mattjoyce/xyz-arm/cad/README.md

XYZ Arm Mk1 low-poly concept
==========================

Files: `xyz-arm.scad` is the assembly; `parts/` holds reusable models; `studies/` holds reference viewers; `previews/` holds rendered images and the section SVG. Original datasheets and third-party references remain in the project root's `datasheets/` and `references/` folders.

Open [xyz-arm.scad](xyz-arm.scad) in OpenSCAD and press F5. Use the Customizer to adjust gantry height, whole-gantry extension, and phone dimensions. All dimensions are millimetres.

The assembly follows `../design.html`: 500 mm vertical and horizontal 2020 rails, four wheels with 150 mm vertical spacing, manual lock, top line guides and counterweight, flat screen-up phone, a second four-wheel plate supporting the sliding horizontal rail, and a tip-mounted light. Orange identifies concept brackets and the balance line. The A4 mat can be hidden.

This is a spatial blockout, not a printable or mechanically validated assembly. The rails now use the dimensioned OpenBuilds profile; hardware remains simplified. The 160 × 76 × 9 mm phone, base, rear counterweight shoe, guide bracket and cradle are provisional. The balance line is exaggerated to 1.1 mm diameter for visibility. Motor provisions and detailed fastener clearances are not modelled yet.

The source's side sketch puts the phone under the rail, while its thermal-pad requirement suggests contact above it. This model uses the latter: phone back on a pad above the rail, with the entire corner camera cluster projecting beyond the rail tip. Actual phone camera position and cradle clearances need measurement. The counterweight follows the carriage in the opposite direction; its guide and travel still need detailed design.

Iteration 2: the phone and light are fixed at the end of the horizontal rail. `gantry_extension` moves the whole 500 mm rail through an independent X wheel plate on the Z carriage. The rail is offset in front of the spine to allow its rear end to pass freely. X wheel stations are provisionally 96 mm apart. The camera cluster clears the tip by 8 mm; phone size and actual camera offsets still need measurement. This supersedes the independently sliding phone carriage in the original design note.

Iteration 3: the balance line now rises inside the front Z slot (negative Y), crosses the top over two provisional 4 mm smooth transverse rods, and descends in the rear slot to a counterweight lug. Two quarter turns keep the top low: the default line centre rises only 5 mm above the extrusion end. Side cheeks leave the slot exits open. `guide_diameter` adjusts the concept rods; no minimum suitable diameter or hardware has been selected. Friction, braid wear, rod finish and retention need evaluation before deciding between smooth rods and miniature pulleys.

Iteration 4: `parts/vslot-2020.scad` defines the shared rail profile from page 1 of `../datasheets/openbuilds-vslot-20x20.pdf`. Open it directly for a 60 mm sample, or enable `section_only` for its cross-section. `previews/vslot-2020-section.svg` is an exported section at nominal millimetre scale.

The profile uses the drawing's 20 mm envelope, 9.16 mm V mouth, 6.25 mm throat, 11 mm internal channel, 1.80 mm shoulder depth, 4.30 mm shoulder-to-floor depth, 90° V, 1.50 mm diagonal webs and Ø4.20 mm bore. The diagonal channel coordinates are derived from the normal web thickness, not traced by eye. Only the undimensioned outer corner radius (0.5 mm) and small central floor notches (0.2 mm) are estimated. The bore uses 64 facets independently of the assembly's low-poly setting. These are nominal dimensions, without manufacturing tolerances.

Validation: the sample exports as a closed mesh (every edge has two incident triangles), with a 20 × 20 × 60 mm bounding box. The complete assembly compiles and renders with the new shared profile.

Iteration 5: `parts/vslot-wheel.scad` replaces all eight cylindrical wheel placeholders with Solid V wheels and nominal 625 bearing pairs. Supplier reference: https://www.makerstore.com.au/product/wheel-solidv-kit/ ; drawing archived as `../datasheets/solid-v-wheel-drawing.jpg`. Uses 23.90 mm OD, 5.90 mm central tread land, 16 mm bearing seats, 14 mm central shoulder opening, and 5 mm axle bores. The kit lists 10.23 mm width whereas the drawing says 10.20 mm; the model uses the kit width. Chamfers are modelled at 45 degrees to mate with the rail faces. Bearing internals, seals, 0.23 mm central shoulder/shim and spacer shapes are simplified nominal representations.

Wheel axes now align with the rail slot centre plane. Tangency of the model's chamfers gives a wheel-axis offset of 20.32 mm from the rail centre (40.64 mm between opposing axles), with no preload. Both plates use nominal 6 mm spacers plus 1 mm external shims. Hex spacers identify the intended eccentric pair on one side of each rail; actual eccentric offsets, plate holes and hardware tolerances still need detailing. These are Solid V wheels, not grooved Dual V or Mini V wheels; confirm the purchased variant before making plates.

Iteration 6: compact carriage replaces the tall Z plate, wide X plate and connecting block. `parts/compact-carriage.scad` is a new 84 × 84 × 8 mm parametric plate, inspired by the Open Task Light body's envelope. It does not reuse that STL's hole pattern. Four wheels on each face preserve the two sliding axes. Both longitudinal wheel spacings are now 60 mm; across-rail spacing remains 40.64 mm. The 8 mm plate and nominal spacer stacks set rail centre separation to 32.23 mm. Mounting holes and two access windows are modelled; eccentric seats and lock hardware remain provisional.

At the original design note's illustrative 2.1 N·m moment, reducing Z spacing from 150 to 60 mm raises the force couple from about 14 to 35 N. This compact layout therefore needs a fresh load and settling check before fabrication. The original Open Task Light mesh remains separately available in `studies/carriage-study.scad`.

Iteration 7: three wheels per rail, six total. Each axis has two fixed wheels 60 mm apart and one central opposing wheel marked for eccentric adjustment. The shared `carriage_z_holes()` and `carriage_x_holes()` functions drive both the plate holes and assembly positions. The outline now follows the six mounting bosses and line/lock supports instead of a full square; a central access hole removes more material. The X lock placeholder is offset to clear its new central wheel. This removes two complete wheel assemblies; actual mass saving depends on purchased hardware and print settings. Eccentric seats, preload, stiffness and lock details remain unvalidated.

Iteration 8: `parts/wheel-spacer.scad` adds four concentric spacers and two eccentric spacers (gold in assembly), one per axis. The eccentric pilot axis is offset 0.395 mm from the axle, interpreting the supplier's approximate 0.79 mm adjustment range as total travel. Each adjustable plate hole follows the pilot centre, while the wheel stays at nominal tangency in the shown position. Supplier: https://www.makerstore.com.au/product/shim-eccentric-8-6/ — 6 mm standoff, 8 mm hex across flats, 10 mm flange, 5 mm bore and 7.11 mm plate hole. Collar length (1.5 mm), flange thickness (1 mm) and pilot diameter (7.08 mm) are provisional; verify against purchased parts. The flange is included within the 6 mm standoff. Hex rotation in the standalone model is an orientation parameter, not an assembled preload simulation. Nominal holes require a fit coupon before printing the final plate.

Iteration 9: removed both placeholder carriage locks, their brackets/pads and extra plate support lobes. The Olight is now fixed beneath the phone on a small magnetic disc connected to the cradle edge, with its lens pointing down. The previous outboard arm is removed. With the nominal 76 mm phone width, the 24 mm torch body sits beside the rail with 2 mm lateral clearance and stays within the phone footprint; the 28 mm disc reaches its edge. Position is toward the phone's non-camera end. Torch and mount remain approximate pending actual Olight dimensions.

Iteration 10: counterweight container is fixed at 20 mm external width across the spine. Depth extends rearward from a fixed front face at Y=14 mm, so increasing capacity does not move it toward the rail. Defaults: 60 mm depth, 90 mm height, 2 mm walls and floor; open top. `counterweight_depth` and `counterweight_height` are adjustable in the Customizer. This gives 78.85 cm³ nominal internal volume at default dimensions. Fill mass depends on material and packing; balance has not been sized from this volume. Rear shoe and line lug remain provisional and fit within the 20 mm width.

Iteration 11: `parts/z-base.scad` is the rotating base — a 140 mm plate that bolts to the turntable bearing and carries the vertical 2020. Ø140 × 51 mm, manifold, prints flat with the socket upward and needs no supports. Eight ribs at 22.5° offsets carry the plate out to the bolt circle, clearing the four mounting holes (128 mm PCD, at 0/90/180/270) and four screwdriver access holes (102 mm PCD, at 45° offsets) used to reach the other race's fixings through the plate.

Which race this bolts to is now settled: the **inner** one. A 2026-09-13 zoom on the race boundary shows countersinks on the outer ring and plain holes on the inner. A countersink seen from above takes a flat head driven downward into whatever sits below, so the outer ring is what screws to the desk and the inner ring rotates and carries this part — standard lazy-susan practice, and consistent with the brief's own fallback.

An earlier note here claimed swapping `mount_pcd` and `access_pcd` was the whole change. **That was wrong.** The underside relief has to move with the bolt circle: the plate bears on its mounting race and must clear the other, so mounting inboard means relieving *outboard*. Relieving the wrong annulus would have left the plate resting on the fixed outer ring and rubbing as it turned. `mount_race` now drives the bolt circle, the access circle and the relief annulus together, and both settings build.

A further trap caught while making that change: the derived values sat above `plate_d` in the file, and OpenSCAD resolved the forward reference to `undef`, so the relief silently evaluated inside-out. The assert caught it; the relief now keys off `bearing_od`, which is declared above and is the more meaningful bound anyway.

No central screw into the rail's tapped Ø4.2 end bore. Its head counterbore (Ø9.5, reaching y = −4.75) collides with the rear slot channel the balance line runs down (y = −3.90 to −8.20 from the profile drawing); the two cannot share the socket floor. The rail is instead held by four M5 bolts into drop-in tee nuts in both side slots at two heights (14 and 34 mm above the plate), which resists the tipping moment as a force couple rather than as clamp friction on a plastic floor. **Slide the tee nuts in before seating the rail** — its lower end is captive in the socket.

The balance line runs straight down inside the rail's rear slot and through a Ø4 hole at y = −6.05, asserted to stay clear of both the slot floor and the shoulder. Keeping it in the slot rather than outside the rail also keeps it near the rotation axis, so a ±45° sweep moves it about 4.6 mm rather than 13.8 mm — which sets how big the hole through the desk needs to be.

Load check: at 2.18 N·m the socket's square section (32.4 mm outside, 20.8 inside, S = 4929 mm³) sees **0.44 MPa**, roughly a hundredth of PETG's yield. Strength is not the question here; stiffness and long-term creep are, which is what the ribs are for. Print with generous wall count rather than relying on infill. Tee bolts see about 109 N each, trivial for M5.

Not yet resolved: the bearing's bore, race boundary and hole pitch circles remain photo estimates from `studies/turntable-bearing.md`, and every one of them feeds this part's geometry. Measure them before printing a final part. The asserts will catch a combination that cannot be built, but they cannot catch numbers that are merely wrong.

Wheel spacing stays compact at 60 mm by explicit decision, accepting about 40 N per wheel pair at the corrected 2.4 N·m rather than 16 N at 150 mm. To be revisited only if it proves to settle too slowly in use.

Iteration 12: the assembly adopts the real base. `frame()` drops the 180 × 160 blockout slab and its accent cone for `turntable_bearing()` on the desk, `z_base()` bolted to it, and the rail seated in the socket floor. The Z datum is now explicitly the **desk surface**: bearing 0–8.5, plate 8.5–14.5, rail seated at 16.5. `base_h` is computed from `turntable_thickness()` and `zbase_rail_seat()` rather than the old hardcoded 12, so changing either part moves the assembly with it. Both parts gained accessor functions for this; `use` imports modules and functions but not top-level variables, so the assembly could not otherwise see their internals.

The counterweight leaves the spine. It was a 20 mm slab riding alongside in the rear slot; it is now a plain pot hanging below the desk on the line, because the desk-mounted build removes the envelope that forced the slab shape. Defaults are Ø60 × 80 mm — about 222 cm³, which is 1.02 kg of steel shot at bulk 4.6 g/cm³, or the same mass in lead at Ø60 × 53. `counterweight_diameter` and `counterweight_height` replace the old depth/height pair. Travel mirrors the carriage: the pot starts 20 mm below the desk and descends as the gantry rises.

The balance line's rear run now goes straight down the rear slot, through the base's Ø4 hole at y = +6.05, and through the desk. `z-base.scad`'s `line_y` moved from the front slot to the rear to match — the sign only selects which slot, and the assert on the channel bounds holds either way. A new `show_desk` draws an 18 mm slab with the 25 mm pass-through, sized for the line's ±45° arc.

The mat also moved. It was drawn at z = −3.5 to −0.5, i.e. floating below the desk surface it is meant to sit on; it now occupies 0–3 with its grid on top.

Clearance check at the bottom of travel: the socket's top lands at z = 59.5 and the carriage's lower edge at `gantry_height` 110 reaches z = 68, leaving **8.5 mm**. The camera then sits about 117 mm above the desk, so roughly 114 mm above the mat's top face — inside the 98 mm close-focus limit with margin, and at the bottom of the 100–300 mm useful band. The socket depth therefore sets the bottom of the working range, and shortening it would buy back travel that the optics cannot use anyway.

Iteration 13: bought and context geometry now carries the `%` background modifier — rails, wheels, spacers, axles, guide rods, the bearing, the balance line, phone, Olight body, mat and desk. They still draw for reference but are excluded from render and export, so what survives an F6 is exactly the set of printed parts: 7050 facets, with the desk and mat gone from the bounding box. This replaced an earlier attempt to back the wheels off the rail by 0.02 mm, which was hacking around a display artefact rather than stating the intent.

`rod()` gained an epsilon extension at both ends. The balance line is drawn as a chain of segments that previously butted end-to-end, sharing an exact coplanar face — the classic way to make a union non-manifold. The counterweight lug and the mat grid lines had the same problem against the surfaces they sat on, and were sunk slightly into them.

On the 2-manifold warning, what was actually established rather than assumed: `frame()` and `moving_arm()` each render clean **alone**, and so does every part in `parts/`. The assembly does not. Toggling the mat, desk and phone off changes nothing, so the cause is not the context geometry. The wheels are placed at nominal tangency to the rail — Iteration 5's note says so explicitly — and two solids touching along a line are neither disjoint nor overlapping, which is exactly the degenerate case. `%` disposes of that for the export.

A warning still remains among the printed placeholder brackets (cradle, lugs, light mount), and is **not** resolved. It is not worth more CGAL renders: parts are printed individually, each one is clean on its own, and the assembly exists to check spatial fit rather than to be exported as a body. Worth revisiting only if those brackets stop being placeholders.

Individual parts are checked separately — `z-base.scad` renders `Simple: yes` with 1248 facets, and all four tee-bolt holes were verified present in its mesh rather than by eye, since the render angle hides the upper pair.

Iteration 14: `parts/base-fit-test.scad` is a Ø145 × 2 mm gauge that answers both open base questions in one short print, rather than committing to the Ø140 × 51 mm part.

Three 2020 apertures at 0.15 / 0.30 / 0.45 mm per side span wide on purpose; narrow the bracket on the next print once this says which end is right. Corner reliefs are included because FDM cannot cut a sharp internal corner — without them the nozzle's corner bulge carries the fit and the flats never seat, so the reading would be corner interference rather than clearance. Both candidate bolt circles are on the rim, so the 102 PCD can be confirmed while 128 stays available as a cross-check on the photo estimate.

Marking is tally holes, not text: round holes print at travel speed where small glyph perimeters do not. They sit below their aperture, which keys the orientation — read them above and the plate is flipped, and the clearance order would otherwise reverse.

Four hull cutouts remove 36 % of the disc, against 12 % for an earlier field of twenty small perforations. Each is verified by `studies/check-cutouts.py`, which measures point-to-segment distance from every cutout to the aperture zone, all eight bolt holes and the rim. Two of the four failed first time. The instructive one was the top cutout: its vertices cleared the diagonal bolt at 12.7 mm while the **edge between two vertices** passed within 5.32 mm — invisible in plan view, and the reason this is checked numerically. Worst case as built is zone 4.50, bolt 7.00, rim 7.55 against needs of 4.0 / 6.6 / 3.5, with left and right deliberately backed 0.5 mm off their exact limits so polygon tessellation cannot eat the margin. Re-run the script after changing any cutout number.

Lightening stops there on purpose. A gauge earns its keep by being a rigid reference; perforate 2 mm further and it flexes, and a flexing plate can be forced onto a bolt pattern that does not line up or deformed around a rail that is really too tight — a false pass on both tests at once.

What the print cannot settle: a 2 mm aperture reads XY clearance almost purely, whereas the real socket is 45 mm deep where wall lean and friction both bite, so the winning clearance will feel tighter at full depth. And the number belongs to the printer, nozzle, material, layer height and XY compensation, not to the geometry.

Iteration 15: the base's eight ribs are gone. A truncated cone now runs from the plate top to the socket mouth: Ø88 at the foot, flat top flush with the top of the socket at 45 mm, Ø49.1 there (the boss's 44.1 mm corner diagonal + 5), so the flank rises at about 67°. The square boss is swallowed whole and the rail rises out of a plain round face. It narrows upward, so it still prints without supports. Asserts keep the foot 2 mm inside the mount screw pilots (whose tips come up through the plate) and the screwdriver access holes. Both tee bolt pairs, at 14 and 34 mm, now sit inside the cone, so their Ø9.5 head bores run straight out through it (about 13 mm deep), and a hex key reaches them from outside. The cone's derived sizes are declared after `boss`, because of the forward-reference trap from Iteration 11.

Socket clearance is 0.375 mm per side, halfway between the gauge's two workable apertures: 0.45 slid on easily, 0.30 went on hard at only 2 mm deep. Mount holes are Ø3.5 pilots for M4 self-tapping screws driven up through the bearing's inner ring. The float lives in the bearing's own loose holes. The rail hold-down is M5 × 8 socket heads into drop-in tee nuts; 10 mm would bottom out in the slot channel. Previews: `previews/z-base.png`, `z-base-section.png`, `z-base-context.png`.

The plate no longer covers the outer race. Mounted on the inner race, it is Ø112: the race boundary estimate (114) less 1 mm radial gap. The access holes and underside relief are gone, and the outer race's countersunk desk screws are simply in the open. That leaves 3.25 mm of plastic outboard of each Ø3.5 pilot on the 102 circle, asserted ≥ 3. The boundary is still a photo estimate, and if the real one is smaller the rim will rub as it turns. `mount_race = "outer"` still builds the full Ø140 plate with access holes and relief.

Edges: the plate and cone are now one revolved profile (the square boss was wholly inside the cone, so it is no longer modelled). Rim chamfers are 1.0 mm top and 0.5 mm bottom; the bottom one also clears elephant's foot. The cone foot has a 4 mm fillet, where the tipping moment concentrates, and its top edge a 2 mm round. The socket mouth has a 1 mm lead-in chamfer and each M4 pilot a 0.5 mm one on the underside. `fillet_pts()` builds both the fillet and the round from the corner and its two edge directions. The four tee bolt bores are left sharp, since they meet the curved flank.

Race boundary taken as 113 (1 mm under the 114 photo estimate), so the plate is Ø111. That cuts the plastic outboard of each pilot to 2.75 mm, and `mount_edge_min` is relaxed to 2.5 to allow it. With four perimeters that is nearly solid wall.

Iteration 16: `z-base.scad` gains `variant = "full" | "fast"`. Full is unchanged: its re-exported STL has the identical vertex set, and it is still `parts/z-base.stl`. Fast is `parts/z-base-fast.stl`, exported with `-D 'variant="fast"'`. It has the same bearing pilots, socket, fit, line hole and tee bolts, at about a third of the volume (70 cm³ against 204).

- **Plate:** a Ø70 hub with four 12 mm arms out to round screw lugs, replacing the Ø111 disc. The lugs reach the same Ø111 rim, so the pilot edge is still 2.75 mm. The arm roots are filleted.
- **Socket:** stands as an open square boss on a 12 mm flared, filleted foot instead of being buried in the cone. The tee bolts rise to 20 and 38 mm, so their counterbores sit on the open boss face above the foot. M5 × 8 still applies, and there are no bores through a flank.
- **Check:** arm bending at the hub is about 6 MPa at 21 N per screw. That is fine for strength, but it is the softest part of this variant.

Context previews now turn the bearing's free inner ring so its holes sit under the pilots.

Tee screw length, corrected. The earlier "M5 × 8, 2.8 mm under the head" was wrong for the model as built. The counterbore starts 1 mm proud of the boss face, so a 3 mm sink left 3.8 mm of wall, and an M5 × 8 would reach only 2.0 mm past the slot lip. The sink is now 4 mm (2.8 mm of wall), which gives 3.0 mm into the tee nut. Asserts now check the stack: M5 × 6 fails as too short, and M5 × 10 fails because it bottoms in the 4.3 mm channel. Both STLs are re-exported.

Iteration 17: the tee bolt holes become nut windows. The rail is held by drop-in tee nuts in its side slots, and once it is seated in the socket the only way into a slot is through the socket wall, so a Ø5.5 bolt bore is no use: the nut has to pass through the wall first. Each station is now a rectangular window, `tee_nut_w + 2·clr` across the slot by `tee_nut_l + 2·clr` along it — 6.8 × 10.8 for the standard 20-series M5 nut (10 × 6 × 4) at 0.4 mm clearance — with 0.5 mm corner radii. The nut goes in long side up the slot, drops through the 6.25 mm throat, and the screw turns it home in the channel, as for any blind drop-in. Both variants share `tee_windows()`.

The head no longer has a full seat: the M5 socket head is Ø8.5 and the window 6.8 wide, so it bears on two 0.85 mm strips beside the window (asserted ≥ 0.75). Screw stack at that point: 3 mm counterbore into the wall, M5 × 8, 3.0 mm into the nut (changed in iteration 19). If the seat crushes, a button-head or flanged M5 spreads it. In the full variant the flank bore grows from Ø9.5 to Ø12 (`tee_access`, asserted ≥ window height + 1) so the nut can pass it on the way to the window; the fast variant keeps the Ø9.5 counterbore, which the window's ends run 0.65 mm past on the open boss face. Top-of-socket and foot clearances now use the larger of head and window. Volumes: full 200 cm³, fast 69. Preview: `previews/z-base-fast-window.png`.

Note for headless work: the revolved body of the full variant does not draw in OpenCSG `--preview` from the command line, only its cutters do. `--render` is fine and all previews are made that way.

Iteration 18: `variant = "fins"`, exported to `parts/z-base-fins.stl`. It keeps the fast variant's hub-and-arms plate and its bare square boss, and takes three things out. The flared foot is replaced by four gusset fins, 2.4 mm thick and 30 mm up the boss, each running from a boss corner out along an arm to 44 mm, short of the lug (asserted). The socket floor is cut out, so the pocket runs through the plate and the rail is located by its tee bolts alone; it can drop on through the bearing bore to whatever is under it, and `zbase_rail_seat()` now returns 0 for this variant so the assembly places it at the plate underside. The boss is turned 45° about Z (`boss_turn`), which is what lets the fins root at the corners and leave the nut windows on the faces alone; the rail's slots, and with them the tee windows and the balance line's rear slot, therefore point at 45°, 135°, 225° and 315° on this base, not down the arms. The lower tee pair goes back to 14 mm, since nothing is in the way. No line hole is cut: the rear slot is open to the underside through the pocket. Fast and fins share `boss_body()`, `tee_counterbores()` and `rail_pocket(through=)`. Volume 53 cm³ against 69 for fast. Previews: `previews/z-base-fins.png`, `z-base-fins-under.png`.

Iteration 19: tee screws are M5 × 10, the length on hand, instead of × 8. The head counterbore now stops 1 mm into the wall rather than 3 (`tee_head_sink` 2, from 1 mm proud of the boss face), so 4.8 mm of wall sits under the head and a 10 reaches 3.0 mm into the nut, the same engagement the 8 had with the deeper sink. The asserts still bracket it: 2.5 mm minimum in the nut, 3.5 maximum before the screw bottoms in the 4.3 mm slot channel. The head stands about 4 mm proud of the boss face in fast and fins, which nothing obstructs; in full it is reached through the same Ø12 flank bore. All three STLs re-exported.

Head diameter measured at 9.26 mm, which is an M5 button head, not the 8.5 mm cap head assumed so far. `tee_head_d` is now that measurement and the counterbore `tee_head` is derived from it, 0.6 mm a side, so Ø10.46. The wider head helps the nut window: the seat strips either side of it grow from 0.85 to 1.23 mm. In full the Ø12 flank bore already clears it. All three STLs re-exported.

Tee nut measured at 9.85 × 5.9 mm, replacing the nominal 10 × 6. The windows follow: 6.7 across the slot by 10.65 along it at the same 0.4 mm clearance, and the head seat strips are 1.28 mm. All three STLs re-exported.

Iteration 20: the tee bolt entry is a switch, `tee_entry = auto | window | round`. A drop-in nut sits wholly inside the slot, so nuts can be loaded before the rail goes in and found blind through a plain Ø5.5 hole; the window only adds fitting a nut with the rail clamped. Auto gives windows where the rail is captive (full, fast) and round holes where it slides through (fins), so on fins the 9.26 mm head gets a full ring seat again and the boss face keeps more of its wall. `tee_holes()` cuts either. Nut loading on fins: bolt heights are 14 and 34 mm above the plate top, so with the rail standing on the desk through the bearing bore the nuts sit about 28.5 and 48.5 mm up from its bottom end. `z-base-fins.stl` re-exported; preview `previews/z-base-fins-holes.png`.

`parts/socket-test.scad` is the top 20 mm of the fins variant's boss on its own (`test_h`), keeping the mouth lead-in: 32.35 mm square, through pocket at the 0.375 mm/side fit, one bolt station, the base's upper one, 9 mm up the piece, with the round Ø5.5 holes and Ø10.46 counterbores, and nothing else. One station tests everything the holes need testing; `tee_holes()` and `tee_counterbores()` take a heights list for it. It is built from `z-base.scad`'s own `boss_body()`, `rail_pocket()`, `tee_holes()` and `tee_counterbores()` under `use`, so it is the same geometry as the base and a pass on it is a pass on the base. 12 cm³. Exported to `parts/socket-test.stl`, preview `previews/socket-test.png`.

Iteration 21: keyhole entry for the tee nuts, after the socket test. Round holes printed and screwed up fine, but loading nuts blind into a 500 mm rail is a fight, and a plain window costs the head its seat. `tee_entry = "keyhole"` puts the nut window above the hole and joins the two with a slot the width of the screw shank: start the screw two turns into the nut, feed the nut through the window into the rail slot, slide the screw down until the head drops into its counterbore, tighten. The nut rides captive on the screw and the head seats on a ring open only on the slot side. The window sits just clear of the counterbore (`keyhole_rise` = 10.56), so it needs 15.9 mm of wall above each hole and two stations do not fit a 45 mm socket: fins goes to a single pair at 27 mm, its window topping out 2.1 mm under the mouth. If one pair lets the rail rock, `socket_h = 55` makes room for two again. Auto now gives keyhole on fins, windows on full and fast; the asserts catch a keyhole into the mouth or into the next station's counterbore, and one into a buried boss. `z-base-fins.stl` re-exported (53 cm³). `socket-test.scad` follows: top 25 mm of the socket, the keyholed station 7 mm up, 14 cm³.

Iteration 22: the two fins stations share one keyhole window. The socket stays 45 mm. The window sits midway between the stations, at 23 mm, and a shank-wide slot runs from it down to the lower hole and up to the upper one: each screw goes in with its nut at the window and slides to its own counterbore, one down, one up. Stations are 10 and 36 mm, a 26 mm couple, with 4.8 mm of wall under the lower counterbore and 2.8 above the upper. `keyhole_dir = drop | lift | shared` picks the layout; auto is shared on fins. `keyhole_mid` is declared after `tee_heights` on purpose, because the first cut of this had it before and the forward reference came back undef: every assert passed, both meshes rendered `Simple: yes`, and neither had a keyhole in it. Check the previews, not just the asserts. `z-base-fins.stl` re-exported, 52 cm³. `socket-test.scad` is now the whole 45 mm socket with both stations, since the shared window spans them, 25 cm³.

Iteration 23: three changes to the fins socket. A flat ledge at the underside of the through pocket, 2 mm in from the pocket wall and 2 mm thick (`ledge_w`, `ledge_t`), so the rail's end sits on it at 2 mm above the plate underside instead of dropping through; the opening below is 16.75 square, and an assert keeps the balance line's rear slot inside it. The boss's top outer edge gets a 1.5 mm chamfer (`boss_chamfer`), leaving a 3.3 mm flat rim between it and the mouth's lead-in. And the tee bolts are on one face only (`tee_sides`, the boss's local +X face, which the 45° turn puts at 45° to the arms): the two screws pull the rail onto the opposite wall, so the ledge and that wall are the datum, rather than two sides fighting over the clearance. `zbase_rail_seat()` returns the ledge thickness for fins. `z-base-fins.stl` re-exported, 54 cm³. `socket-test.scad` follows, with the ledge at its bottom and the chamfer at its top, 27 cm³; previews `socket-test.png` and `socket-test-under.png`.

Iteration 24: `parts/belt-collar-test.scad`, the two collars that anchor a GT2 belt to the spine for the Z brake, on their own. The belt was going to be the brake's rack (kanban `ukrp`); a gravity tilt lock on a smooth rod was considered and parked. The belt lies on the floor of one slot channel, 3.9 mm from the rail centre, its top at 5.28, wholly under the rail's surface, and each end is held by the tip of the base's own tee bolt, an M5 × 10 button head, driven straight into the collar wall and in through the slot throat onto the belt. Not into a tee nut: the channel is 4.3 mm deep under the lips, a drop-in nut about 4 mm tall and the belt 1.38, so the two cannot stack in one channel. The screw forms its thread in the wall, a Ø4.3 hole for M5 in PETG, with the head sunk 2 mm so the 10 mm screw reaches: tip at 4.18 from the rail centre, 1.1 mm into the belt, 3.8 mm of wall under the head, and it cannot bottom on the aluminium floor at 3.9. Two pieces: `ring`, an open 20 mm sleeve standing for the base socket's wall, and either a second ring (`with_cap = false`, the default, 24 cm³ the pair, printed first) or `cap`, the same sleeve with a 3 mm closed top, so that belt tension pulls it down onto the rail's end face and it needs no other fixing. Both use `boss_2d()` and `pocket_2d()` from `z-base.scad`, so the fit is the settled 0.375 mm a side. Asserts check the bite, the floor and the thread depth. Previews `previews/belt-collar-test.png`, `belt-collar-test-context.png`. Test: ring and cap on the two ends of a rail offcut, belt down the +Y channel between them, screws driven until they stop on the belt, and pull. The question is whether a screw tip on rubber holds 10 N without creeping, or the belt end wants a pin through it. Not settled: which slot the belt takes on the spine, since the wheels have both sides and the line has the front slot above the carriage and the rear slot down to the counterweight.

Iteration 25: the Z brake is set aside for balance (see `notes/2026-09-19-balance-and-friction.md`) and two parts follow from that. `parts/spine-cap.scad` caps the spine's top and carries the balance line over it, front to back. It went through three cuts in one sitting: a 32 mm collar on the socket fit with a rear ear placing the line 25 mm behind the rail centre; a 20 × 20 rounded crown pressed into the rail; and, as it stands, a square 20 × 20 × 5 block with a 45° V groove, 3 mm wide and 1.5 deep, so it prints upside down with the groove as a 45° cavity and nothing to support. The top's front edge is chamfered 2 mm at 45° and the V follows the chamfer down to the face (hulled V sections, each turned to stay square to the surface), so the line bends twice by 45° on its way down to the carriage. The rear is flat (`rear_chamfer = false`): the top runs level between the ear blocks to the rail's face and the line drops over that edge into the rear slot, at x = 0. Press fit from the rail's own geometry, and the rail is plain T-slot 2020, which is what Matt has, not the V-slot the rest of the model assumes: a tee tab into each side slot, 5 mm long, stem at the 6.0 opening exactly (0.1 a side over it sheared material going in on the first print), and a head that is a diamond, 45° out from under the lip to the 11 mm channel wall (10.6 wide, 4.2 below the face, a 2.2 mm lip a side) then 45° back in to 8 wide at 5.5 deep, with 0.2 clearance everywhere but the opening. `slot_w`, `lip_t`, `chan_w` and `chan_d` are guesses at generic extrusion and want measuring; the opening is what the fit rides on. No centre peg. Every tab face is vertical or 45°, so the tabs stand up cleanly in the flipped print. The front and rear slots are left open for the line. Nothing else fixes it; both runs of the line pull it down onto the rail's end. `print_flip = true` is the exported orientation. A groove is a capstan and the wrap is 180°, so at 10 N and μ about 0.15 the arm costs about 3.8 N to raise and 6 N to lower; a pulley is the fallback. `parts/load-stack.scad` is the counterweight, from two plan sketches of Matt's (Downloads, 2026-09-19): the stack hangs directly behind the spine, riding two guide threads that hang from the cap's rear corners just outside the rail, with the load line dropping from the cap's rear groove into the rear slot. It went through four cuts in the sitting; what stands is a master load, add-on cells and a keeper, and the file's default view is the pieces in a column with gaps, bottom to top, so they can be pointed at without names. The load line hangs inside the rail's slot, so it never passes through a cell, and the guide threads pass in front of the cells, so only the master and the keeper touch a thread. Each has a 5.5 mm lip that enters the rear slot 4 mm, with the load line's Ø2.5 hole in it 1.5 mm inside the rail's face, Ø2.2 holes for the guide threads 6.5 off centre and 14 behind the rail centre matching the cap, and one split: from the lip's tip through the line hole and back along the centre, then a T out to both guide holes, so the guide threads are pinched together and all three threads go in with one forward push; a thread at its hole would have to be walked 6.5 mm sideways to leave. Every piece is an open box, after Matt found the closed master unprintable: the piece above is its lid. Each cell and the keeper has a foot underneath, the cavity's size less 0.15 a side, 2 mm deep, flaring at 45° out to the box, that drops into the open cavity of the piece below, which registers the stack and closes the shot in; no cones, no bridges, no lids. Matt then asked for maximum cavity and a quick print, the master being a static box: walls, floor and foot went from 2 mm to 1.2 (three perimeters) and the solid front to the least that walls the guide holes and the T. Then the master became a sleeve: Matt has two lead-in-resin blocks, 25 × 60 × 85, from another project, so `use_insert` sizes the master round one (`insert_n = 1`, 27.7 × 70 × 87.7 outside, 37 cm³ of plastic) or two side by side (`insert_n = 2`, 52.7 wide), with 0.3 mm of clearance and the rim standing a foot's height above the block so the cell above still registers; `use_insert = false` gives back the 40 × 60 × 80 shot box. Which it is depends on what a block weighs, since the counterweight must match the arm's 1.05 kg, not exceed it. The block fills the cavity, so the M2 for the line's loop moved into the solid front, 12.5 mm behind the rail centre and 3 off centre to keep it clear of the split, head proud under the master, and the T split and guide holes moved back 1 mm to 15 to make room; the cap's ear grew to 9 mm to suit, and the cap printed that afternoon has its holes at 14, which over 400 mm of thread is nothing. The line's path is out of the lip's hole through an eased exit, along a 1.5 × 0.8 mm channel to the screw, loop under the head; loosen, pull the line through, tighten, and that is the length adjuster. While that printed, Matt asked whether the lip and captures were needed over the full height at all; they are not, so `traps = true` keeps them only at the top and bottom, 3 mm each, the lip becoming two short bearings in the slot and the threads running in air between, each trap wedged at 45° back to the box's face, the top one underneath so it prints and the bottom one on top to match and to carry the M2's thread; 24 cm³ of plastic against 37. The first print of that showed a flaw in the wedge, not the print: a wedge was one hull of the trap's body and its lip, and the hull of a wide body plus a narrow lip is not a T in plan, it fills the corners, so just past each trap the flanks ran diagonally from the lip's tip to the body's corners, inside the rail's face and far wider than the slot. The wedges are now two hulls each, the body's back to the box and the lip's own 45° ramp within its 5.5 mm, so the tongue stays a tongue. Matt spotted it on the printed part. A cell matches the master's section, 18 mm tall, 24 cm³ round one block or 47 round two, about 110 or 220 g of steel shot. The keeper is a 4 mm plate with the same lip and split and the foot, and adding a cell is lifting it up the threads. The height budget is the constraint: the stack mirrors the carriage's 310 mm of travel between the cap and the base, so master, cells and keeper must fit in about 130 mm, and the file echoes what its parameters add up to (122 with two cells). For a kilogram in that height the master wants lead shot or a piece of steel bar; steel shot in this section would need 108 mm on its own. `part = column | master | cell | keeper | print | stack | test`. The test is the master's front only, 20 × 12 × 5, with the lip, the holes, the split and the M2 clamp, 1.1 cm³, exported to `parts/load-stack-test.stl`, for setting the fits: the lip in the slot (5.5 in a 6.0 opening), the line through its Ø2.5 hole and 1 mm split, the guide threads through the T to their Ø2.2 holes, the M2 in its Ø1.7 hole clamping the loop. It echoes those numbers when it opens. Previews `previews/spine-cap.png`, `spine-cap-under.png`, `load-stack.png`, `load-stack-under.png`, `load-stack-plan-front.png`.

Iteration 26: the load stack's two guide lines become one loop, and the base turns it round. Matt's call: down from one of the spine cap's rear anchors, round the base, back up to the other, so there is one thing to tension, at the cap's two M2 clamps. The lines hang 6.5 mm either side of the rail centre and 15 behind it, which is inside the boss's 5.8 mm wall, so `guide_groove()` cuts into the boss's rear (+Y) face. First cut was a long U with a half-ring bottom near the plate; Matt's feedback made it what stands: the tee bolts move onto the same rear face (`tee_on_rear`), so the base has one utility face; the U is square and short, two legs down from the boss top and a bar across, just clear of the upper station's counterbore; the socket first rose to 55 mm to make room, then Matt pointed out that the socket's height is also how far the stack can travel down, so instead the stations came down and together, to 8 and 30 with the shared keyhole at 19, which is as close as the window and the counterbores allow, the legs shortened to 6 mm, and the socket settled at 44; then Matt asked why the U could not come down between the bolts, and it can, because the nuts are always in before the guide line is threaded: the bar sits at the nut window's height, 19, so the line spans the open window in air between two stubs, the legs run down past the upper bolt head at 7.5 mm off centre to clear its counterbore by 1.4, and the socket is only as tall as the upper bolt needs, 38, with 2.8 mm of wall over its head and 2.8 under the lower one. `guide_x` went from 6.5 to 7.5 in `spine-cap.scad` and `load-stack.scad` to match; the cap and master already printed at 6.5 are a millimetre off over 450 mm of line, inside the trap holes' play, so they stand; and it is cut for a thin line rather than a cord, as a T in section, a 1.2 mm mouth 1 deep over a 1.8 mm channel 1.2 deep, so the line presses in and the lip holds it against coming back out. Tension pulls it against the bar's upper wall and the legs' inner corners, in the plane of the face. `guide_x` and `guide_y` match `spine-cap.scad` and `load-stack.scad`. The boss top is at 44 mm, so master plus two cells (128) clears it by 13 mm at the carriage's highest. `z-base-fins.stl` re-exported, 49 cm³. Preview `previews/z-base-fins-groove.png`.

Iteration 27: the guide lines are given up. Matt wired the rig and the master's top pulled away from the channel; the line was clamped under the master, so it hung from its bottom, an inverted pendulum, and no line tension competes with the mass. The rail's own rear T-slot guides it instead. `parts/load-stack.scad` v7: each trap carries a T slider, a 5.5 mm stem through the 6.0 opening and a 10.4 mm head in the 11 mm channel, both sliders entering from the rail's top end before the cap goes on. The head follows the channel's real shape, which Matt pointed out is not a rectangle: full width only for the 1.6 mm below the lips (`chan_str`), then 45° in to 6.2 wide at 5.5 deep, with 0.2 off the lips and the floor. The cap's tabs were reshaped the same way; their first cut was a diamond widest 4 mm down, where the channel has already narrowed, which is what sheared going in. Each slider is slit 1 mm down its middle, Matt's call once the profile proved good, so the load line runs down inside the channel straight through both sliders and out under the master, where a channel on the underside takes it to the M2 and its loop is clamped under the head, as in the earlier cuts; with heads hooked in the channel at both ends the master cannot tilt out whichever end the line pulls from, so the anchor can be underneath and out of the way, and the top trap carries nothing but its slider: it leans in at the top, where the trap's face bears on the rail, and the bottom head hooks under the lips. Matt then held it to the goals, easy to print and no wasted space, and the traps went altogether: the body stands 1 mm off the rail's rear face with no solid front and no wedges, the sliders attach straight to the front wall, 20 mm tall at the top and 10 at the bottom, the top one a plain 5.3 mm overhang printed with support (two added wedges and a 45° subtraction were tried and rejected; the head still needs support under a cut, so it was not worth the shape), and the M2 goes up into the master's floor, thickened to 6 mm to hold it, which is the only height the clamp costs (a bead on the line sitting on the top slider would cost none). The line's channel runs from the slit along the floor's underside to the screw. The T split, the guide holes and the keeper's lip are gone; the lid is a plain plate with a foot. The test piece is one slider on a 20 × 12 × 5 slab with the line hole and the M2, `parts/load-stack-test.stl`; `part = "slide"` is a second, a bare slider 20 mm tall on a handle, printed standing so its section is true, for the sliding fit up and down the channel, `parts/load-stack-slide.stl`. `parts/spine-cap.scad` v3 loses the guide ear: the V groove runs level at the rear to 8 mm from the centre, where a 1.2 mm slit, its front end eased, drops the line through the cap into the channel and runs out through the rear face, so the line is laid in with the cap on; all four top edges get 1.5 mm chamfers, the groove following the front one; the front cannot be shallower than the groove. `z-base.scad`'s U groove is now unused and can go when the base is next touched. All STLs re-exported. Previews `previews/spine-cap.png`, `load-stack-test.png`, `load-stack-master.png`.

Iteration 28: both sliders on the master cut to 5 mm (`slider_h`, `slider_h_bot`). Matt's call: they only capture the master to the slot, they do not guide it, so the 20 and 10 mm of bearing length were doing nothing. Then the top one's support went, on Matt's suggestion: taper the head's edges in to the centre first, then taper back to the wall. Iteration 27's 45° subtraction had sloped in one direction only, from the wall out, and a T's wings start in mid-air beside the stem, which is why the head still needed support. The underside is now z = (wall - y) + max(0, |x| - stem/2), the two slopes added: a wing is held by the stem beside it and the stem by the wall behind it, and every point of the underside has material within 45° below. Three sheared half-spaces intersected with the extruded section (`slider(h, taper)`, `halfspace()`), highest at the head's outer knees and its floor corners, both 6.65 mm, so the top slider is 5 mm of capture over a 6.65 mm taper that bears nothing and comes to a 5.5 mm line on the wall. `top_taper = false` puts the flat underside back. The bottom slider prints from the bed. `load-stack-master.stl`, `load-stack.stl` and `load-stack-test.stl` re-exported; previews `previews/load-stack-master.png`, `load-stack-slider-taper.png` (the top slider from below).

Iteration 29: the gantry plate, `parts/compact-carriage.scad` v2, brought to a print now the wheels and the V-slot are in hand (2026-09-20). What was bought: two sets of four clear V wheels, each with a low-profile M5 × 25, a 6 mm spacer, a thin washer and a nyloc; no eccentric spacers. Matt's call: one printed plate, three wheels a rail, as iteration 7 drew it. Two things fell out of the hardware. The 25 mm screw is sized for a 3 mm plate (plate, spacer, washer and wheel come to 20, leaving 5 for the nut), so every station is counterbored Ø10.5 × 5 from the far face and the head sits on 3 mm of plate, the same stack as a Mini V plate, with 4.8 mm of thread for the nyloc. That counterbore also settles the clash the handoff carried: the two centre stations lie on the other rail's centreline with that rail's face 2.1 mm off the plate, and a 3 mm head sunk 5 deep is 2 mm below the face. Without eccentrics the centre station is drawn `preload` (0.1) inside tangency and the plate's give does the rest; change it and reprint if the wheels are loose or bind. The `eccentric` flag keeps the stepped pilot hole for the day eccentrics are bought.

The balance line ties to the plate's top lobe (r 5) through a 2 mm hole, front to back, at the lobe's centre: thread it through and knot it, Matt's ask. The line hangs 6 mm in front of the rail's face, nothing over 400 mm. Two earlier cuts in the sitting were more than was wanted: a lug reaching into the slot's throat with a slit and a stopper knot, and then a slit in the lobe with an M2 across it. The assembly's placeholder lug box still stands.

Lightened, on Matt's ask: what stays is a 6 mm rim round the outline, a Ø20 boss round every station, a hub round the centre hole and 5 mm spokes from the hub to the three spine stations and the centre gantry station; the two outer gantry stations sit on the rim beside the spine's fixed pair. The windows are whatever is left, opened by a 3 mm offset so nothing narrower than 6 survives, which is also what killed the windows when every station had a spoke. 33.1 cm³ solid to 22.2 with the windows. `lighten = false` puts the solid plate back. `part = "context"` shows both rails and six wheels. Exported `compact-carriage.stl`, 8 mm, prints flat; previews `previews/compact-carriage.png` (gantry face), `compact-carriage-spine.png`, `compact-carriage-tie.png`, `compact-carriage-context.png`.

Also today: the master's sliders proved on the V-slot as printed (a little white grease), so the slot numbers in `load-stack.scad` are frozen at what printed and the datasheet's 6.25 throat and 6.1 floor noted as not material; `spine-cap.scad` untouched, Matt says the cap is fine on the V-slot.

Iteration 30: the gantry plate takes eccentrics after all (2026-09-20). With the first plate printed, Matt found that some of the sets' spacers are eccentrics with a 7 mm collar, so `eccentric = true` is now the default. The flag's old geometry would not have worked: a 2.5 mm collar seat stepping down to a Ø5.3 bolt hole on the same centre, under a 5 mm counterbore, left 0.5 mm of plate under the head and a screw that binds after 0.15 mm of its 0.395 mm orbit. The two centre stations now carry the collar hole (7.11 + 0.1 a side, `ecc_fit`) straight through the 3 mm under the head, as a bought 3 mm plate does, the head bears on its rim, and the counterbore there is Ø11.29 for the head's orbit. The collar's centre sits so the wheel swings from 0.2 clear of the rail (`ecc_slack`) to 0.59 inside tangency, not from tangency inward, so a plate that prints a little tight can still be got onto the rail. `ecc_depth` is gone. The eccentrics measure 8.54 overall, 6 above the shoulder and a 2.5 collar, so the collar stops 0.5 short of the head's seat in the 3 mm under it. Matt has four eccentrics and four plain spacers; the plate uses two and four. `compact-carriage.stl` and `previews/compact-carriage.png` re-exported; `eccentric = false` gives the first plate back.

Iteration 31: `parts/spine-cap-pulley.scad`, the cap with a pulley in it (2026-09-20). Matt rigged the arm and the V groove's capstan friction was too much, as iteration 25 warned it might be; he found a pulley in his parts, 12 OD, 10.3 at the line, 4 wide, ball bearing on a 3 mm bore, and asked for it somewhat hidden. One pulley does it because of where the slots are: with the braid on, the runs leave it 10.67 apart, so centred on the rail's axis with the axle across X it drops both runs into the front and rear slot channels, 4.67 under each face. The cap becomes a closed hood, 20 × 20 × 15.15, with a tombstone pocket 4.6 × 13.5 open to the rail's end; the pulley sits 0.8 above the end because the rail's core is solid under it. 0.3 a side beside the pulley, less than the braid, with 0.15 bosses onto the bearing's inner race. M3 × 16 cap head across, sunk 3.2 in one side, self-tapping 6.9 into a Ø2.7 pilot in the other. The rear run goes straight down the channel; the load stack's slider slits run their full depth, so `load-stack.scad` is untouched. The front run angles out through the slot opening to the gantry plate's tie hole, 6 mm in front of the face, touching nothing, and a 2 mm slit up the hood's front wall to the axle's height lets it through as the angle opens near the top of travel. That angle is the cost: the counterbalance is the line's vertical component, so the last 15 to 20 mm of travel under the hood goes light. Tabs are `spine-cap.scad`'s by `use`. Prints upside down, no support; exported flipped to `parts/spine-cap-pulley.stl`. Previews `previews/spine-cap-pulley.png`, `spine-cap-pulley-under.png`. Same sitting: the master's drag is put down to elephant's foot on its bottom slider, the one piece of it printed off the bed; the lean's couple works out at about 2 N a slider, 1.2 N of drag, not binding. File and grease first; a chamfer in `load-stack.scad` if it needs a reprint; a spare V wheel in the rear slot clears the line (1.8 in against 4.67) and stays the fallback.

Iteration 32: the pulley cap opened up, Matt's ask (2026-09-20): no roof for now, the pulley raised onto a flat floor, and slits at both ends. `open_top = true` is the default in `parts/spine-cap-pulley.scad`: a 2 mm floor across the rail's end (`floor_t`), the pocket a trough open upward, the axle 8.8 above the rail's end, the cheeks 0.5 over the pulley's rim, 15.3 high. The 2 mm slit is cut at the front and the rear, full height and through the floor in to the runs at 5.3 from centre, so the line is laid in from above with the cap already on the rail. `open_top = false` gives iteration 31's closed hood back, which has no floor because the pulley goes in from underneath. Prints upside down, cheeks on the bed, the floor bridging the 4.6 pocket. STL and both previews re-exported.

Iteration 33: the pulley cap in two parts, Matt's idea after the one piece proved tricky to print (2026-09-20): it has tabs on one end and a trough on the other, so neither end is a good bed face. `parts/spine-cap-pulley.scad` gains `part = pair | plate | block | cap`. The plate is the rail interface, 3 mm (`split_t`) with `spine-cap.scad`'s tee tabs under it, printed upside down on its flat top. The block is the trough and cheeks on a flat base, 16.5 high, printed as it stands, with no bridge or overhang but the axle hole. One M2 × 8 cap head down the middle joins them: Ø4.2 × 2.2 counterbore in the trough's floor (3.2 thick, 1.0 left under the head; the head passes down the 4.6 pocket), Ø1.6 pilot through the plate, 4 mm of tip free in the rail's Ø4.2 bore. The line's load clamps the joint, so the screw only locates; one screw leaves yaw to friction, and both faces are bed faces, so each also has two blind Ø2 × 2.5 holes at x = ±6.5 for stubs of 1.75 filament as dowels. Both parts carry the front and rear slits. 19.5 above the rail's end in all, against 15.3 for the one piece; axle at 13. Exported `parts/spine-cap-plate.stl` (flipped) and `parts/spine-cap-block.stl`; The one-piece open cap's STL is renamed `parts/spine-cap-onepiece.stl`, so it is not mistaken for the pair. Previews show the pair apart.

Iteration 34: `parts/weight-base.scad`, a weighted foot (2026-09-20). Matt has a 1.25 kg dumbbell plate, about 150 OD, 28 bore, 15 thick at a 10 mm rim and a 60 mm hub, the web between recessed 4.5 on both faces. His design: a Ø200 × 2 under disc on the desk with a Ø28 hub the iron drops over, a 2 mm over disc on top, one M4 down the centre clamping the three, and the bearing's outer race M4'd to the over disc. It replaces desk screws and the clamped board. Resisting moment is weight × footprint radius against about 2.1 N·m at full reach: the bearing loose on the mat gives 1.8 and tips; 3.9 kg on a true 100 mm footprint gives 3.8. A rear weight on the gantry rail was considered and dropped: at full extension the rail's rear end is about 50 mm behind the spine, so 300 g there takes off 0.15 N·m, and has to be matched on the master. Lightening the front is the better lever, 0.39 N·m per 100 g at 400 mm: a printed cradle for the bare phone in place of the Manfrotto clamp is next. Two departures from the flat discs asked for, each switchable. `ribs` (12): a low wall round the iron and gussets out to the edge, because a flat 2 mm overhang bends at about 27 N/mm and the pivot stays at the iron's edge, 75 mm. `seat_h` (4): a raised ring under the outer race only, since the race's holes at r 64 (photo estimate) sit over the iron's rim from r 65 and a screw through a flat 2 mm disc lands on iron; the M4s self-tap 6 mm of plastic and nothing comes out below, the ring stiffens the disc against the rear screws' lift, and it stops short of the race boundary so the turning inner race hangs over air. `seat_h = 0` asserts unless a nut under the disc clears the rim. Hub 27.5 × 14.5, 0.5 short of the iron so the M4 clamps iron; Ø3.5 pilot down the hub with a nut trap underneath as a fallback. Bearing sits 23 above the desk. OD, bore and `outer_pcd` are unmeasured. Exported `parts/weight-base-under.stl`, `parts/weight-base-over.stl`; preview `previews/weight-base.png`.

Iteration 35: the weighted base's under part becomes four spokes (2026-09-20). Matt: the Ø200 disc would take a very long time to print and it is not there for weight, so four spokes from the hub out to 140. `under_style = "spokes"` is now the default in `parts/weight-base.scad`; `"disc"` keeps iteration 34's. A Ø64 × 2 hub disc under the iron's hub, the Ø27.5 hub on it, and four 20 mm spokes to r 140 with rounded tips. With four feet the arm tips over the line between two, so the footprint is 140 cos 45 = 99, what the disc gave, and 140 along a spoke. The 2 mm spoke must pass under the iron's rim and that 10 mm neck is a hinge (a 0.5 N·m push leans the arm nearly 4° through it), so the moment goes another way: each spoke has a post beside the iron's OD, 8 radial × 14 tall, with a Ø3.5 pilot for an M4 jack screw run in until it touches the iron at mid thickness. The iron's edge pushes out on the screw, the flange pulls back in tension to the hub, and that couple is what the desk reacts at the tip; a 3 mm gusset runs from the post's top down to 3 mm at the tip. The four screws also centre a casting whose OD is not true to its bore. `jacks = false` leaves plain posts at 1.5 clearance, which rock by that much. 45.8 cm³. Exported turned 45°, tips to the bed's corners: 204 square. The over disc is unchanged.

Iteration 36: the under part is a wheel, as Matt asked: one hub, one outer ring, four spokes, all 2 mm and flat on the desk (2026-09-20). Iteration 35's posts, jack screws and tall gussets are gone from `parts/weight-base.scad`: "no ribs", then "8 ribs but only 4 mm max and subtle". `under_style = "wheel"` (default; `"disc"` keeps iteration 34): Ø200, a 12 mm ring, 20 mm spokes, a Ø64 disc under the iron's hub, the Ø27.5 × 14.5 hub with its M4 pilot and nut trap. Each spoke has two ribs along its edges, 2 × 4, eight in all, sitting in the iron's recess over the web (4.5 deep) and stopping 2 mm short of the hub and rim flats, so with the iron on none of them shows; `rib_outer` adds a fading pair outside the iron, off by default because it does little. 39.8 cm³, 200 square on the bed. What this accepts, recorded not argued: the spoke is a bare 2 mm strip under the iron's rim, which is a hinge, so the ring is a catch after several degrees of lean and the footprint that counts is the iron's own 75 mm: 1.35× at full reach now, about 2× once a printed cradle replaces the Manfrotto clamp. `rib_seat = true` is the way back: ribs unbroken hub to ring with the iron sitting on them, 4 mm higher. Over disc unchanged. Previews `previews/weight-base.png`, `weight-base-under.png`.

Iteration 37: `rib_h = 0`. Matt: no ribs, this is just a test. The wheel is hub, ring and four flat spokes, nothing else. `rib_h = 4` brings the eight hidden ribs back. `weight-base-under.stl` and its preview re-exported.

Iteration 38: the over part is a wheel too, Matt's ask (2026-09-20). `over_style = "wheel"` (default; `"disc"` keeps the full disc and seat ring): a Ø64 disc over the iron's hub with the centre M4's clearance hole, an 18 mm flat ring on the iron's rim out to Ø150, and four 20 mm spokes between, each running out to one of the race's screws. The seat is cut down to a Ø18 pad at each screw, clipped to the outer race's width, so the race stands on four pads and the turning inner race still hangs over air. 29.4 cm³ against 56.8. `seat_h` goes from 4 to 5: it is also the room under the inner race for the heads of the base's bolts, which sweep over the spokes, and an M4 cap head is 4; the M4s into the race now tap 7 mm of plastic and the bearing sits 24 above the desk. `outer_pcd = 128` is no longer a bare photo estimate: the 2026-09-13 fit gauge carried that circle on its rim and Matt reports the outer holes were fine. Also put back: three asserts and the stack echo that iteration 36's edit had cut out of the file by mistake. Both STLs re-exported; previews `previews/weight-base.png`, `weight-base-over.png`.

Iteration 39: both hub discs Ø64 to Ø55 and all spokes 20 wide to 12, Matt's ask (2026-09-20). The over part's seat pads stand wholly on its ring, so the narrower spokes take nothing from them. Both STLs and the three previews re-exported.

Iteration 40: the over part's seat pads, Matt's asks (2026-09-20): 4 mm tall again (`seat_h`), eight of them (`pads`), every other one at a screw and all standing on the ring, and none under the inner race. They never were, but the inner edge was only 1 mm outside a race boundary that is itself a photo estimate (113, thought to be 114); `seat_in = 2.5` now starts the pads at r 59, leaving 3.25 mm of pad inboard of each screw's pilot. Bearing sits 23 above the desk; the M4s tap 6 mm. With 4 mm pads an M4 cap head under the inner race would touch the spokes: pan or button heads there. `weight-base-over.stl` and previews re-exported.

Iteration 41: `parts/camera-mount.scad`, a light mount for the gantry rail with a hole to tap 1/4-20 (2026-09-20). It follows from the tipping sums: the Manfrotto clamp and its block are most of what hangs at the long end of the lever, and each 100 g there is 0.39 N·m at 400 mm. An L bracket, 40 long: a 5 mm side plate against the rail's outer side face with two Ø5.3 holes 25 apart for M5 × 10 into drop-in tee nuts, and an 8 mm shelf under the rail with the 1/4 hole on the rail's centreline, so the load hangs straight down and nothing twists. The hole is Ø5.3, a 5.1 tap drill plus 0.2 for a printed hole closing up, with a 1 mm lead-in underneath. Outside corners rounded 2 mm; the inside corner, where the rail sits, sharp (a first cut put a 2 mm ridge there by mistake, caught on the render). Printed standing on the L profile, so every hole is a small horizontal one and the thread is tapped across the layers. 11.6 cm³, about 14 g. The top and bottom slots are the wheels', so the bracket lives outboard of the carriage and doubles as the rail's stop at that end. A ball head has a female base: join it with a 1/4-20 stud. Exported flipped to `parts/camera-mount.stl`; previews `previews/camera-mount.png`, `camera-mount-under.png`. Lamp ideas for Matt's steel strip and magnetic Olight were talked through the same sitting, nothing drawn.

Iteration 42: the camera mount hangs from the rail's own slot, Matt's idea: one tee nut would do, but an Allen key is a hassle, so reuse the channel profile and hang it under the 2020 (2026-09-20). `style = "slide"` is the default in `parts/camera-mount.scad`; `"bolt"` keeps iteration 41's L bracket, now exported as `parts/camera-mount-bolt.stl`. A 20 × 12 × 30 block with a T on top that is `load-stack.scad`'s slider section with its numbers copied as frozen from what printed on this V-slot (stem 5.5, head 10.4 to 3.2 up, 45° in to 6.2 at 5.3, 0.2 off the lips and floor). It slides into the rail's underside slot from the rail's end. The 1/4-20 hole is Ø5.3 on the centreline, blind at 11 deep because the stem over it is no wider than the hole, with a lead-in. No fastener: the camera's weight seats the T's shoulders on the lips and friction holds it along a level rail (PLA on aluminium wants about 17° to slide). Hanging, it sits 0.2 lower than drawn, so an off-centre load can set it over about a degree until the block's top corner meets the rail. 8.1 cm³, about 10 g. Printed standing on the profile, so there is no overhang anywhere and the thread is tapped across the layers. The underside slot is the lower wheels', so it lives outboard of the carriage and is the rail's stop at that end.

Iteration 43: the weighted base failed on the bench (2026-09-20). Matt printed both wheels (`weight-base-under.stl`, `weight-base-over.stl`, 2 mm, no ribs) and reports: the rig still leans and the under part's ring just bends; the over part bends the same way; together the lean is embarrassing. This is the hinge iterations 35 and 36 described: 2 mm PLA cannot carry a tipping moment across a gap, above the iron or below it, and the iron's mass does nothing once the plastic between it and the bearing flexes. Lesson for whatever replaces it: the load path from the bearing's outer race to the desk must be in compression through something stiff, with no thin printed span in bending anywhere in it. Matt's next idea: he has other 2020 lengths, 300 mm, and two of those as feet would at least stabilise one axis. `weight-base.scad` and its STLs are kept as the record, not as a candidate.

Iteration 44: `parts/v-base.scad`, the V base (2026-09-20). Matt's scheme after iteration 43: two 300 mm 2020 rails flat on the desk, joined at a right angle with his two 90° brackets, and printed blocks like the camera mount, a T slider with a hole, slid along the rails' top slots until they sit under the outer race's holes. The race's four holes are a 90.51 mm square (128 PCD), and on an L three of them can lie on slot lines: on rail A at x = 10 and 100.51, on rail B at y = 100.51, measured from the rails' outer corner, which puts the spine 78 mm out from the corner along the diagonal, inside the V. The fourth hole, the one toward the work, is over bare desk, and it is the one forward tipping presses down, so it gets a foot: a Ø24 × 25 pillar from desk to race with a Ø3.5 pilot 14 deep. The three blocks only hold the race down; the rear one sees about 28 N at full reach. Block: a 20 × 20 × 5 pad on top of the rail (`spacer`, because the inner race turns and the base's bolt heads hang under it; an M4 cap head is 4), `load-stack.scad`'s frozen T under it in the slot, Ø3.5 pilot right through for an M4 × 16. Printed standing on the profile, so the pull on the T runs in the layers. Forward footprint, spine to the line between the rails' tips: 148 mm, so the rig alone (2.6 kg) resists 3.8 N·m against about 2.1, before any ballast; the dumbbell plate can sit near the corner as dead weight later. Race stands 25 above the desk. Exported `parts/v-base-block.stl` (print three) and `parts/v-base-foot.stl`; `part = "layout"` shows rails, blocks, foot and race; previews `previews/v-base.png`, `v-base-plan.png`.

Iteration 45: the V base's rails are plain T-slot (Matt). Generic T-slot 2020 varies most in its lips and depth, so `v-base.scad`'s T is slacker than the frozen slider where slack costs nothing: shoulders 0.4 under a 1.8 lip (`lip_clr`), head 0.5 off a 5.5 floor (`floor_clr`), so it still enters a 2.2 lip or a 5.35 channel. The block sits on its rail, not clamped to it; the slack is how far the rear block lifts before it holds. `v-base-block.stl` re-exported. Print one and try it before the other two.

Iteration 46: the gantry plate's eccentrics only grip at the very end of their travel; short of that the slop is unreal (Matt, 2026-09-20, on the second print). So real contact is about 0.59 inside drawn tangency, not at it. Where the half millimetre goes: the four fixed wheels sat in Ø5.3 holes and the preload could push each 0.15 off the rail; printed hole positions; and the clear wheels want some squeeze before they stop rattling. `compact-carriage.scad`: `ecc_slack` 0.2 to -0.1, so the travel runs from 0.1 to 0.89 inside drawn tangency and the old grip point sits near its middle, and `bolt_hole` 5.3 to 5.1 on the fixed stations (ream 5 mm) so the datum pair cannot shift. The loose end is still about 0.4 short of real contact, so the plate slides on. `compact-carriage.stl` re-exported: a third print.

Iteration 47: the V base's blocks become right angles on tee nuts, Matt's call (2026-09-21): they will not be moved, so they need not slide. `block_style = "angle"` is the default in `parts/v-base.scad`; `"slide"` keeps the T block. The same 20 × 20 × 5 pad on top of the rail, a 5 mm leg down the rail's outer side face to 2 mm off the desk, one Ø5.3 hole at mid height for an M5 × 10 into a drop-in tee nut, and a 5.6 × 1.6 rib under the pad that drops into the slot's 6.0 opening, which squares the bracket and gives the M4 6.6 mm of plastic to tap. The rear bracket's lift now goes pad, corner, leg, M5, nut, and no printed T under printed lips carries anything; the T-slot's unknown lips stop mattering. It goes on from above. Positions unchanged: rail A at 10 and 100.51, rail B at 100.51, legs on the outer faces, foot under the fourth hole. Printed standing on its profile, no overhang. `v-base-block.stl` re-exported (print three); previews `previews/v-base.png`, `v-base-block.png`.

Iteration 48: the bolted camera mount goes to one tee nut, Matt's call (2026-09-21). `style = "bolt"` in `parts/camera-mount.scad` is still the right angle piece, a 5 mm side plate and an 8 mm shelf under the rail that keeps the material for the 1/4-20 thread, but 30 long now with a single Ø5.3 hole on its centre for an M5 × 10 into a drop-in tee nut. One bolt would let it pivot, so the shelf carries a low key in the rail's underside slot: 5.5 wide (the slider's stem, 0.25 a side in the 6.0 slot), 1.5 high, short of the 1.8 lips so it only locates and never reaches the channel, 0.5 lead-in on its top edges, and split with an 8 mm gap around the 1/4 hole. A stud through the shelf must stop at the rail: the slot is narrower than 1/4 in. `style = "slide"` is unchanged and still the default. Exported flipped to `parts/camera-mount-bolt.stl`; preview `previews/camera-mount-bolt.png`.

Iteration 49: a hybrid was drawn and dropped the same day (2026-09-23). `parts/gantry-carriage.scad` puts the bought four-wheel metal plate on the spine and a printed three-wheel gantry plate on its back, joined by M4. The first cut had the M4 nuts in pockets at the joint face, so tightening would have pulled each nut onto the aluminium and left the printed plate unclamped; the nuts moved to the front face before Matt changed his mind. The file and its STLs stay as a record. The metal plate's holes in it are photo readings and were never checked.

Iteration 50: the gantry plate gets a fourth spine wheel, an eccentric, Matt's call (2026-09-23). With three, the arm's moment about the spine was held only by the centre eccentric's preload, and pulling down on the arm lifted the top fixed wheel off the rail. The spine set in `parts/compact-carriage.scad` is now two fixed wheels at x = -20.32, y = ±30 and two eccentrics opposite at x = +20.32, y = ±30, so the moment goes into the rail as a diagonal couple over the 60 mm pitch, about 6.7 N a wheel per newton at 400 mm. The old centre station at (20.32, 0) is gone, and with it the one spine head that sat under the gantry rail. The gantry set is unchanged. The new stations sit 13.7 mm from the gantry's fixed pair at (±30, -20.32), which clears each other's spacer and counterbore on both faces; the tie lobe at y = 37 is 20 mm from the top pair. The eccentric seats are the same as before, the 7.31 collar hole through 3 mm under a sunk head, which is the seat whose bolt skewed on the second print. Nothing else changed: 8 mm plate, M5 × 25, 5 mm counterbores. The plate now uses three of Matt's four eccentrics and seven of the eight wheels. The 3 + 3 plate's source, STL and previews are in `backup/2026-09-23-compact-carriage-3wheel/`. `compact-carriage.stl` re-exported; previews `previews/compact-carriage.png` (gantry face), `compact-carriage-spine.png`, `compact-carriage-context.png`.

Iteration 51: the eccentric collar holes open from 7.31 to 7.5 (Matt, 2026-09-23). At 7.31 the 7.0 collar was very tight in the last print, so holes that size print about 0.3 small here. `ecc_fit` in `parts/compact-carriage.scad` goes from 0.1 to 0.195 a side. The collar's centre and so the eccentric's travel are unchanged, and the orbiting head still bears on the hole's rim: its nearest edge is 4.36 from the hole's centre against a 3.75 radius. The fixed 5.1 holes and the Cura modifier `compact-carriage-solid.stl` are unchanged. `compact-carriage.stl` re-exported; previews `previews/compact-carriage.png`, `compact-carriage-spine.png`.

Iteration 52: the load stack becomes a washer box (2026-09-24). Matt wanted 50 × 50 pieces with firmer stacking in place of the shot cells and the lead block. Bunnings' Macsim 50 × 50 × 5 galvanised square washer, 79.68 g each on the listing, carries about 2.5 times the mass per millimetre of the lead-in-epoxy blocks, which weigh 406 g in 85 mm. So `use_washers = true` (the default) in `parts/load-stack.scad` turns the master into one open box holding 14 washers, 1.116 kg, and drops the cells and the lid. Thirteen washers make the 1.02 kg budget, and the fourteenth leaves room to trim 80 g at a time. The four walls locate every washer, which is all the stacking registration there is now. The inside is 51.5 square, 0.75 a side, because hot-dip galvanising runs over size; the walls are 2.0, so the box is 55.5 × 55.5 × 77.5, down from 132 for the old column. It is wider than the rail, and the carriage's spine wheel nuts stand about 2 mm proud of the rail's rear face (Matt), so the box stands 3.5 off that face, not 1. The T sliders' stems are 2.5 longer to reach, the top slider's taper grows to 9.15, and the M2 moves back to 3.5 behind the front face. The slot fit is unchanged. Measure the washers before printing: `washer` is [50, 50, 5] from the listing. There is no finger room, so lift washers out with a magnet. The spine cap is a 20 × 20 hood inside the rail's footprint, so the wider box clears it at the top of travel; clearance to the base at the bottom has not been checked at the new width. v7's source and STLs are in `backup/2026-09-24-load-stack-v7/`, and `use_washers = false` gives v7 back. `load-stack-master.stl` re-exported; previews `previews/load-stack-master.png`, `load-stack-washers.png`.

Iteration 53: the washer box opens up, Matt's idea (2026-09-24): a front wall and corners, not a box, so a washer comes off by hand. `washer_frame = true` cuts everything above the floor away except the front wall, which carries both sliders, and an L post in each corner with 12 mm legs. That leaves a 27.5 wide opening in each side and in the back, floor to top. The posts stand alone above the floor, so `washer_wall` goes from 2.0 to 2.4 and the frame is 56.3 × 56.3 × 77.5. The floor, the M2 clamp and the sliders are as iteration 52. `washer_frame = false` gives the closed box. `load-stack-master.stl` re-exported; previews `previews/load-stack-master.png`, `load-stack-washers.png`.

Iteration 54: an M16 stem up the middle of the washer frame, Matt's call (2026-09-24). `washer_stem = true` stands a Ø16.5 printed stem on the floor at the frame's centre, up to the top of the posts, with a 1.5 chamfer at the top so a washer finds it. The M16 square washers' hole is nominally 17.5 to 18, which gives 0.5 to 0.75 a side: measure it and set `stem_d`. The stem only locates, it carries nothing, and it is clear of the M2 clamp near the front. The corner posts stay; `washer_frame` and `washer_stem` switch separately. `load-stack-master.stl` re-exported; previews `previews/load-stack-master.png`, `load-stack-washers.png`.

Iteration 55: the rear corner posts go, Matt's call (2026-09-24): with the stem through them the washers are not going anywhere. `rear_posts = false` leaves the floor, the front wall with its two 12 mm corner legs, and the stem; sides and back are open floor to top. The front wall now meets the floor alone: the top slider's reaction, about 5 N at 70 mm, is roughly 7 MPa in a 56 × 2.4 wall at its base before the legs stiffen it, well inside PLA. `rear_posts = true` puts the posts back. `load-stack-master.stl` re-exported; previews `previews/load-stack-master.png`, `load-stack-washers.png`.

Iteration 56: the washers are bought and an M16 bolt is the stem (Matt, 2026-09-26). Bunnings had twelve of the 50 × 50 M16 square washers; they weigh 86 g each, not the listing's 79.68, which is 4.9 mm of steel, so `washer` stays [50, 50, 5]. Matt also bought an M16 hex bolt, 65 long under the head, head 24.11 across flats and 10.5 deep, 129 g. `bolt_stem = true` sinks the head flush into the floor from above in a hex pocket (0.2 a side and over), flats to the sides, over a 2 mm skin, so the floor is now 12.7 and the pocket stops the bolt turning. The shank is the stem, and `washer_stem` (the printed one) is off. Twelve washers stand 60 on the floor round the head, the shank 5.2 above them. Total 1.161 kg, against the 1.02 kg budget: trim by taking washers off, 86 g each, eleven with the bolt being 1.075 and ten 0.989. The pocket stays 10 mm clear of the M2 clamp. The frame is 56.3 × 56.3 × 74.2, down 3.3. `load-stack-master.stl` re-exported; previews `previews/load-stack-master.png`, `load-stack-master-pocket.png` (the floor from behind), `load-stack-washers.png`.

Iteration 57: 2 mm clear of the carriage's nylocs, Matt's number (2026-09-26). The frame's front wall already stood `nut_proud` (2) plus `nut_clr` (1.5) off the rail's rear face; `nut_clr` goes to 2, so the wall is 4.0 off the rail and 2.0 behind the nuts. The sliders' stems grow 0.5 to reach the slot and the top slider's taper to 9.65; the slot fit, the frame and the bolt pocket are unchanged. `load-stack-master.stl` re-exported; previews `previews/load-stack-master.png`, `load-stack-master-pocket.png`, `load-stack-washers.png`.

Iteration 58: two small parts for the arm, Matt's ask (2026-09-27). Matt has the washers on the rig and says the 50 × 50s are great. `parts/arm-end-cap.scad` is a lid for each end of the gantry 2020, 20 × 20 × 3 with a 1 mm chamfer round the top. It carries nothing. The press fit is `spine-cap.scad`'s `tabs()` by `use`, unchanged, the two tee tabs that already hold the spine cap on this V-slot. The cap is square, so the tabs go in either pair of slots. It stays inside the rail's 20 × 20, so it does not stop the rail's travel. Printed upside down, tabs up, no support, 1.6 cm³. Print two. `parts/arm-strip-collar.scad` holds Matt's steel strip, 2 × 15.5, flat on one face of the rail and running along it. It is a band round the rail, 1.6 mm wall and 10 long, with a bump over one face for the strip. The pocket is open to the rail (`floor_t = 0`), so the strip lies on the aluminium, on the 3.2 mm flats either side of the V mouth, and pushing it in pulls the band tight. One push fit holds both the strip and the collar, and with the strip out the collar slides along the rail. Fits come from what this printer has shown. The pocket is 15.8 wide and the rail plus strip stack has 0.15 a side, the fit that was very tight on the eccentric collars. The band has 0.30 a side across the rail, which went on hard in the base gauge. The band is thin enough to give. Bore and pocket have 0.5 lead-ins at both ends and the bore's corners have 0.4 reliefs. 23.8 × 25.5 × 10, 1.4 cm³, under 2 g. Printed standing on its section. It stands proud of the rail, so it lives outboard of the carriage and stops the rail there. Matt confirmed the strip runs along the rail. One collar 10 mm long is still a guess. A strip that overhangs the rail's end with the torch on it levers against the collar, and a second collar further back would take that better than a longer one. `floor_t = 0.8` gives a closed pocket if the strip should not touch the rail. Exported `parts/arm-end-cap.stl` (flipped) and `parts/arm-strip-collar.stl`; previews `previews/arm-end-cap.png`, `arm-end-cap-under.png`, `arm-strip-collar.png`, `arm-strip-collar-plan.png`, `arm-strip-collar-context.png`.

Iteration 59: the U groove comes off the fins base (2026-09-27). Matt saw it on the model and asked what it was. It was iteration 26's channel for the guide line loop, and iteration 27 gave the guide lines up. `parts/z-base.scad` loses `guide_groove()`, its `guide_*` settings and its two asserts. Nothing else moves. The tee bolts stay on the rear face at 8 and 30 with the shared keyhole at 19, and the socket stays 38, because that height is also the load stack's travel. The rear face is plain round the keyhole. 49.4 cm³, up 0.15. `z-base-fins.stl` re-exported; previews `previews/z-base-fins.png`, `z-base-fins-rear.png`. `previews/z-base-fins-groove.png` is the old face, kept as the record. Found on the way: `variant = "full"` and `"fast"` have not built since iteration 26 cut `socket_h` to 38. Their upper bolts at 34 and 38 run off the top of the socket and the assert stops them. Their STLs are from before that and still stand. Fins is the base in use, so nothing was changed for them.

Iteration 60: `parts/washer-holder.scad`, a holder on the V base for the spare washers, Matt's ask (2026-09-27). His scheme: a 50 × 50 × 2 plate on top of one of the base's rails with a post for the M16 holes, fixed by a tee nut in the rail's side. The plate is centred over the rail and the leg runs down from under it, 10 off its centre, where the rail's side face is. It is `v-base.scad`'s angle bracket with a wider pad. The leg is 5 thick and 50 long, stops 2 above the desk, and has one Ø5.3 hole at the plate's middle for an M5 × 10 into a drop-in tee nut. A 5.6 × 1.6 rib under the plate sits in the top slot's opening and squares it. The post is Ø16 × 33, room for six washers, 0.52 kg, with 3 mm over. `spares` sets the count, and Matt did not give one. The plate overhangs the rail 15 a side at 2 mm, which is fine because the washers are steel and sit on the rail through it. One piece cannot print without support, since the post goes up and the leg goes down. So it is two parts joined by an M3 × 16 cap head up through the plate, tapping 14 mm of a Ø2.7 pilot in the post. The screw's head hangs in the rail's top slot, 5.5 in the 6.0 opening, and the rib has an 8 mm gap round it. Fit the post before the bracket goes on the rail. The bracket prints upside down, plate on the bed, 9.7 cm³. The post prints as it stands, 6.5 cm³. `part = "whole"` is the one piece with no M3, printed on its end with support under the post. Exported `parts/washer-holder-bracket.stl` (flipped), `parts/washer-holder-post.stl` and `parts/washer-holder-whole.stl` (on its end); previews `previews/washer-holder.png`, `washer-holder-under.png`, `washer-holder-context.png`. Not checked: where along the rail it clears the turning base and the load stack.
