mattjoyce/xyz-arm/knowledge/references/design-note.md

---
type: Design Note
title: XYZ Arm Mk1 design note
description: "design.html: the original design with mass budget, tipping moment, wheel spacing, lighting angles, field of view and deflection."
timestamp: "2026-09-12T00:00:00Z"
resource: design.html
status: partly superseded
tags: [design]
---

[`design.html`](../../design.html), written before anything was printed. Still the place for
the first-principles numbers:

| Topic | Result |
|---|---|
| Moving mass | 1078 g with power bank, 878 g without |
| Tipping moment at 400 mm | about 2.4 N·m |
| Pixel 6a field of view | 65.4° × 51.4°, frame width 1.283 × height |
| Useful camera height | about 100 to 300 mm |
| Gantry droop at 400 mm | 0.21 to 0.26 mm, about 0.15 % scale at 150 mm |

Superseded in places: the counterweight location, the wheel spacing (150 mm became 60) and
the base. See [counterweight behind the spine](/decisions/counterweight-behind-spine.md).
