mattjoyce/xyz-arm/knowledge/index.md

okf_version: "0.1"

# XYZ Arm knowledge bundle

Parts, decisions and references for the XYZ Arm, a counterbalanced phone camera arm. Start with the [project overview](project/xyz-arm.md).

# Subdirectories

* [project](project/index.md) - The project as a whole.
* [parts](parts/index.md) - One concept per OpenSCAD part: current, test, retired and library models.
* [decisions](decisions/index.md) - Design decisions with their reasons.
* [references](references/index.md) - Design log, design note, analyses, datasheets and prior art.
