mattjoyce/xyz-arm/knowledge/log.md

# Directory Update Log

## 2026-10-27
* **Update**: Third-party drawings and HANDOFF.md removed from the repository; references now point to their sources.
* **Creation**: Established the bundle from the [design log](/references/design-log.md) through iteration 60: the [project](/project/xyz-arm.md), 22 parts, 8 decisions and 7 references.
