mattjoyce/xyz-arm/knowledge/decisions/v-base-not-weighted-base.md

---
type: Design Decision
title: "V base, not a weighted base"
description: "The arm stands on two 2020 rails in an L rather than on a dumbbell plate between printed discs, because the printed discs bent."
timestamp: "2026-09-20T00:00:00Z"
status: settled
tags: [base]
---

The [weighted base](/parts/weight-base.md) put 2 mm of printed plastic in bending above and
below the iron. The rig leaned and the under ring bent. The [V base](/parts/v-base.md) makes
the aluminium rails the structure and keeps every printed block small and in compression or
tension through a tee nut.

The rule that came out of it: everything between the bearing's outer race and the desk is
stiff and in compression. PETG is about 35 times floppier than 6063 for the same section.
