mattjoyce/xyz-arm/knowledge/project/index.md

# Project

* [XYZ Arm](xyz-arm.md) - A counterbalanced 2020 V-slot desk arm that holds a phone camera over a bench calibration mat.
