mattjoyce/xyz-arm/knowledge/references/captures.md

---
type: Photo Set
title: Bench camera captures
description: "DeskCam stills of the bearing, braid, first prints and the arm's first frame, each with its camera settings sidecar."
timestamp: "2026-09-20T00:00:00Z"
resource: captures/README.md
tags: [photos]
---

[`captures/README.md`](../../captures/README.md) describes each set. The bearing's 140 mm OD,
the braid's spec and the inner-race decision all come from these photos.

Also a worked example of photographing black PLA: raking light from a grazing angle raised
measured contrast 26 times over the phone's coaxial torch.
