mattjoyce/xyz-arm/knowledge/references/index.md

# Analysis

* [2020 V-slot section properties](section-properties.md) - Area, second moment and mass per metre of the 2020 V-slot, integrated from the OpenBuilds DXF.

# Design Log

* [CAD design log](design-log.md) - cad/README.md: one numbered iteration paragraph per change to the CAD, 60 iterations from first blockout to the washer holder.

# Design Note

* [XYZ Arm Mk1 design note](design-note.md) - design.html: the original design with mass budget, tipping moment, wheel spacing, lighting angles, field of view and deflection.

# Photo Set

* [Bench camera captures](captures.md) - DeskCam stills of the bearing, braid, first prints and the arm's first frame, each with its camera settings sidecar.

# Prior Art

* [Open Task Light](open-task-light.md) - Steven Bennett's MIT-licensed counterbalanced task light on 2020 V-slot, the closest existing design.

# Reference

* [OpenBuilds V-slot 20x20 drawing](openbuilds-vslot-20x20.md) - The manufacturer's drawing and DXF of the 20x20 V-slot profile, source for the rail model and section properties.
* [Solid V wheel kit](solid-v-wheel-kit.md) - Supplier drawing and listing for the Solid V wheels and eccentric spacers used on the gantry plate.
