mattjoyce/xyz-arm/knowledge/references/open-task-light.md

---
type: Prior Art
title: Open Task Light
description: "Steven Bennett's MIT-licensed counterbalanced task light on 2020 V-slot, the closest existing design."
timestamp: "2026-09-12T00:00:00Z"
resource: "https://github.com/stevenbennett/Open-Task-Light"
tags: [prior-art, third-party]
---

<https://github.com/stevenbennett/Open-Task-Light>. Same spine-and-arm choice of two 500 mm
2020 V-slot rails, arrived at independently. Differs in using a GT2 belt, six wheels and a
steel-shot counterweight slab.

Its carriage STL is kept unmodified in
[`references/open-task-light/`](../../references/open-task-light/README.md) under its MIT
licence, and viewed by `cad/studies/carriage-study.scad`. Analysis:
[`datasheets/prior-art-open-task-light.md`](../../datasheets/prior-art-open-task-light.md).
