mattjoyce/xyz-arm/knowledge/references/solid-v-wheel-kit.md

---
type: Reference
title: Solid V wheel kit
description: Supplier drawing and listing for the Solid V wheels and eccentric spacers used on the gantry plate.
timestamp: "2026-09-20T00:00:00Z"
tags: [wheels, third-party]
---

* Wheel: <https://www.makerstore.com.au/product/wheel-solidv-kit/>. Its product
  drawing is not redistributed here.
* Eccentric spacer: <https://www.makerstore.com.au/product/shim-eccentric-8-6/>

The kits actually used are clear wheels with M5 × 25 low-profile screws; some of their
spacers turned out to be eccentrics. Modelled in [V wheel](/parts/vslot-wheel.md) and
[wheel spacers](/parts/wheel-spacer.md).
