mattjoyce/xyz-arm/cad/studies/turntable-bearing.md

Turntable bearing reference model
=================================

Open [../parts/turntable-bearing.scad](../parts/turntable-bearing.scad).

Source: `../../captures/2026-09-12-turntable/with-ruler.jpg` and `bare-wide.jpg`. The former's capture timestamp is 2026-09-12 23:05:49, matching the requested old folder `deskcam-script-20260912-230548`. The files have since been organised under `captures/`.

The 140 mm outside diameter is confirmed by hand in the capture notes; the user confirmed 8.5 mm thickness. Approximate proportions relative to that diameter suggest an 87 mm bore, 114 mm race boundary, and 128/102 mm outer/inner mounting pitch circles. These are visual estimates, not calibrated measurements. Four holes per ring are visible; the outer holes have countersinks. Nominal 5 mm holes and 10 mm countersinks are placeholders inferred from their proportions. The inner ring's relative angle is adjustable.

Overall thickness is **8.5 mm, confirmed by the user**. The 0.6 mm race gap and 2.5 mm countersink depth are also provisional. Hidden raceways, balls, retainers, underside details and machining texture are not reproduced. This is a reference envelope for base design, not a bearing manufacturing model or drilling template. It is not yet inserted into the arm assembly.
