mattjoyce/xyz-arm/cad/previews/arm-end-cap-under.png

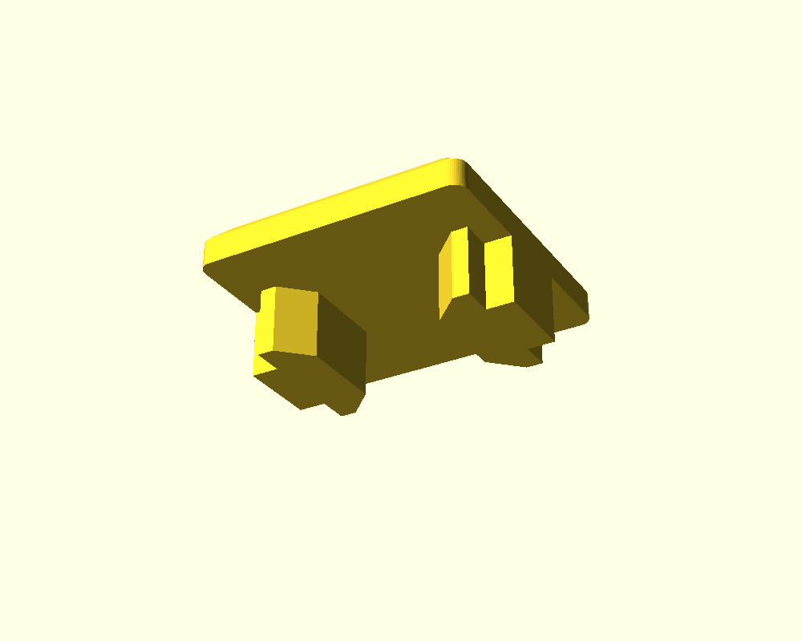
cad/previews/arm-end-cap-under.png
