mattjoyce/xyz-arm/cad/previews/arm-end-cap.png

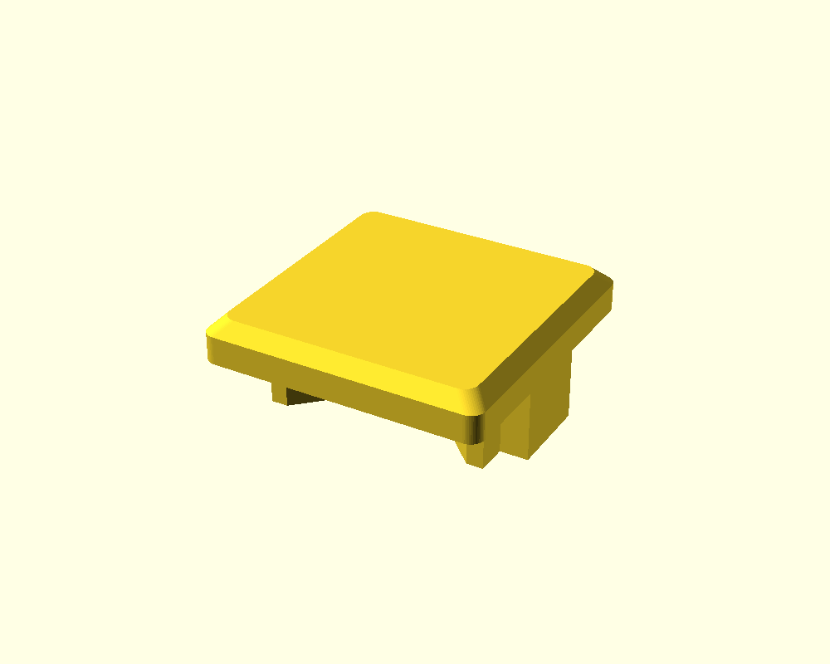
cad/previews/arm-end-cap.png
