mattjoyce/xyz-arm/cad/previews/arm-strip-collar-context.png

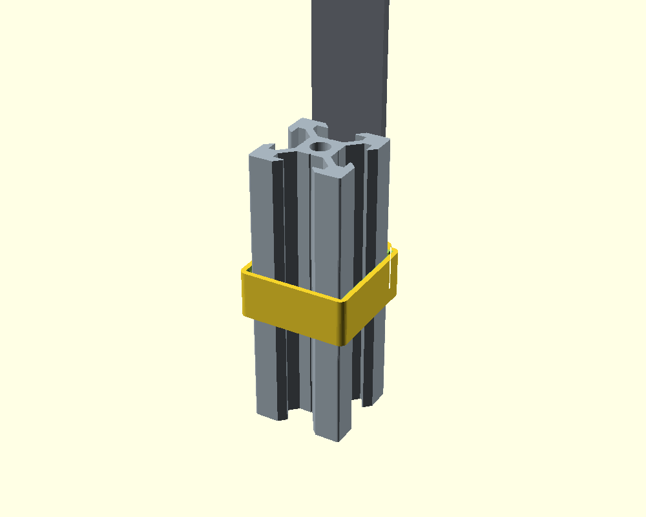
cad/previews/arm-strip-collar-context.png
