mattjoyce/xyz-arm/cad/previews/arm-strip-collar-plan.png

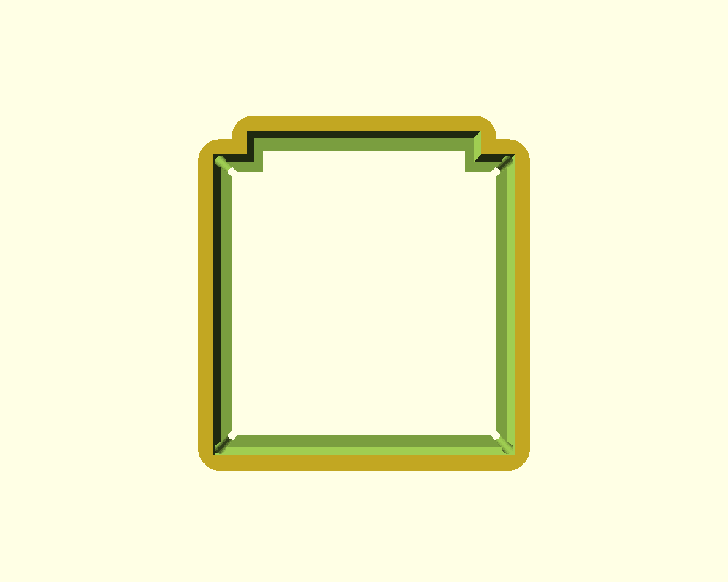
cad/previews/arm-strip-collar-plan.png
