mattjoyce/xyz-arm/cad/previews/arm-strip-collar.png

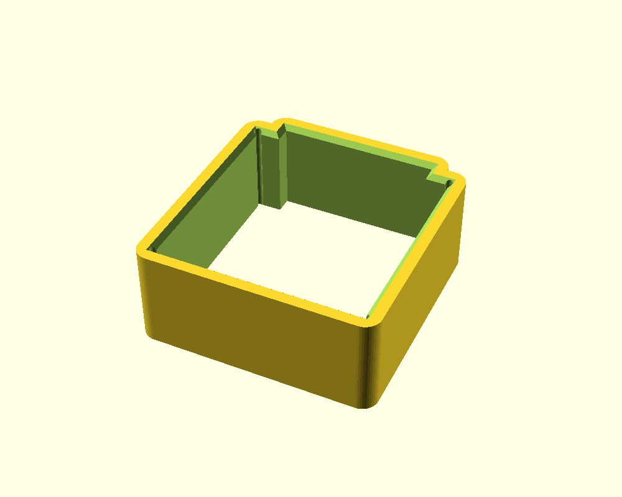
cad/previews/arm-strip-collar.png
