mattjoyce/xyz-arm/cad/previews/base-detail.png

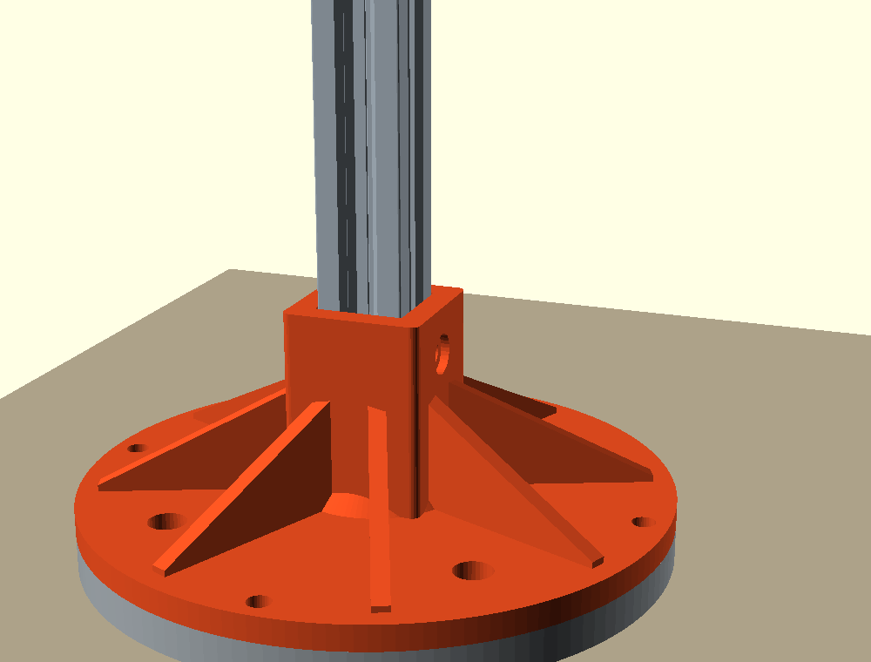
cad/previews/base-detail.png
