mattjoyce/xyz-arm/cad/previews/camera-mount-bolt.png

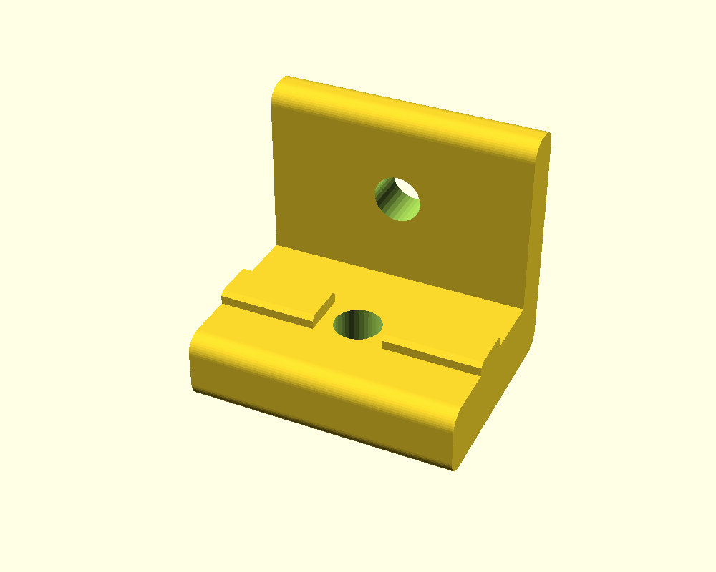
cad/previews/camera-mount-bolt.png
