mattjoyce/xyz-arm/cad/previews/camera-mount.png

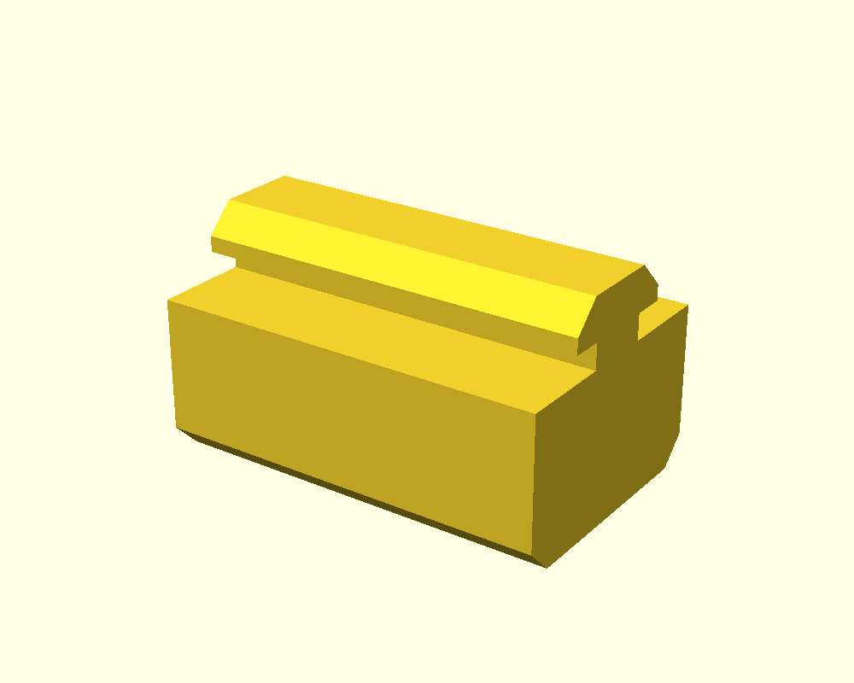
cad/previews/camera-mount.png
