mattjoyce/xyz-arm/cad/previews/carriage-study.png

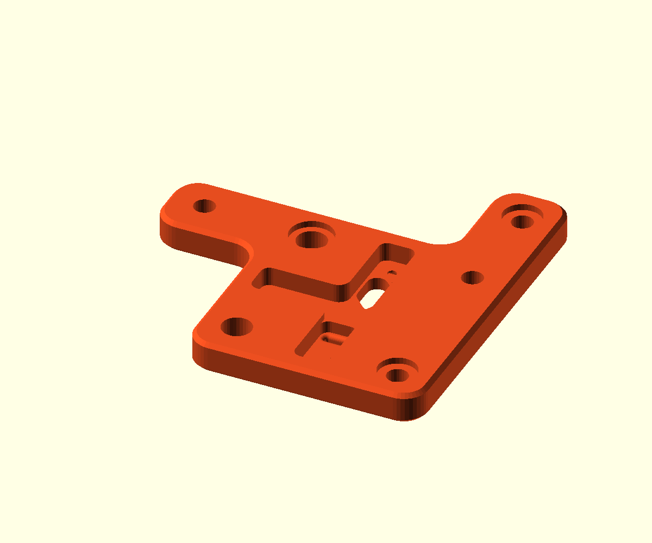
cad/previews/carriage-study.png
