mattjoyce/xyz-arm/cad/previews/compact-carriage-context.png

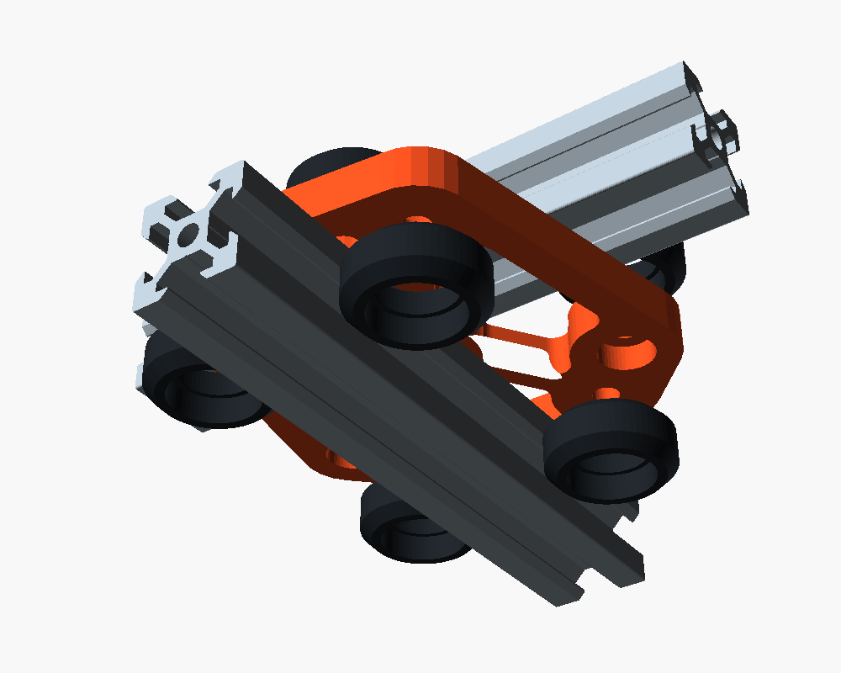
cad/previews/compact-carriage-context.png
