mattjoyce/xyz-arm/cad/previews/compact-carriage-spine.png

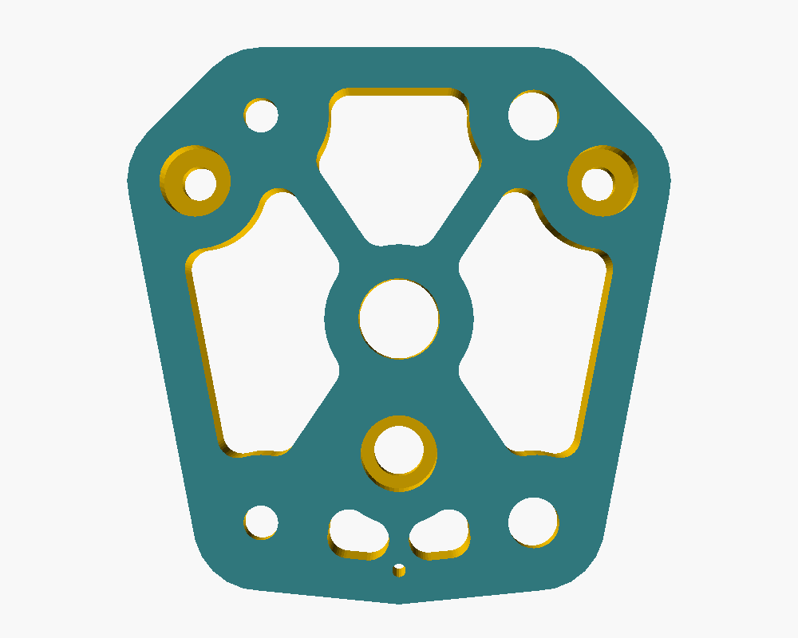
cad/previews/compact-carriage-spine.png
