mattjoyce/xyz-arm/cad/previews/compact-carriage.png

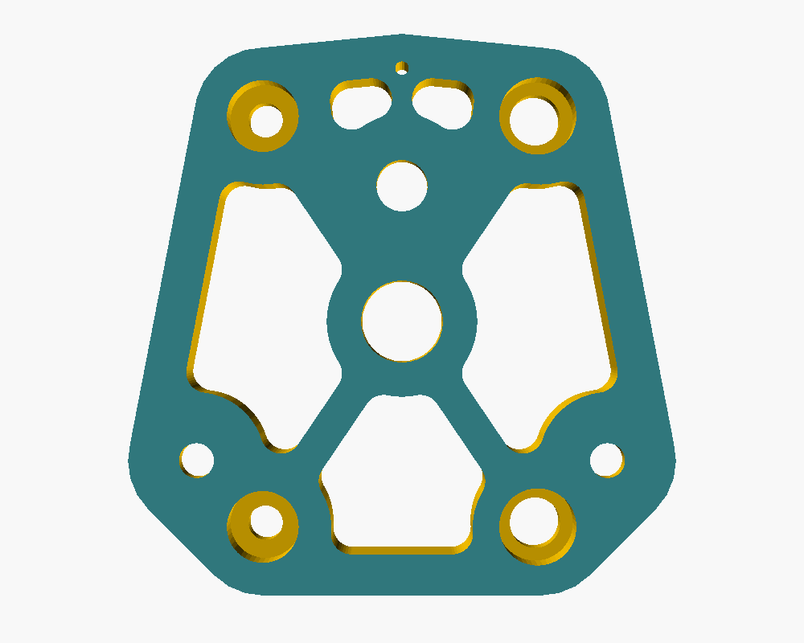
cad/previews/compact-carriage.png
