mattjoyce/xyz-arm/cad/previews/fit-bearing.png

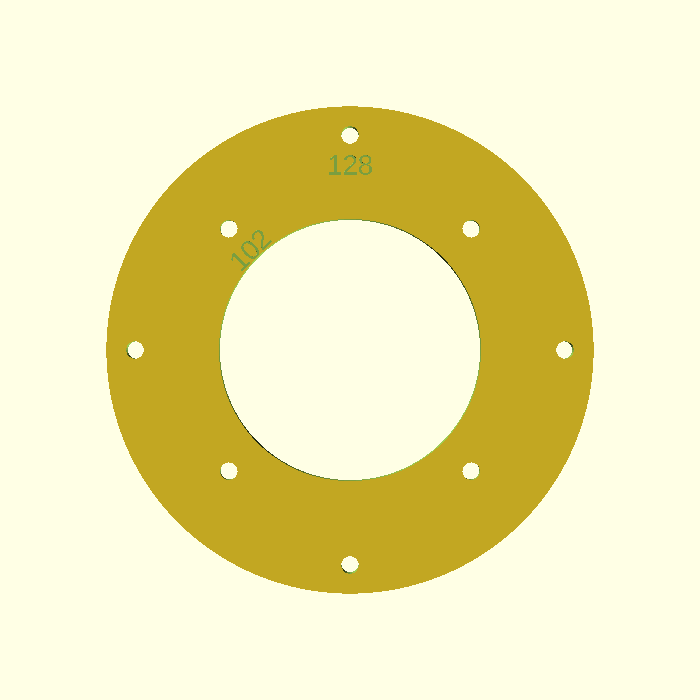
cad/previews/fit-bearing.png
