mattjoyce/xyz-arm/cad/previews/fit-gauge.png

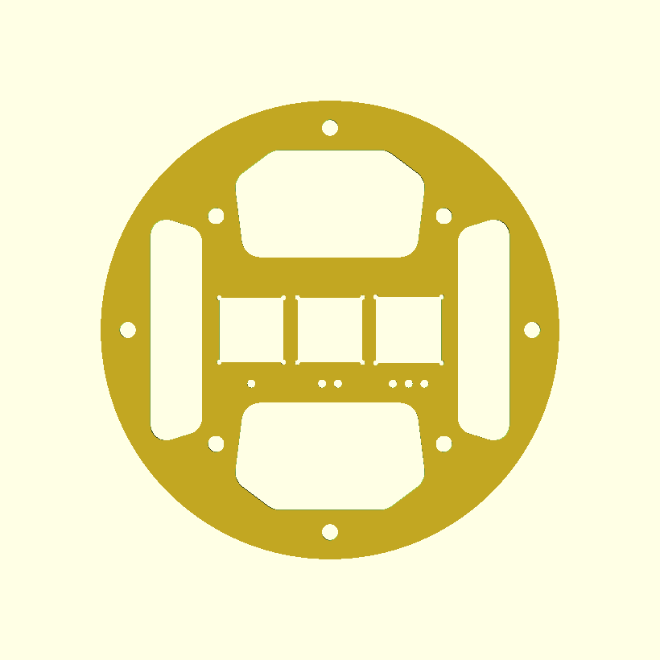
cad/previews/fit-gauge.png
