mattjoyce/xyz-arm/cad/previews/fit-socket.png

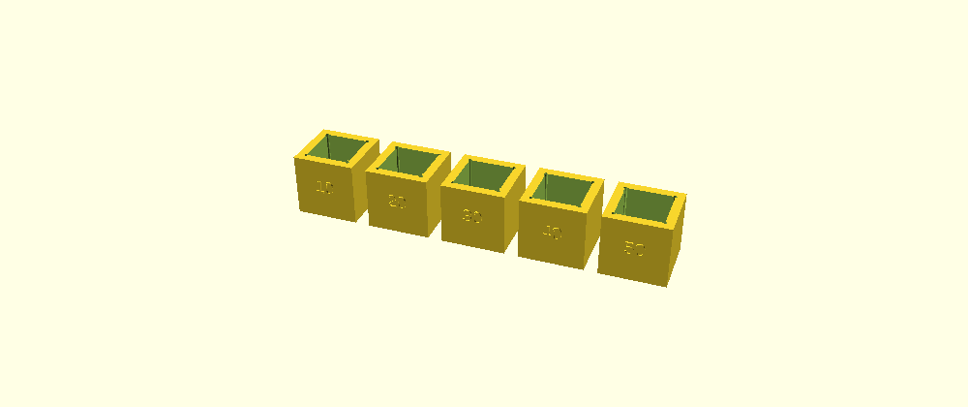
cad/previews/fit-socket.png
