mattjoyce/xyz-arm/cad/previews/gantry-carriage-back.png

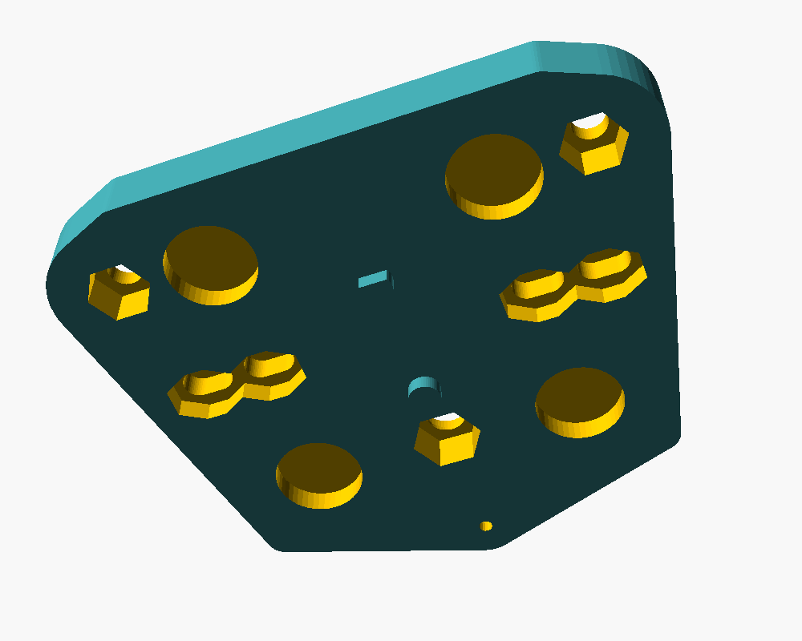
cad/previews/gantry-carriage-back.png
