mattjoyce/xyz-arm/cad/previews/gantry-carriage-context.png

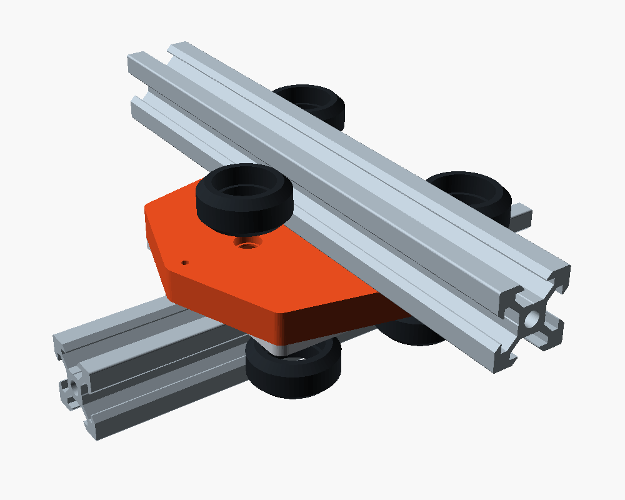
cad/previews/gantry-carriage-context.png
