mattjoyce/xyz-arm/cad/previews/gantry-carriage.png

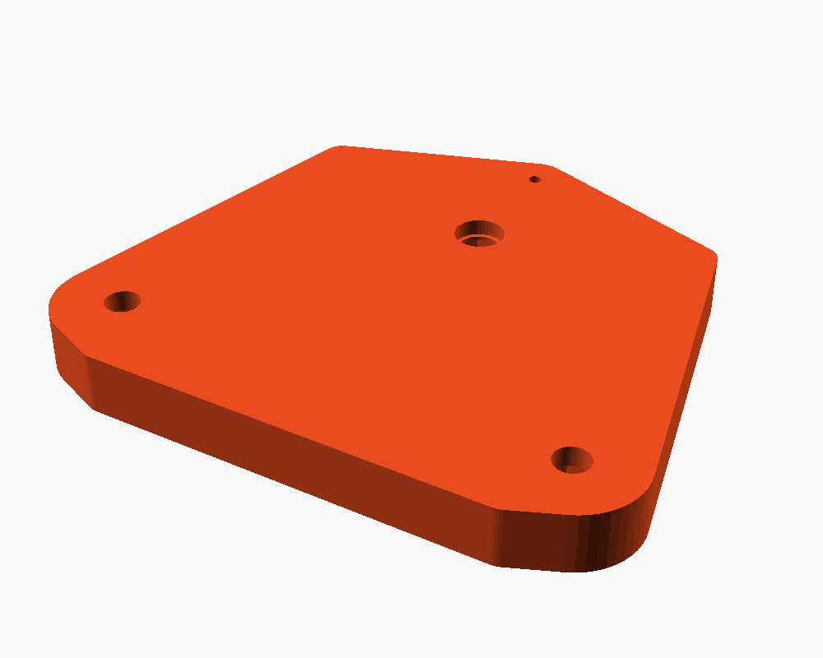
cad/previews/gantry-carriage.png
