mattjoyce/xyz-arm/cad/previews/load-stack-master-plan.png

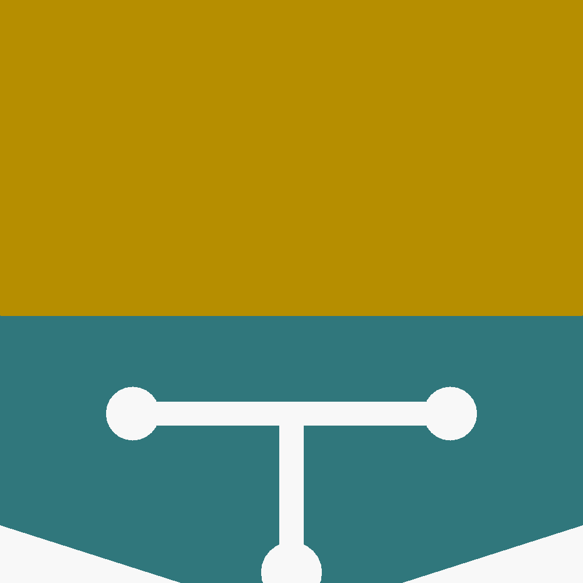
cad/previews/load-stack-master-plan.png
