mattjoyce/xyz-arm/cad/previews/load-stack-master-pocket.png

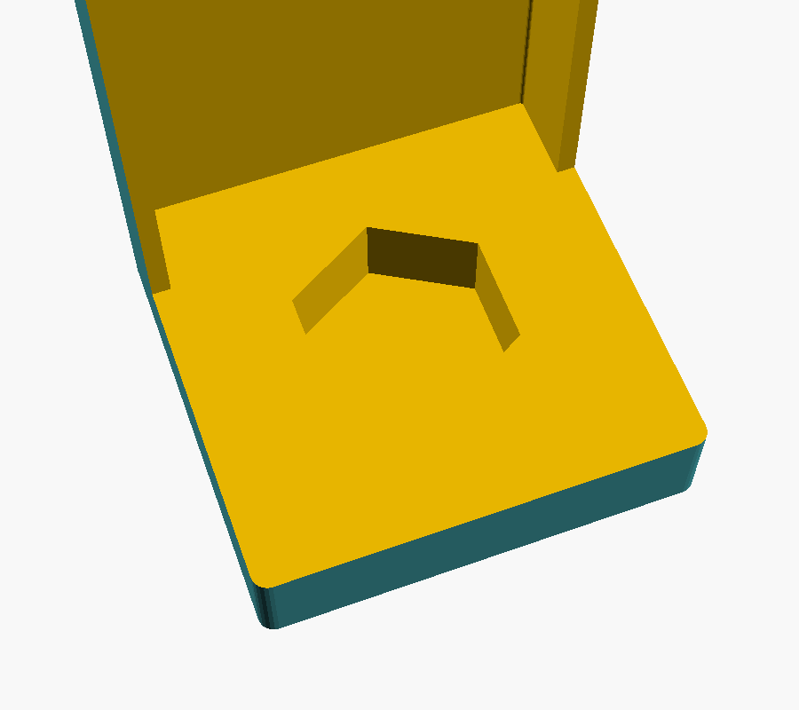
cad/previews/load-stack-master-pocket.png
