mattjoyce/xyz-arm/cad/previews/load-stack-master-two.png

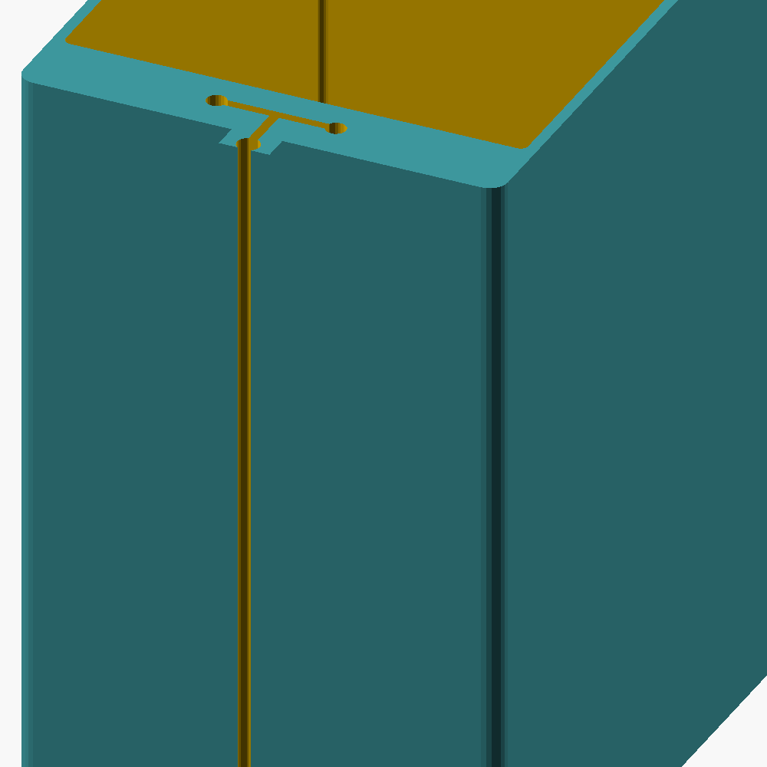
cad/previews/load-stack-master-two.png
