mattjoyce/xyz-arm/cad/previews/load-stack-master.png

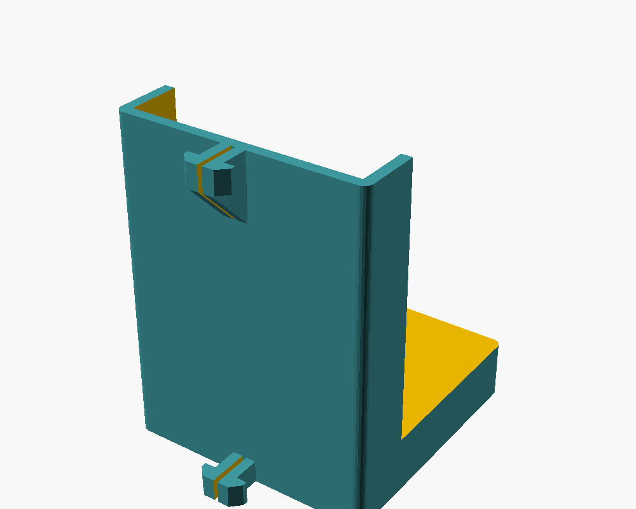
cad/previews/load-stack-master.png
