mattjoyce/xyz-arm/cad/previews/load-stack-plan-front.png

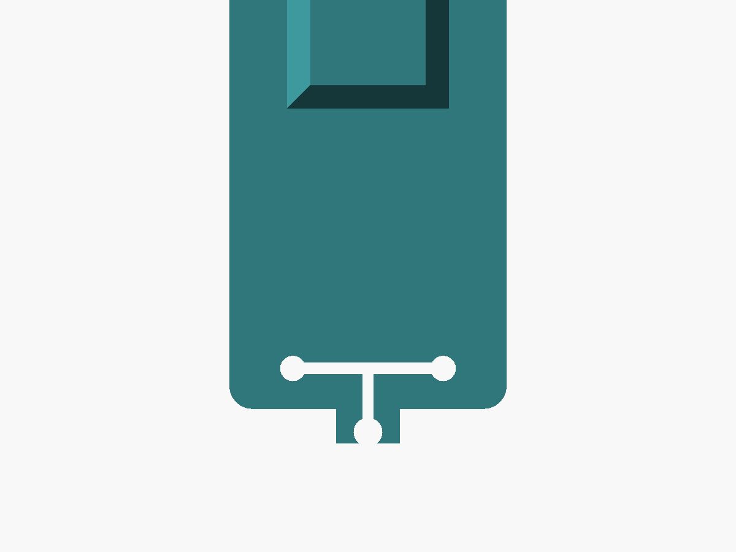
cad/previews/load-stack-plan-front.png
