mattjoyce/xyz-arm/cad/previews/load-stack-slide.png

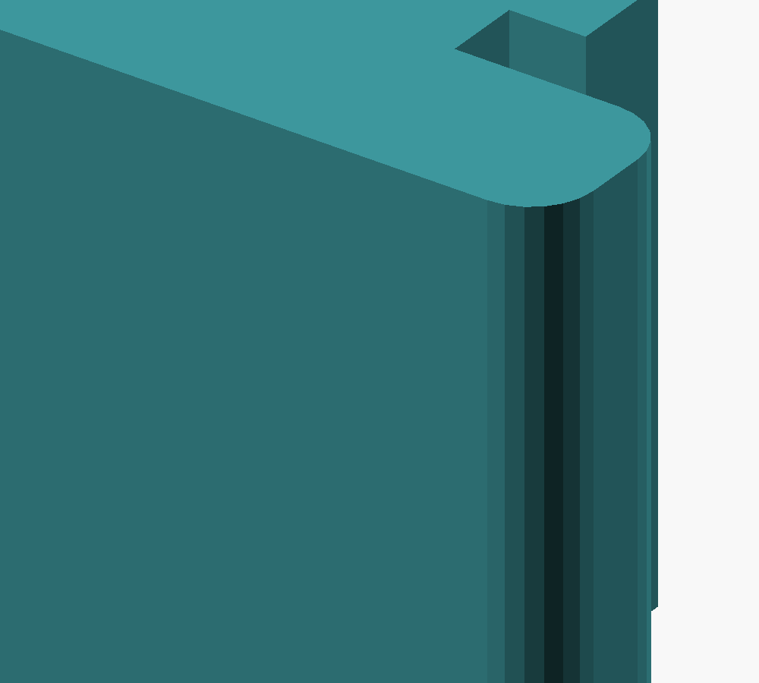
cad/previews/load-stack-slide.png
