mattjoyce/xyz-arm/cad/previews/load-stack-slider-taper.png

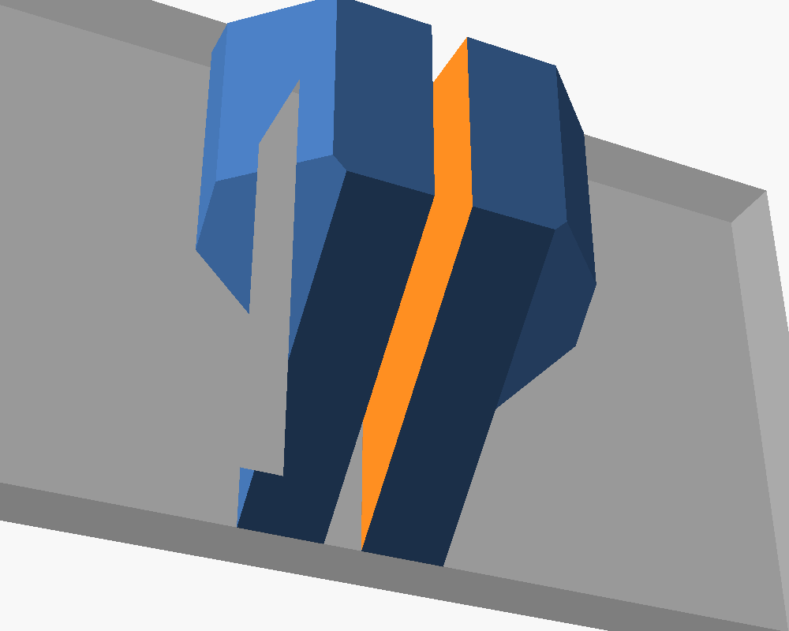
cad/previews/load-stack-slider-taper.png
