mattjoyce/xyz-arm/cad/previews/load-stack-stack.png

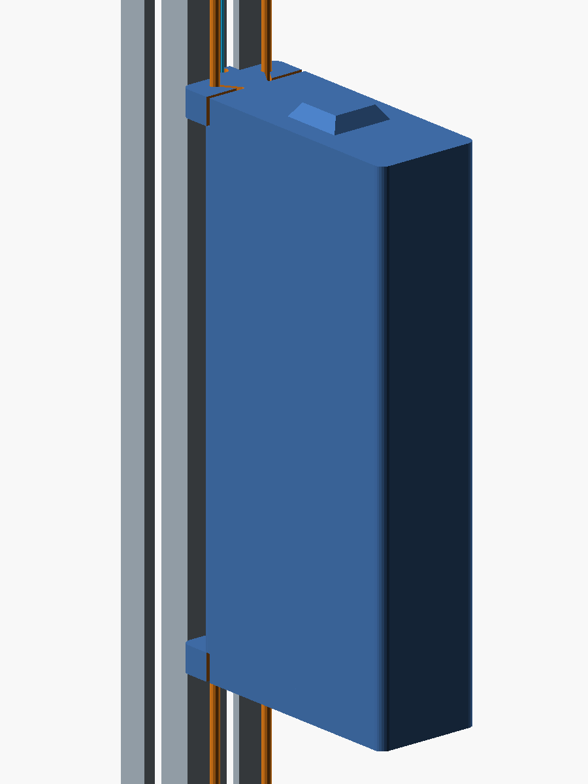
cad/previews/load-stack-stack.png
