mattjoyce/xyz-arm/cad/previews/load-stack-under.png

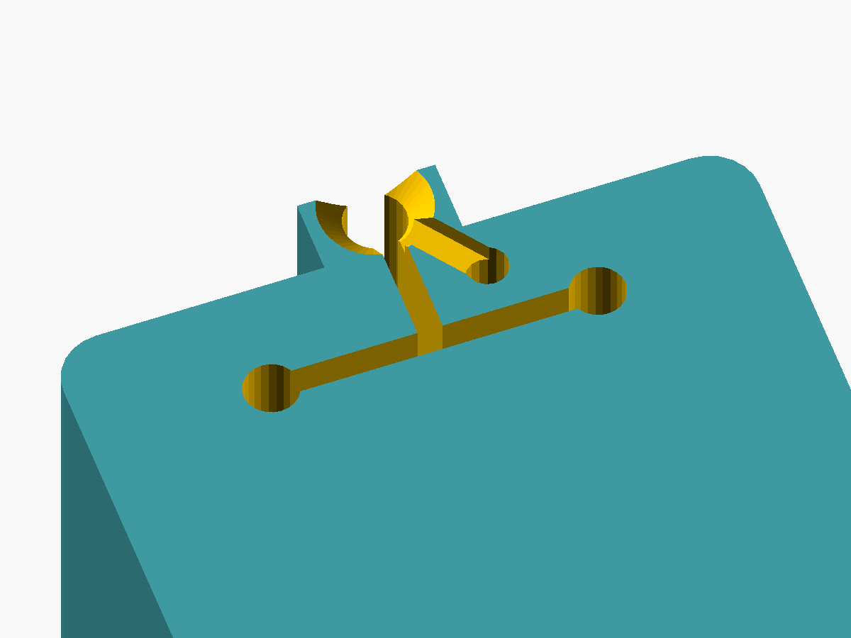
cad/previews/load-stack-under.png
