mattjoyce/xyz-arm/cad/previews/load-stack-washers.png

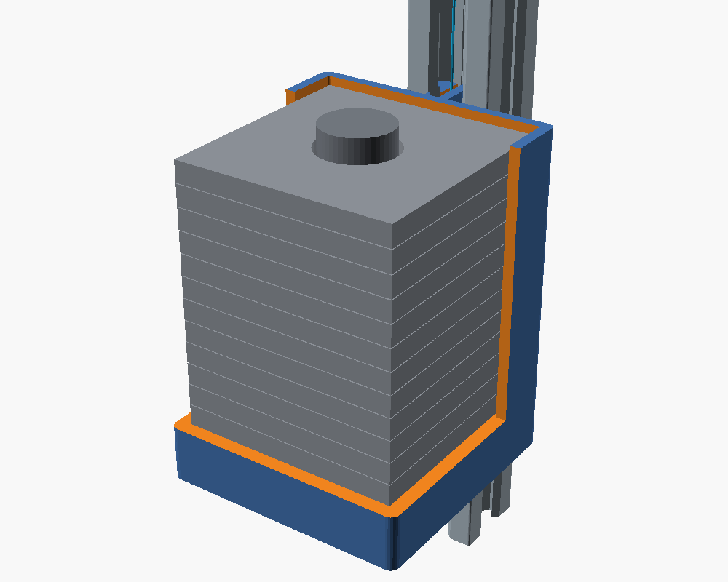
cad/previews/load-stack-washers.png
