mattjoyce/xyz-arm/cad/previews/load-stack.png

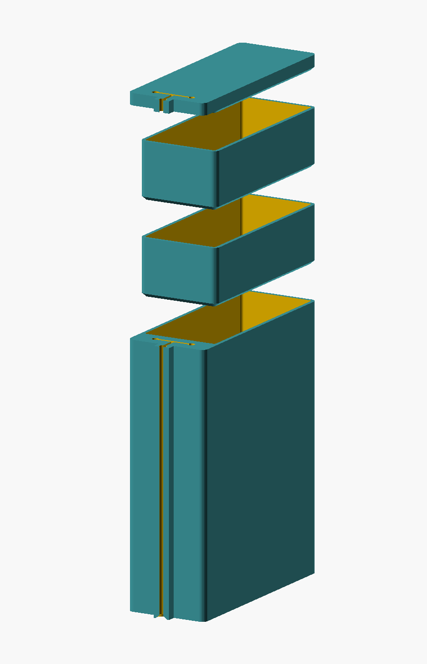
cad/previews/load-stack.png
