mattjoyce/xyz-arm/cad/previews/spine-cap-context.png

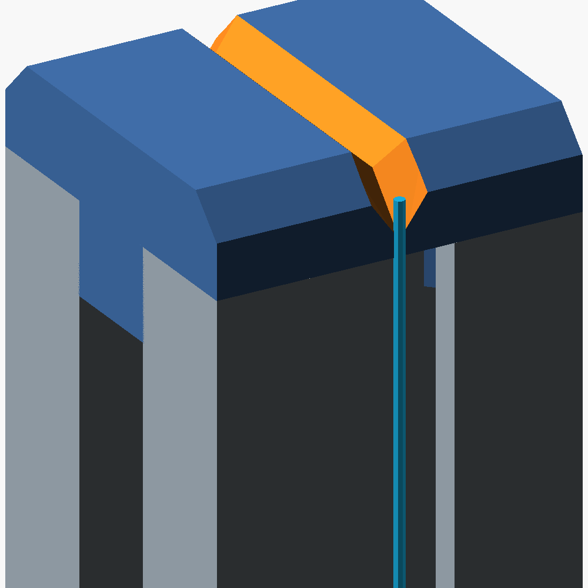
cad/previews/spine-cap-context.png
