mattjoyce/xyz-arm/cad/previews/spine-cap-pulley-under.png

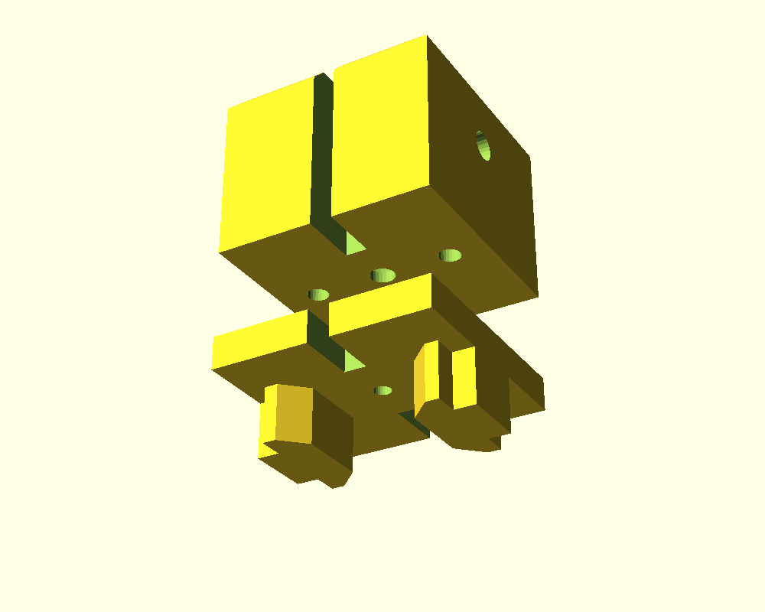
cad/previews/spine-cap-pulley-under.png
