mattjoyce/xyz-arm/cad/previews/spine-cap-pulley.png

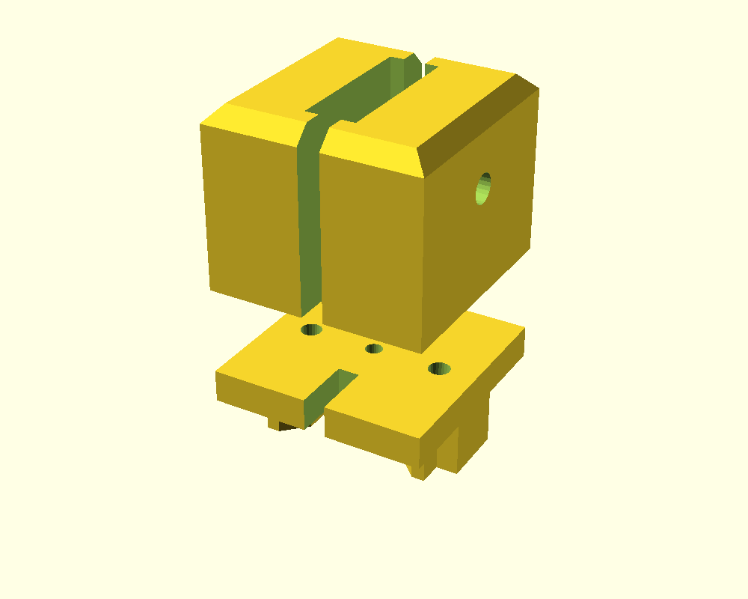
cad/previews/spine-cap-pulley.png
