mattjoyce/xyz-arm/cad/previews/spine-cap-under.png

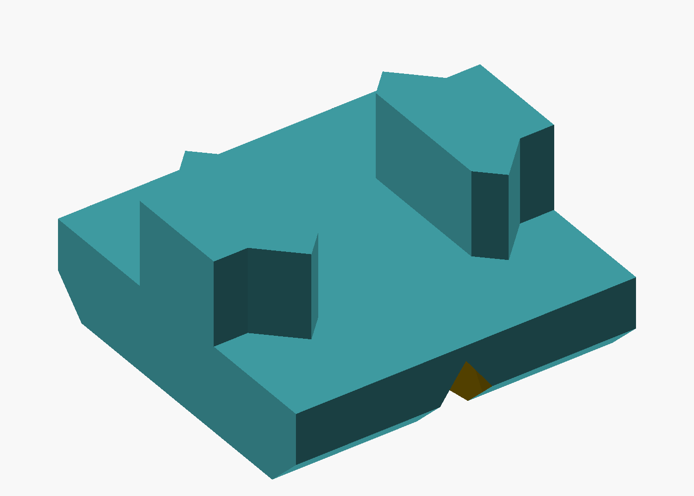
cad/previews/spine-cap-under.png
