mattjoyce/xyz-arm/cad/previews/spine-cap.png

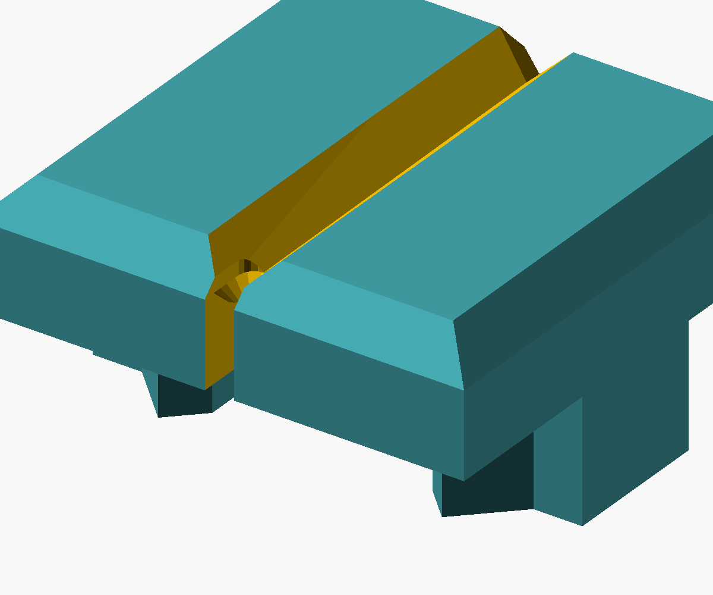
cad/previews/spine-cap.png
