mattjoyce/xyz-arm/cad/previews/v-base-block.png

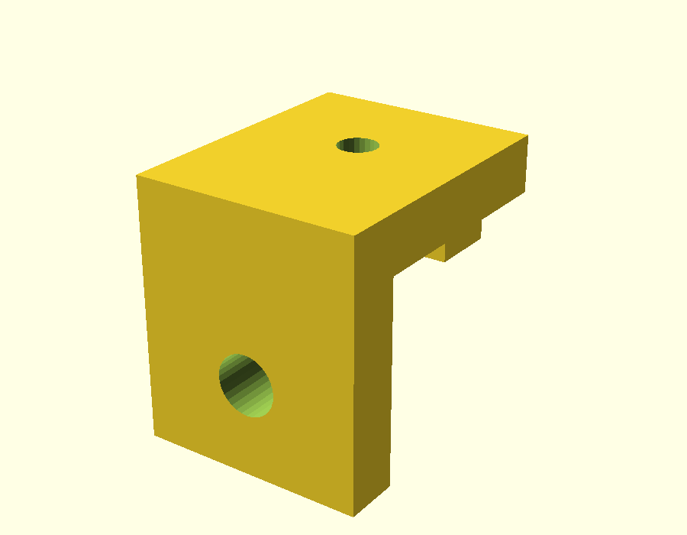
cad/previews/v-base-block.png
