mattjoyce/xyz-arm/cad/previews/v-base-plan.png

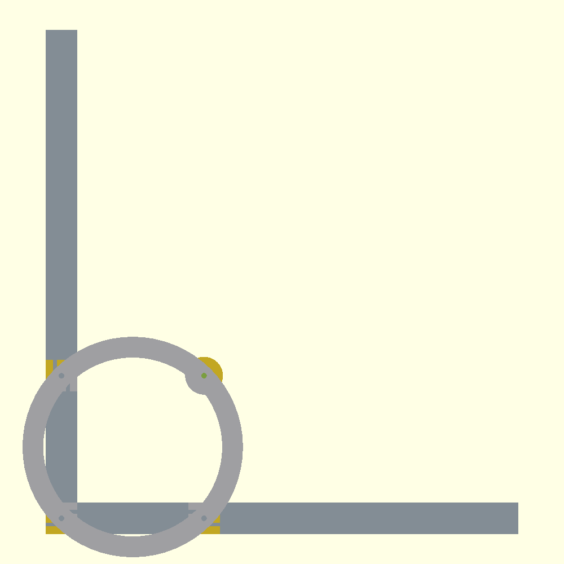
cad/previews/v-base-plan.png
