mattjoyce/xyz-arm/cad/previews/v-base.png

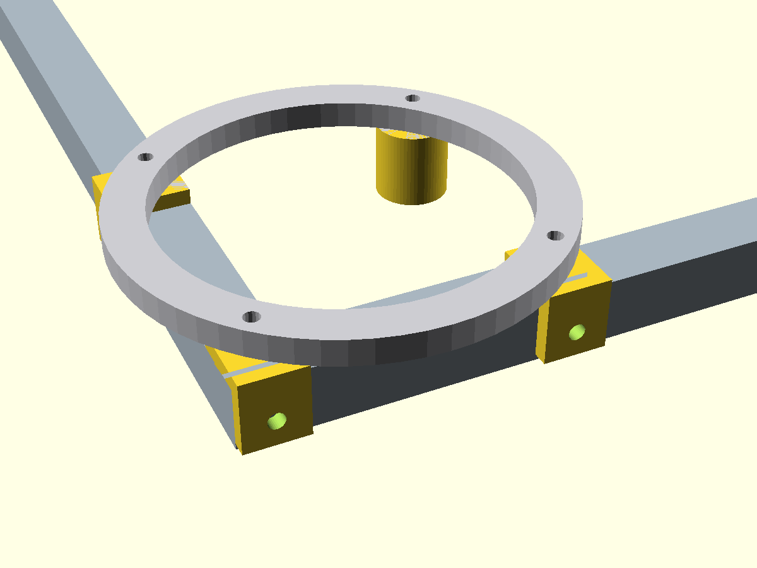
cad/previews/v-base.png
