mattjoyce/xyz-arm/cad/previews/vslot-2020-section.png

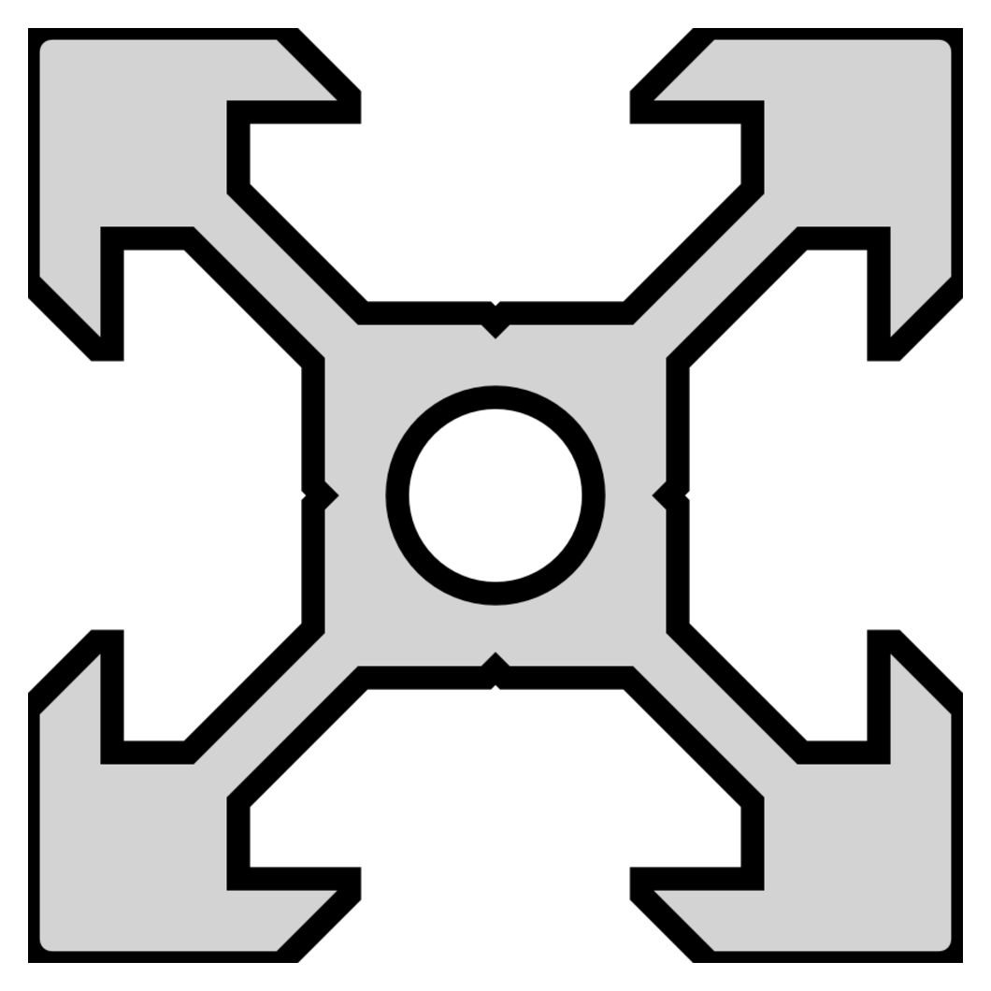
cad/previews/vslot-2020-section.png
