mattjoyce/xyz-arm/cad/previews/washer-holder-context.png

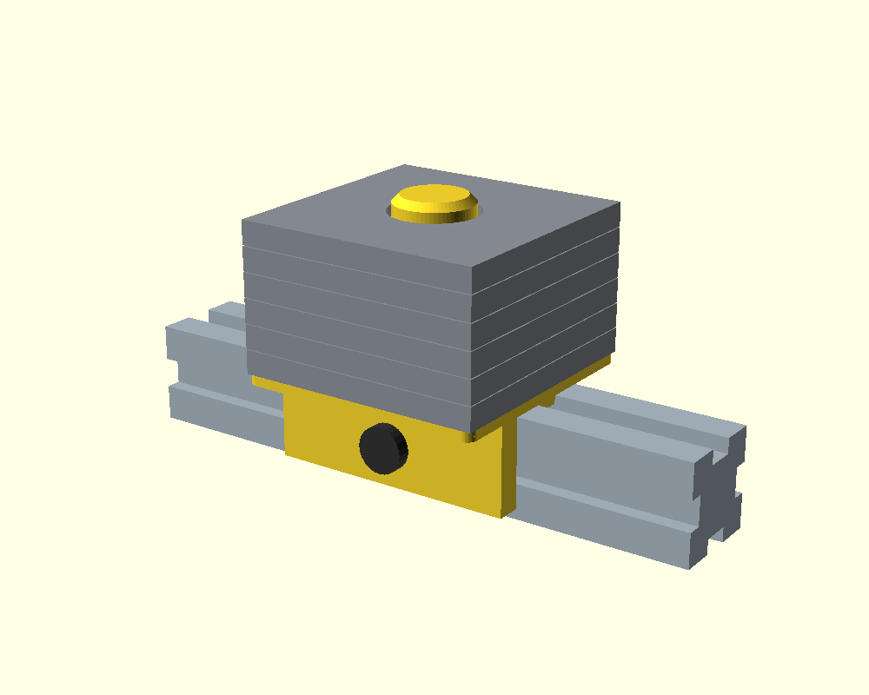
cad/previews/washer-holder-context.png
