mattjoyce/xyz-arm/cad/previews/washer-holder-under.png

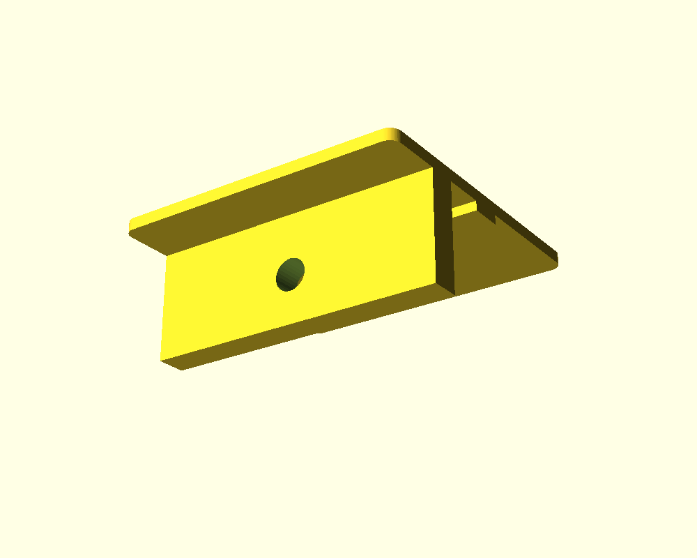
cad/previews/washer-holder-under.png
