mattjoyce/xyz-arm/cad/previews/washer-holder.png

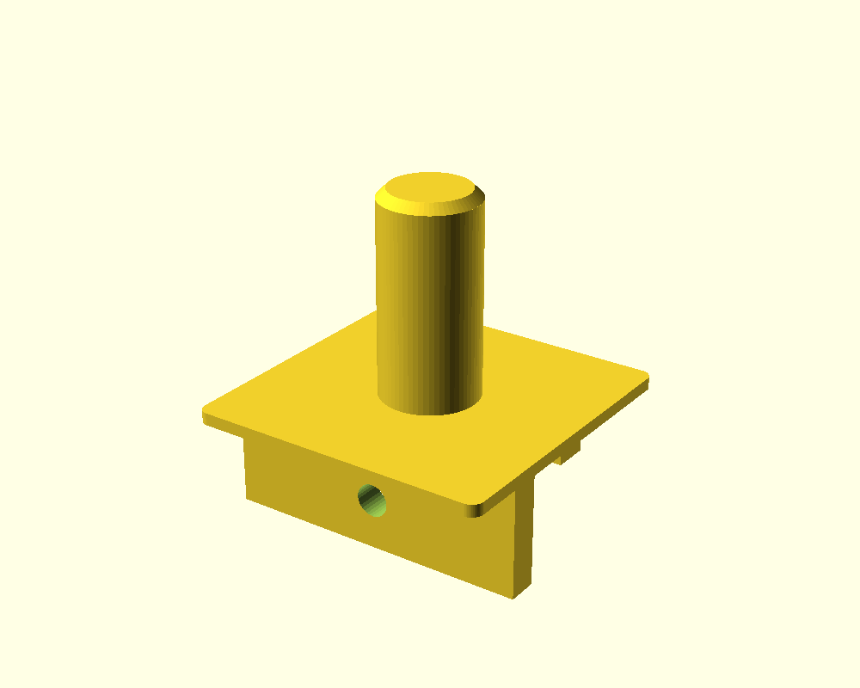
cad/previews/washer-holder.png
