mattjoyce/xyz-arm/cad/previews/weight-base-over.png

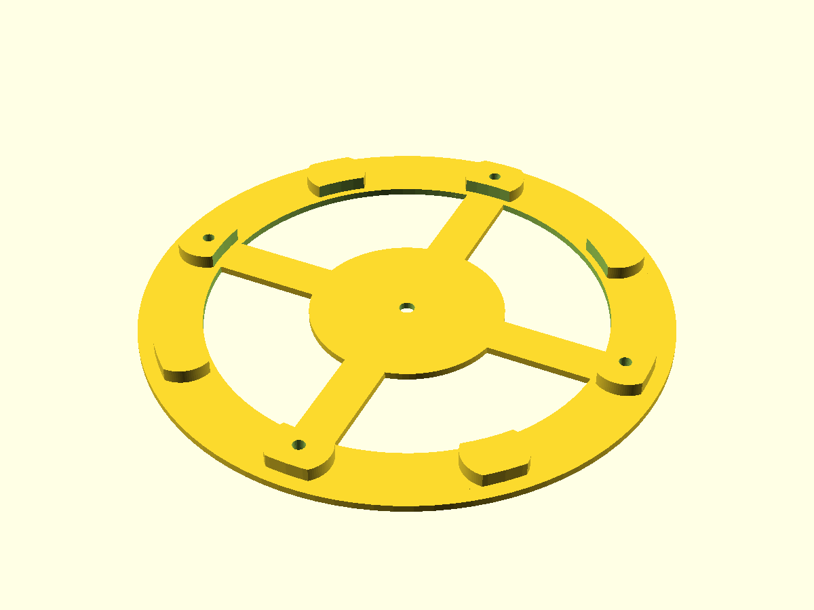
cad/previews/weight-base-over.png
