mattjoyce/xyz-arm/cad/previews/weight-base-under.png

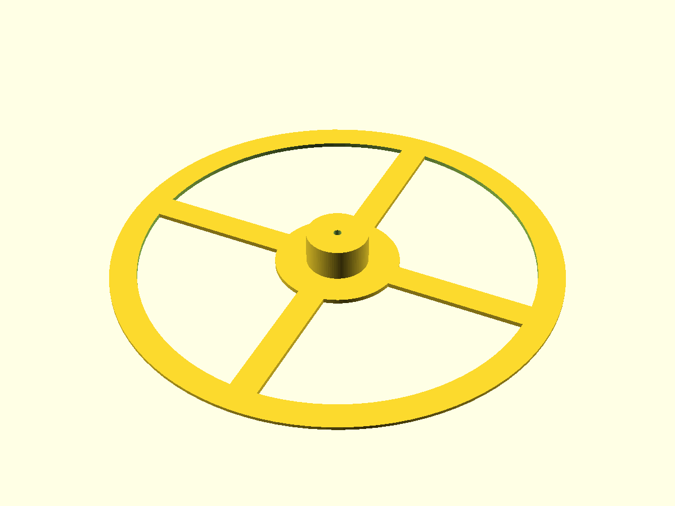
cad/previews/weight-base-under.png
