mattjoyce/xyz-arm/cad/previews/weight-base.png

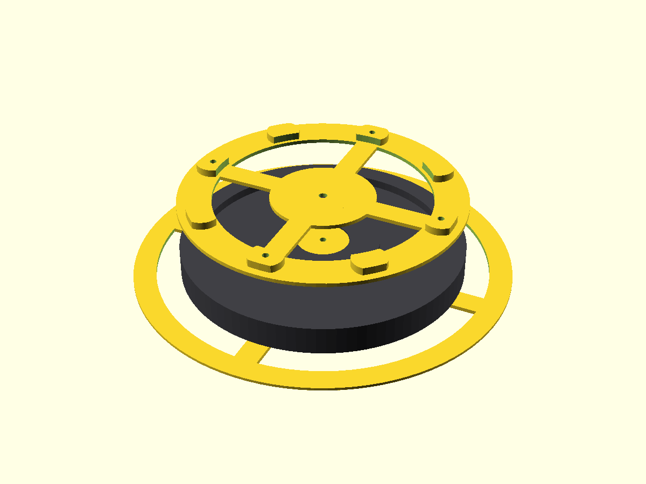
cad/previews/weight-base.png
