mattjoyce/xyz-arm/cad/previews/z-base-context.png

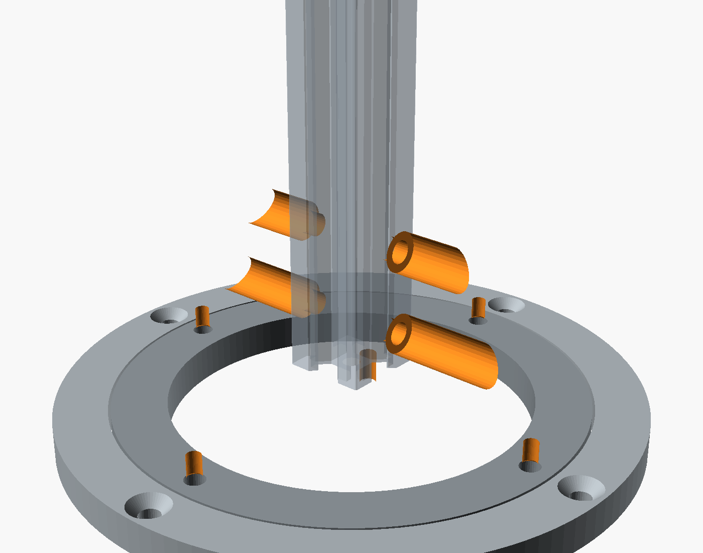
cad/previews/z-base-context.png
