mattjoyce/xyz-arm/cad/previews/z-base-fast-context.png

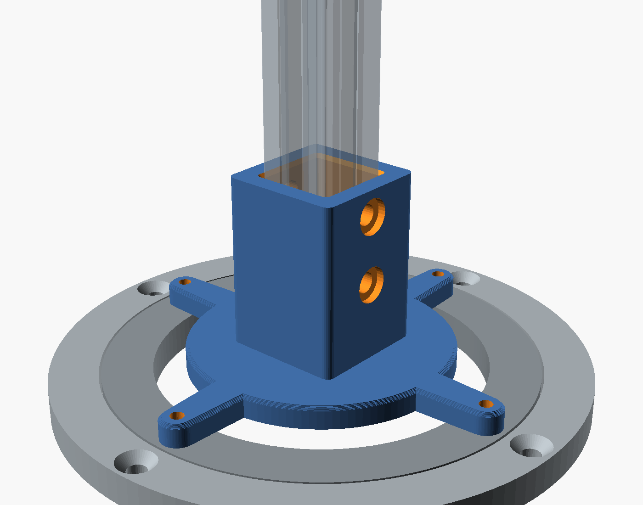
cad/previews/z-base-fast-context.png
