mattjoyce/xyz-arm/cad/previews/z-base-fast-window.png

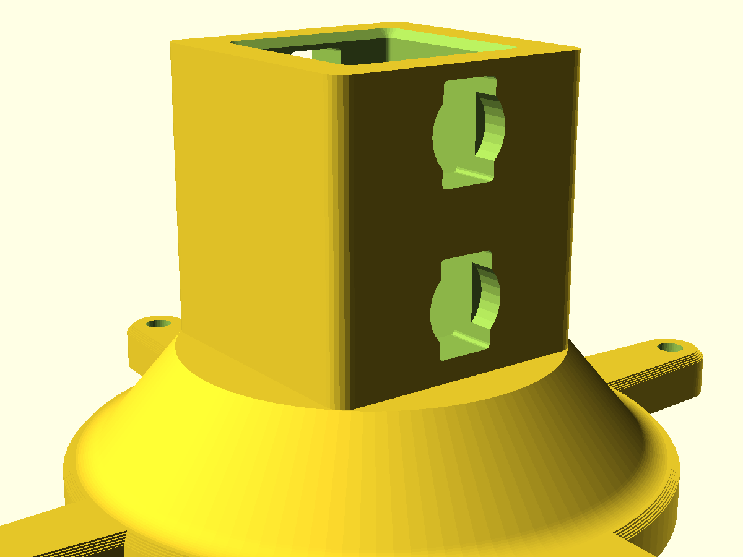
cad/previews/z-base-fast-window.png
