mattjoyce/xyz-arm/cad/previews/z-base-fast.png

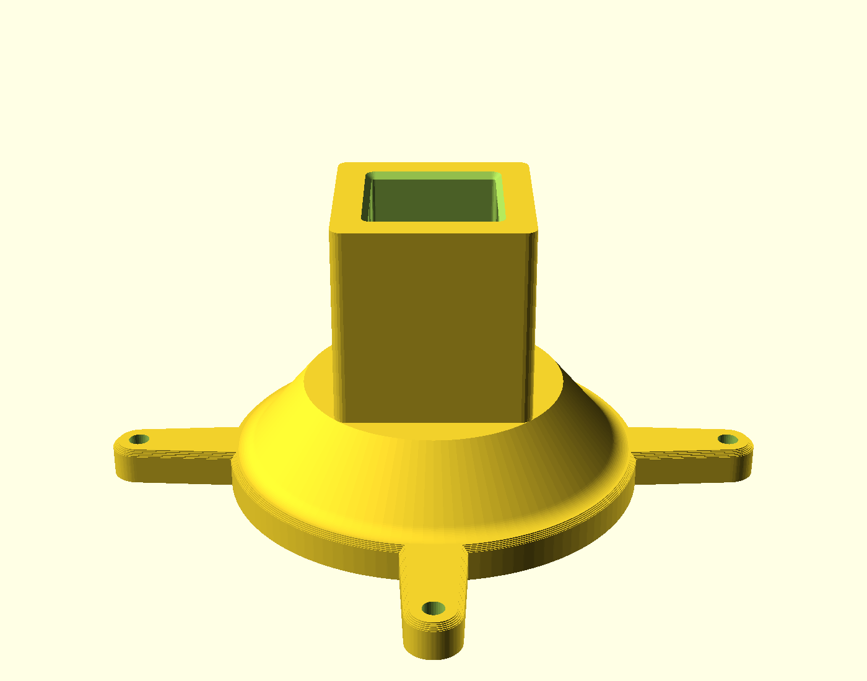
cad/previews/z-base-fast.png
