mattjoyce/xyz-arm/cad/previews/z-base-fins-groove.png

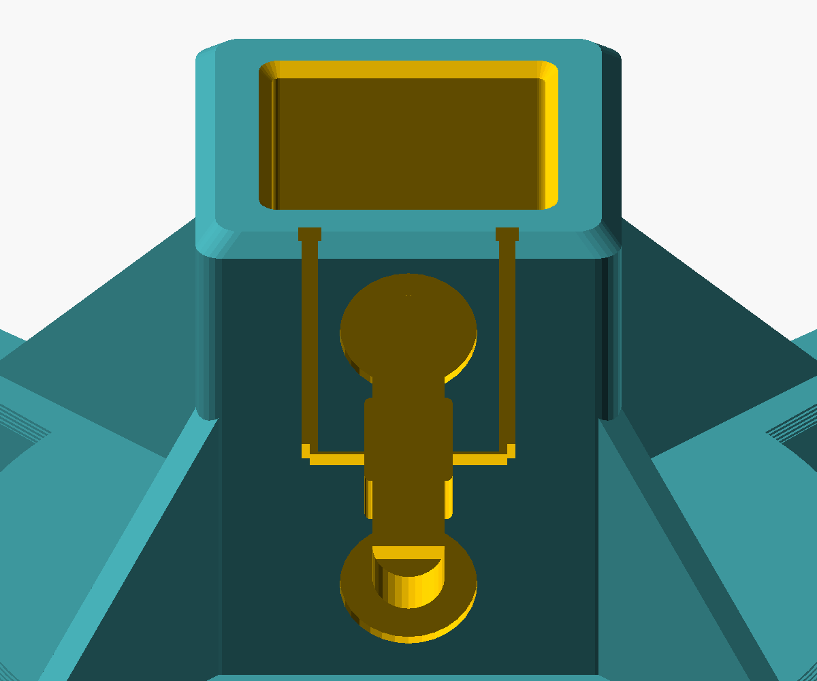
cad/previews/z-base-fins-groove.png
