mattjoyce/xyz-arm/cad/previews/z-base-fins-holes.png

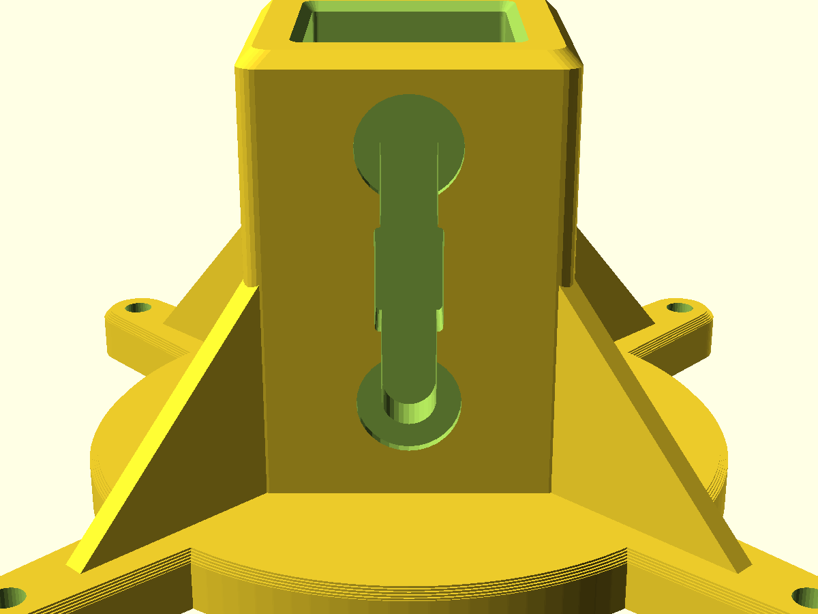
cad/previews/z-base-fins-holes.png
