mattjoyce/xyz-arm/cad/previews/z-base-fins-rear.png

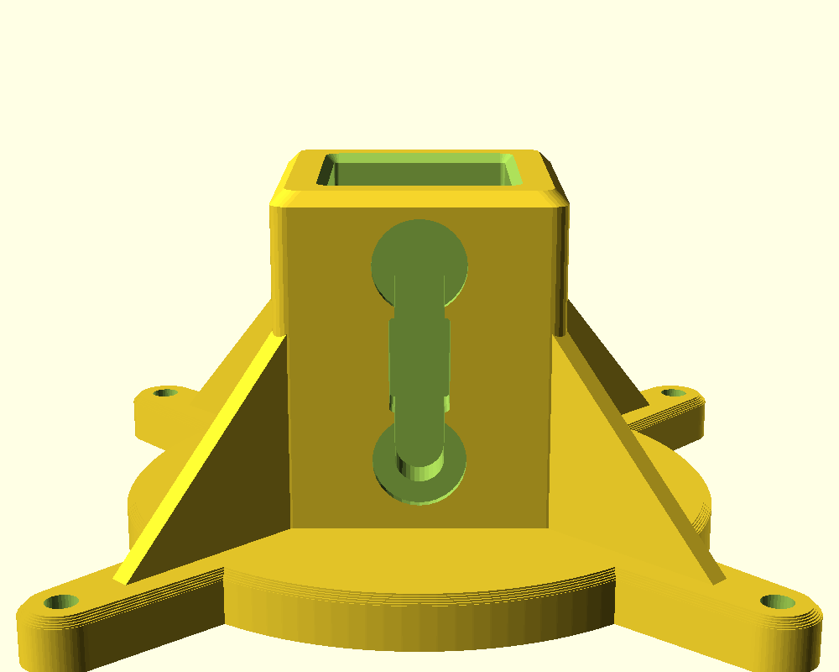
cad/previews/z-base-fins-rear.png
