mattjoyce/xyz-arm/cad/previews/z-base-fins-section.png

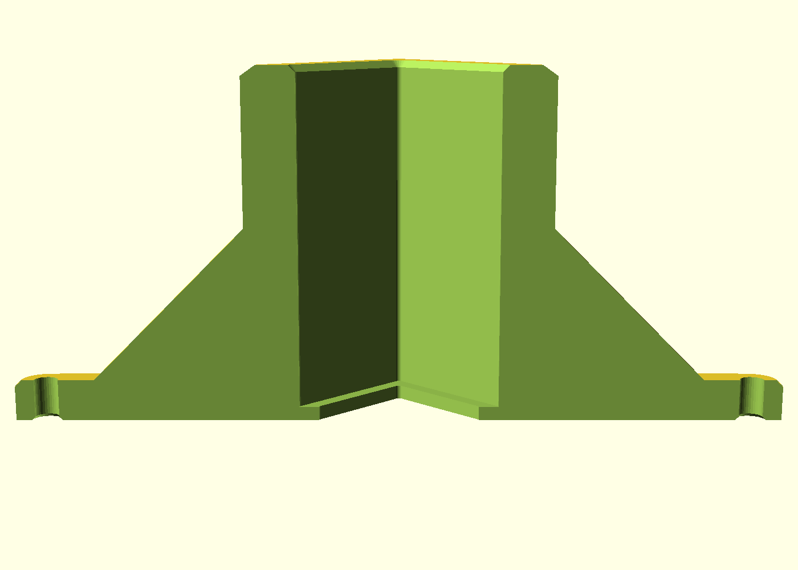
cad/previews/z-base-fins-section.png
