mattjoyce/xyz-arm/cad/previews/z-base-fins-under.png

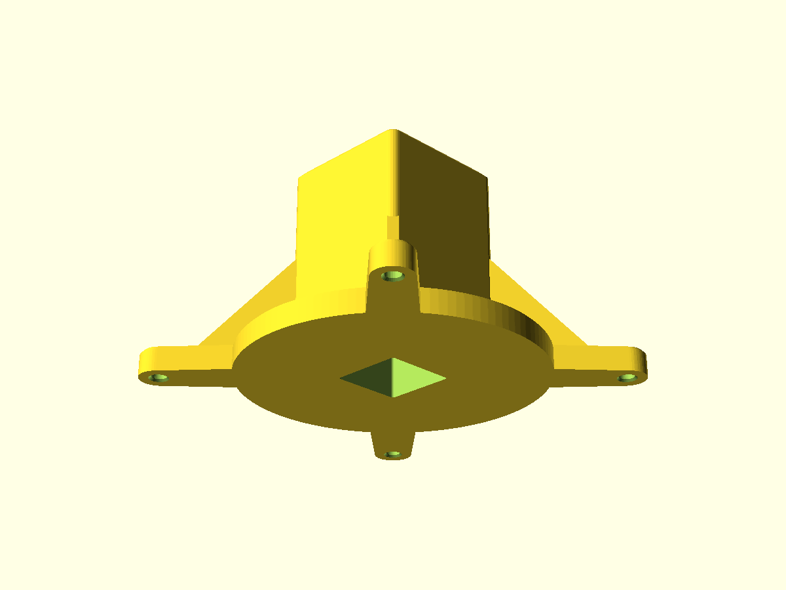
cad/previews/z-base-fins-under.png
