mattjoyce/xyz-arm/cad/previews/z-base-fins.png

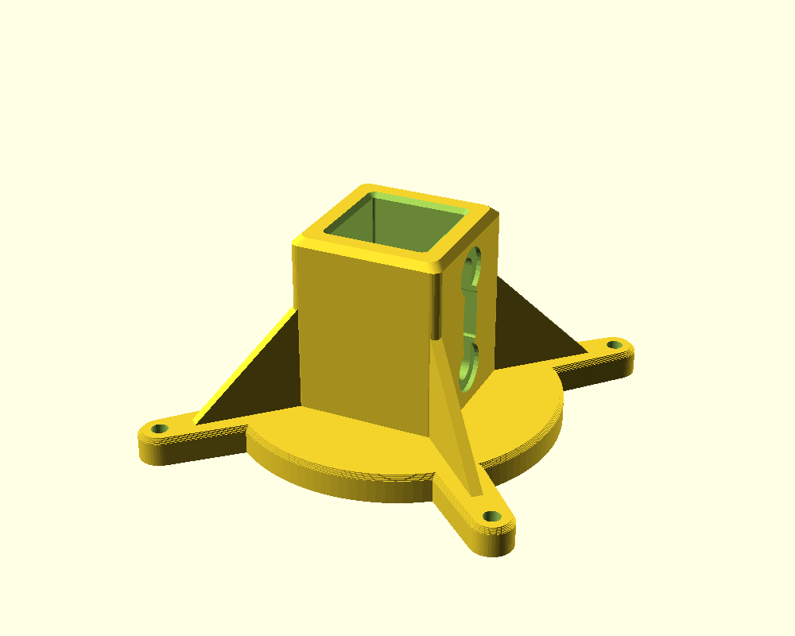
cad/previews/z-base-fins.png
