mattjoyce/xyz-arm/cad/previews/z-base-section.png

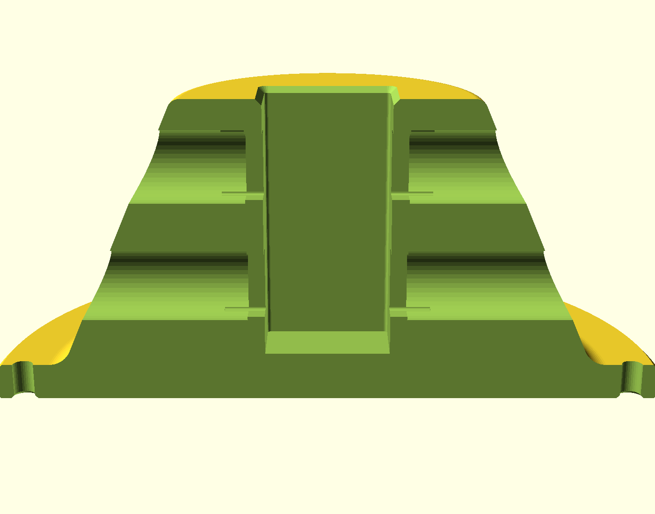
cad/previews/z-base-section.png
