mattjoyce/xyz-arm/cad/previews/z-base.png

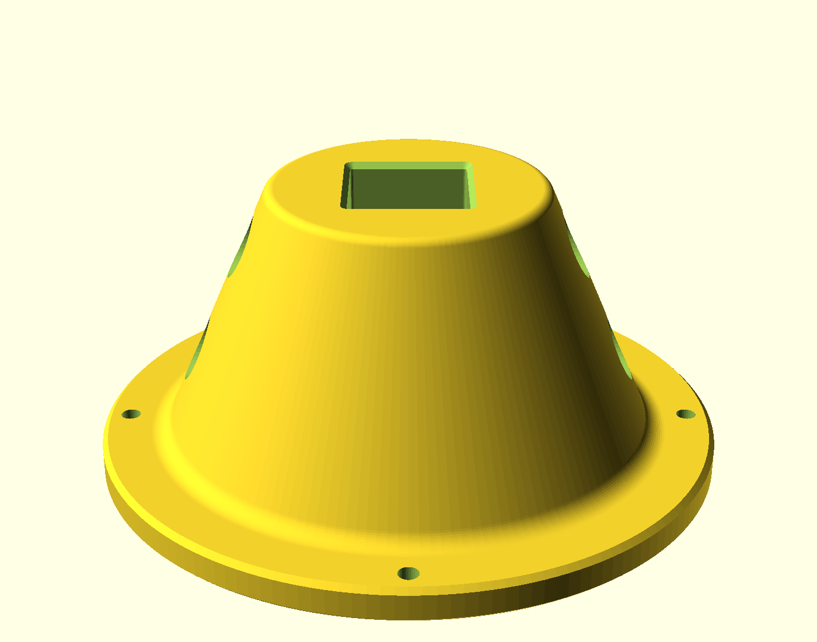
cad/previews/z-base.png
