mattjoyce/xyz-arm/captures/2026-09-12-fishing-line/label-zoom.jpg

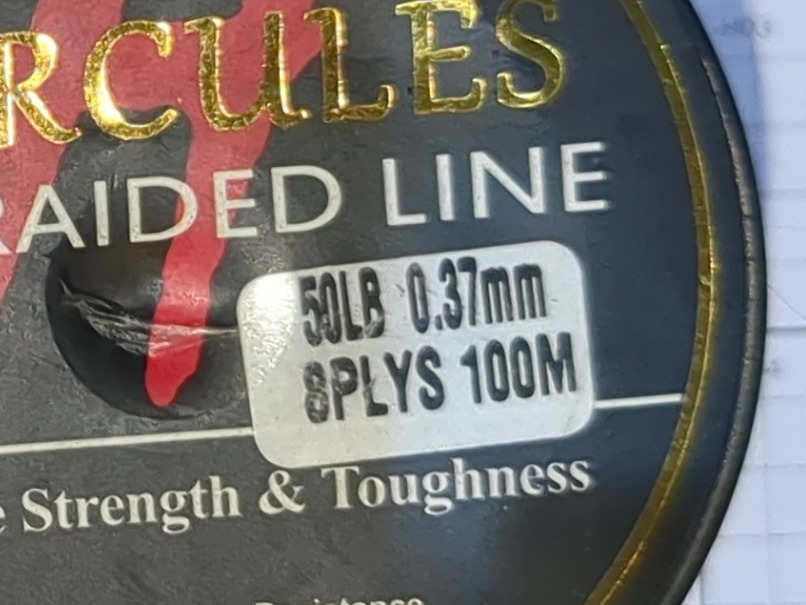
captures/2026-09-12-fishing-line/label-zoom.jpg
