mattjoyce/xyz-arm/captures/2026-09-12-fishing-line/wide.jpg

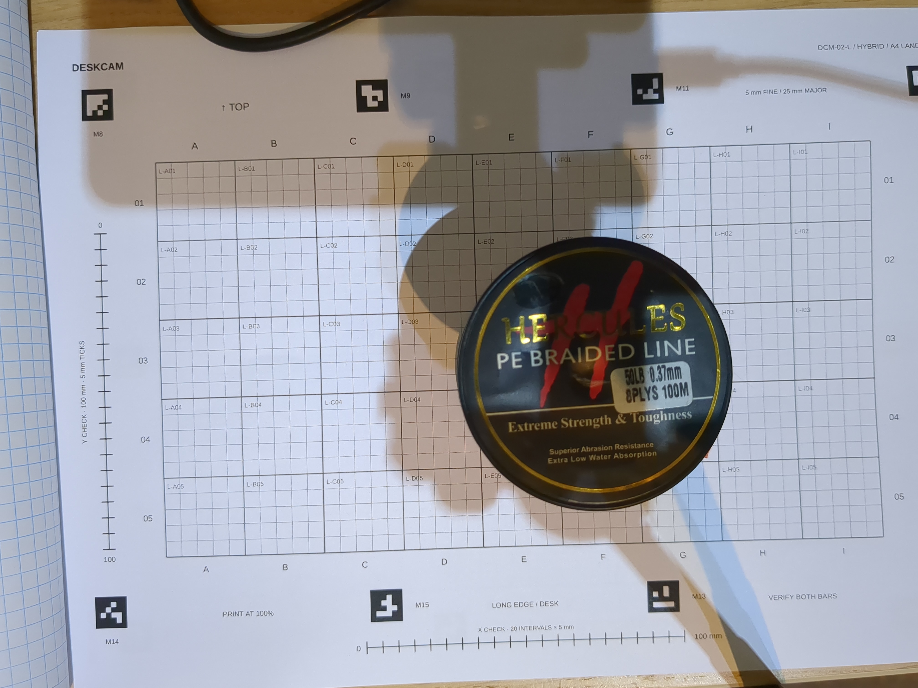
captures/2026-09-12-fishing-line/wide.jpg
