mattjoyce/xyz-arm/captures/2026-09-12-turntable/bare-wide.jpg

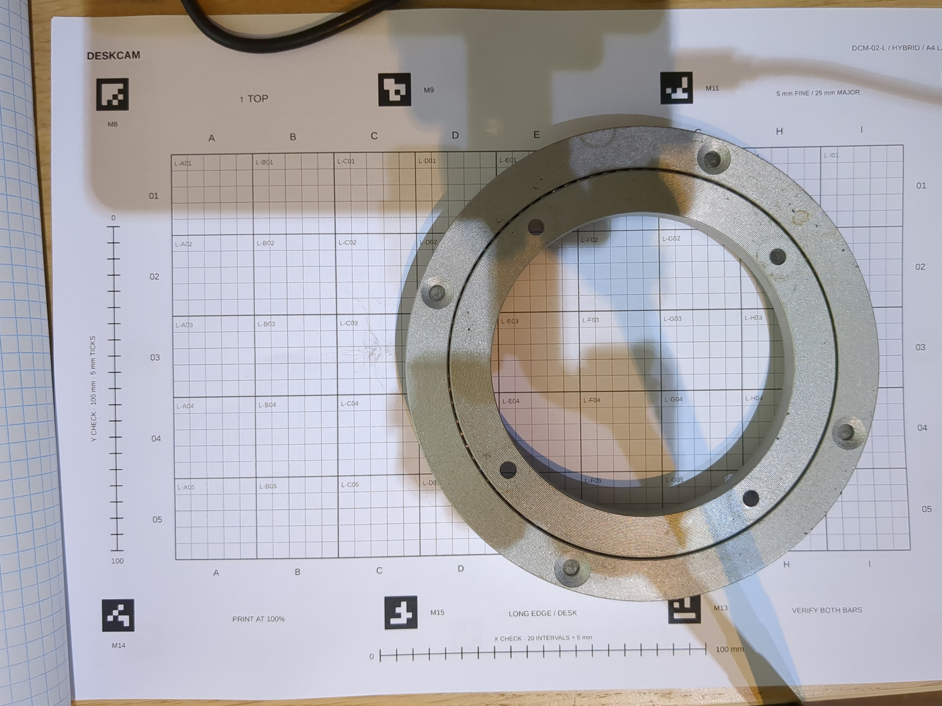
captures/2026-09-12-turntable/bare-wide.jpg
