mattjoyce/xyz-arm/captures/2026-09-12-turntable/edge-left-zoom.jpg

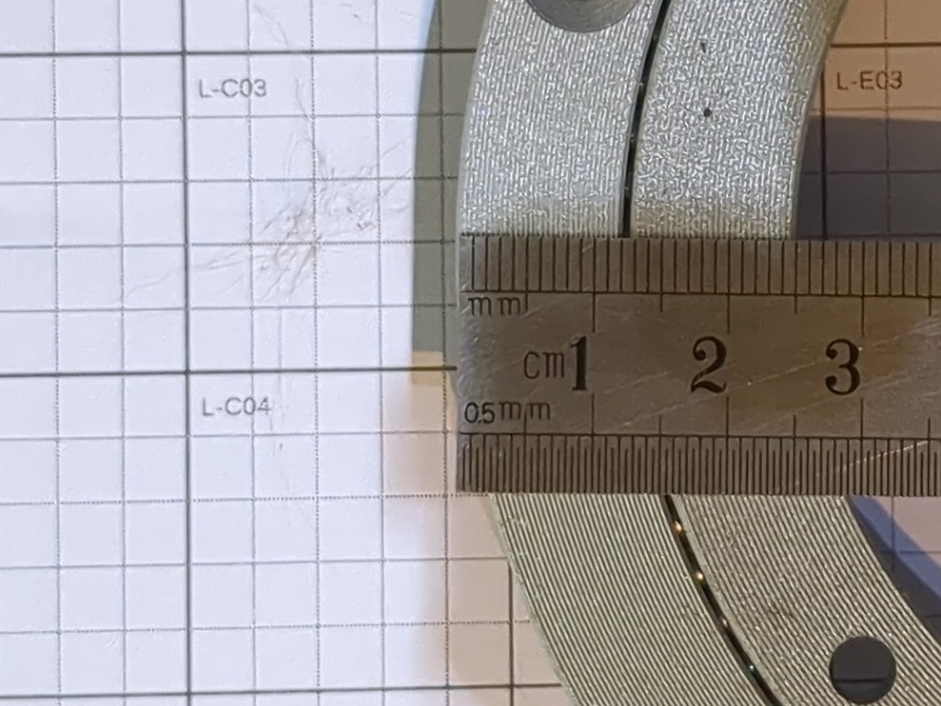
captures/2026-09-12-turntable/edge-left-zoom.jpg
