mattjoyce/xyz-arm/captures/2026-09-12-turntable/edge-right-zoom.jpg

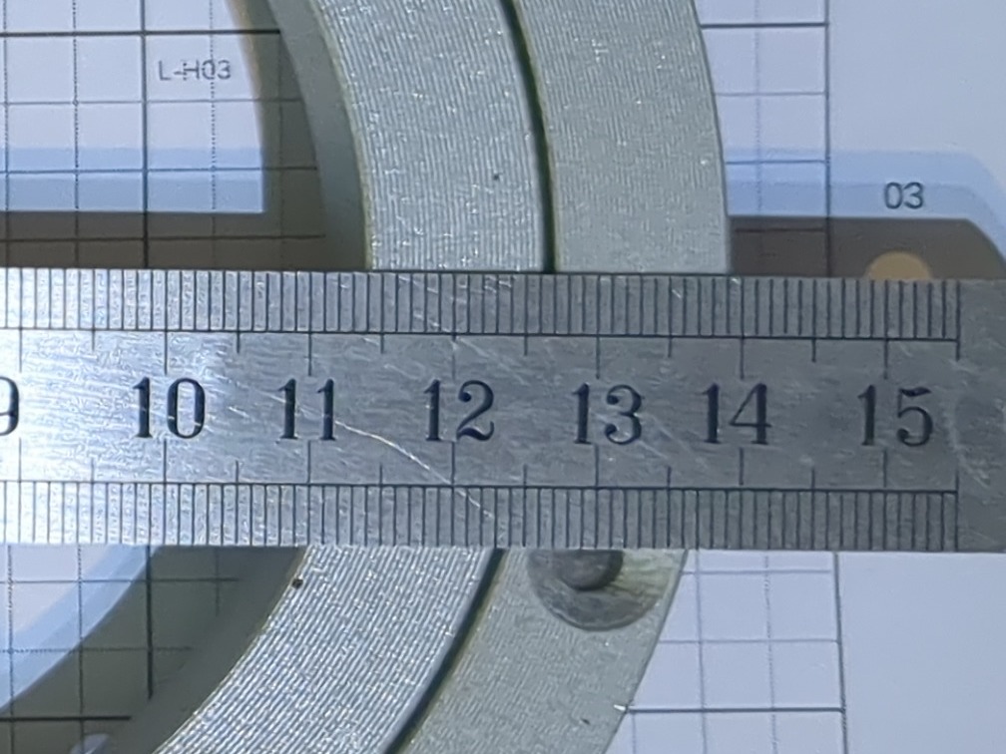
captures/2026-09-12-turntable/edge-right-zoom.jpg
