mattjoyce/xyz-arm/captures/2026-09-12-turntable/precision-check.jpg

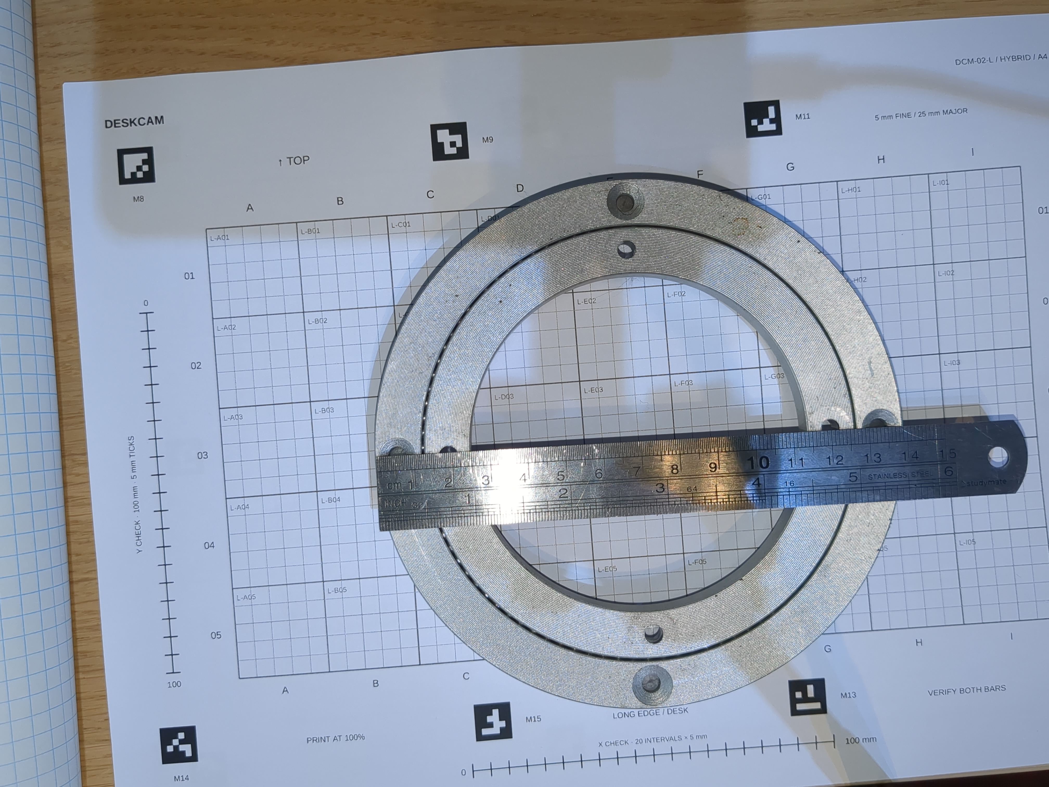
captures/2026-09-12-turntable/precision-check.jpg
