mattjoyce/xyz-arm/captures/2026-09-12-turntable/with-ruler.jpg

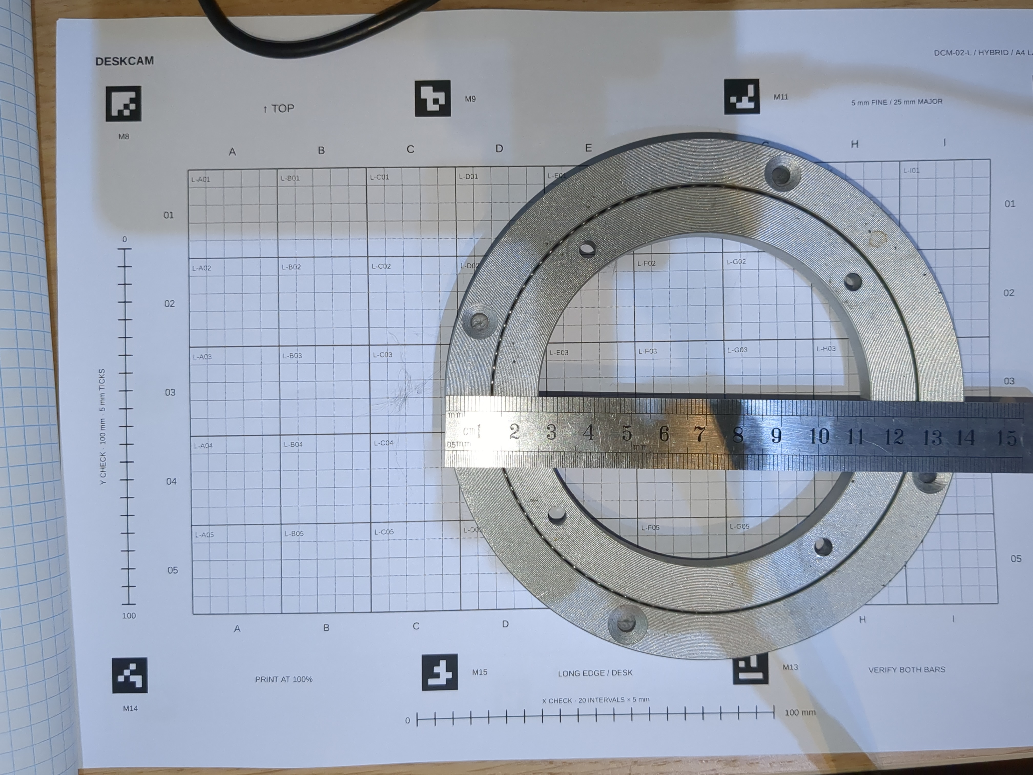
captures/2026-09-12-turntable/with-ruler.jpg
