mattjoyce/xyz-arm/captures/2026-09-20-arm-first-look/2026-09-20-arm-first-look.jpg

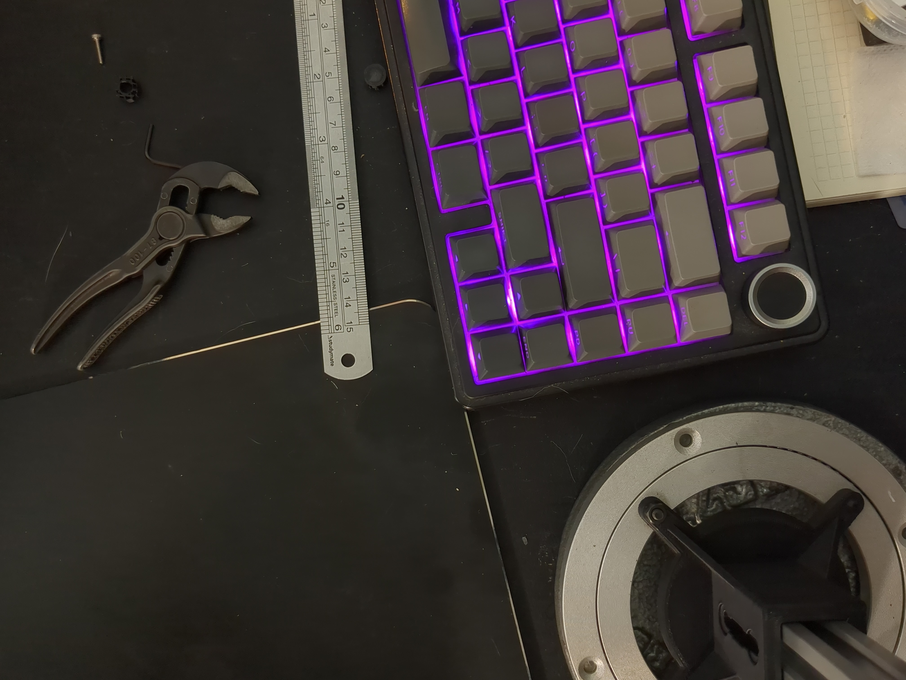
captures/2026-09-20-arm-first-look/2026-09-20-arm-first-look.jpg
