mattjoyce/xyz-arm/knowledge/parts/arm-end-cap.md

---
type: Printed Part
title: Arm end cap
description: A 20 x 20 x 3 press-fit lid for each cut end of the gantry rail; it carries nothing and is not a travel stop.
timestamp: "2026-09-27T00:00:00Z"
status: drawn
resource: cad/parts/arm-end-cap.scad
tags: [gantry]
---

Reuses the [spine cap](/parts/spine-cap.md)'s proven tee-tab press fit by `use`. Square, so
it fits either slot pair. Stays inside the rail section, so wheels roll past it. Print two,
upside down, no support (iteration 58).

# Files

* [`arm-end-cap.scad`](../../cad/parts/arm-end-cap.scad)
* [`arm-end-cap.stl`](../../cad/parts/arm-end-cap.stl)
