mattjoyce/xyz-arm/knowledge/parts/gantry-carriage.md

---
type: Printed Part
title: Gantry carriage (hybrid)
description: A printed three-wheel gantry plate bolted to the bought four-wheel metal spine plate; drawn and dropped the same day.
timestamp: "2026-09-23T00:00:00Z"
status: retired
resource: cad/parts/gantry-carriage.scad
tags: [carriage, retired]
---

Considered when the 3 + 3 [gantry plate](/parts/compact-carriage.md) failed (iteration 49).
Dropped for a fourth printed spine wheel, see [four spine wheels](/decisions/four-spine-wheels.md).
`gantry-carriage-template.stl` is a drilling template.

# Files

* [`gantry-carriage.scad`](../../cad/parts/gantry-carriage.scad)
* [`gantry-carriage.stl`](../../cad/parts/gantry-carriage.stl)
