mattjoyce/xyz-arm/knowledge/parts/pixel6a.md

---
type: Reference Model
title: Pixel 6a
description: "Reference solid for the phone, with each dimension tagged as published spec or still to be measured."
timestamp: "2026-09-12T00:00:00Z"
status: partly measured
resource: cad/parts/pixel6a.scad
tags: [library, payload]
---

152.2 × 71.8 × 8.9 mm, 178 g. Camera bar offset, height and lens centre are tagged
`[MEASURE]`: no trustworthy published figure. Origin is the centre of the phone's back.

# Files

* [`pixel6a.scad`](../../cad/parts/pixel6a.scad)
