mattjoyce/xyz-arm/knowledge/parts/spine-cap.md

---
type: Printed Part
title: Spine cap (V groove)
description: A 20 x 20 press-fit block with a 45 degree V groove carrying the balance line over the spine top; too much capstan friction.
timestamp: "2026-09-19T00:00:00Z"
status: retired
resource: cad/parts/spine-cap.scad
tags: [balance, retired]
---

A 180° groove is a capstan: about 4 to 6 N of friction at 10 N hanging. Replaced by the
[pulley spine cap](/parts/spine-cap-pulley.md) (iteration 25, iteration 31). Its tee-tab press fit lives on
in the [arm end cap](/parts/arm-end-cap.md).

# Files

* [`spine-cap.scad`](../../cad/parts/spine-cap.scad)
* [`spine-cap.stl`](../../cad/parts/spine-cap.stl)
