mattjoyce/xyz-arm/knowledge/parts/turntable-bearing.md

---
type: Reference Model
title: Turntable bearing
description: "Reference model of the salvaged 140 mm lazy-susan bearing; OD and thickness measured, the rest photo estimates."
timestamp: "2026-09-13T00:00:00Z"
status: partly measured
resource: cad/parts/turntable-bearing.scad
tags: [library, base]
---

| Feature | Value | Source |
|---|---|---|
| Outer diameter | 140 mm | Measured by hand |
| Thickness | 8.5 mm | Measured |
| Outer hole PCD | 128 mm | Photo estimate, confirmed by fit test |
| Inner hole PCD | 102 mm | Photo estimate, confirmed by fit test |
| Race boundary | ~114 mm | Photo estimate |

Notes: `cad/studies/turntable-bearing.md`. Photos: [captures](/references/captures.md).

# Files

* [`turntable-bearing.scad`](../../cad/parts/turntable-bearing.scad)
