mattjoyce/xyz-arm/knowledge/parts/vslot-2020.md

---
type: Reference Model
title: V-slot 2020 profile
description: "The OpenBuilds 2020 V-slot section modelled from the published drawing, used by every part that touches a rail."
timestamp: "2026-09-12T00:00:00Z"
status: stable
resource: cad/parts/vslot-2020.scad
tags: [library, rail]
---

20 mm envelope, 9.16 mm V mouth, 6.25 mm throat, 11 mm channel, 90° V, 1.50 mm webs,
Ø4.20 bore. Only the 0.5 mm outer corner radius and 0.2 mm floor notches are estimated
(iteration 4). Source: [OpenBuilds V-slot drawing](/references/openbuilds-vslot-20x20.md).

# Files

* [`vslot-2020.scad`](../../cad/parts/vslot-2020.scad)
