mattjoyce/xyz-arm/knowledge/parts/vslot-wheel.md

---
type: Reference Model
title: Solid V wheel
description: "A nominal Solid V wheel with 625 bearings, for placing wheels at tangency on the V-slot."
timestamp: "2026-09-12T00:00:00Z"
status: stable
resource: cad/parts/vslot-wheel.scad
tags: [library, wheels]
---

23.90 mm OD, 10.23 mm wide, 5.90 mm tread land. Tangency gives a 20.32 mm axle offset from
rail centre (iteration 5). Source: [Solid V wheel kit](/references/solid-v-wheel-kit.md).

# Files

* [`vslot-wheel.scad`](../../cad/parts/vslot-wheel.scad)
