mattjoyce/xyz-arm/knowledge/parts/washer-holder.md

---
type: Printed Part
title: Washer holder
description: "A 50 x 50 plate with an M16 post, bolted onto a V base rail, to park spare counterweight washers."
timestamp: "2026-09-27T00:00:00Z"
status: drawn
resource: cad/parts/washer-holder.scad
tags: [base, counterweight]
---

The [V base](/parts/v-base.md)'s angle bracket with a wider pad. The post is Ø16 × 33, room
for six washers (0.52 kg). `spares` sets the count. The 15 mm overhang each side carries
nothing, since the steel washers sit on the rail through the 2 mm plate (iteration 60).

Outputs: `washer-holder-whole.stl`, `washer-holder-bracket.stl`, `washer-holder-post.stl`.

# Files

* [`washer-holder.scad`](../../cad/parts/washer-holder.scad)
