mattjoyce/xyz-arm/knowledge/parts/weight-base.md

---
type: Printed Part
title: Weighted base
description: A 1.25 kg dumbbell plate clamped between two printed discs as a freestanding foot; the printed parts bent and it was replaced.
timestamp: "2026-09-20T00:00:00Z"
status: retired
resource: cad/parts/weight-base.scad
tags: [base, retired]
---

Thinned through several rounds to 2 mm hub-ring-spoke wheels (iteration 34, iteration 35, iteration 36, iteration 37, iteration 38, iteration 39, iteration 40).
On the bench the rig still leaned and the under ring bent (iteration 43). See
[V base not weighted base](/decisions/v-base-not-weighted-base.md).

Outputs: `weight-base-under.stl`, `weight-base-over.stl`.

# Files

* [`weight-base.scad`](../../cad/parts/weight-base.scad)
