mattjoyce/xyz-arm/knowledge/parts/wheel-spacer.md

---
type: Reference Model
title: Wheel spacers
description: Nominal 6 mm concentric and eccentric spacers; the eccentric offset is 0.395 mm.
timestamp: "2026-09-20T00:00:00Z"
status: stable
resource: cad/parts/wheel-spacer.scad
tags: [library, wheels]
---

8 mm across flats, 10 mm flange, 5 mm bore, 7.0 mm collar measured. `spacer_eccentricity()`
and `spacer_plate_hole()` feed the [gantry plate](/parts/compact-carriage.md) (iteration 8).

# Files

* [`wheel-spacer.scad`](../../cad/parts/wheel-spacer.scad)
