mattjoyce/xyz-arm/references/open-task-light/carriage-body_v1.1.stl

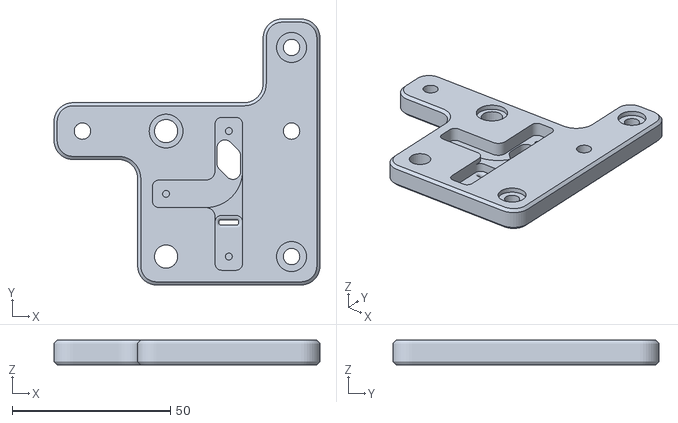
[picture p67: CAD file, 2026-09-19]
references/open-task-light/carriage-body_v1.1.stl
84.2 x 84.2 x 7.80
