mattjoyce/xyz-arm/cad/parts/arm-end-cap.stl

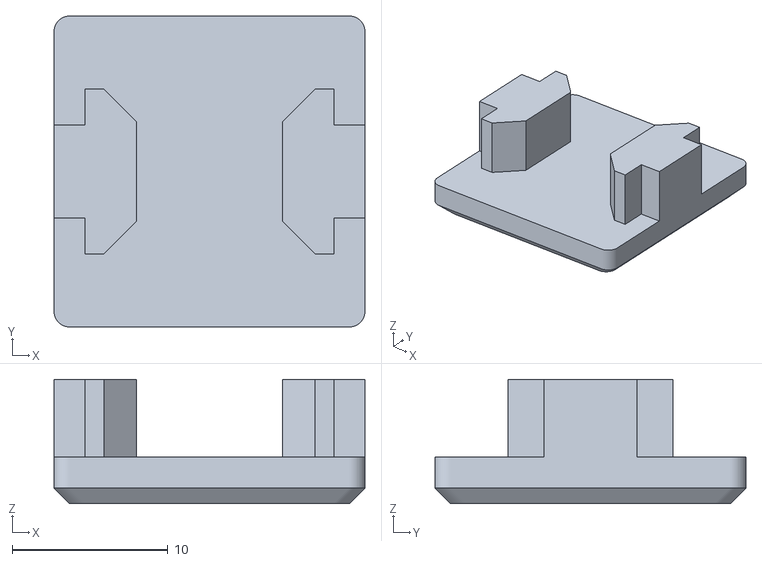
[picture p68: CAD file, 2026-10-26]
cad/parts/arm-end-cap.stl
20.0 x 20.0 x 8.00
