mattjoyce/xyz-arm/cad/parts/arm-strip-collar.stl

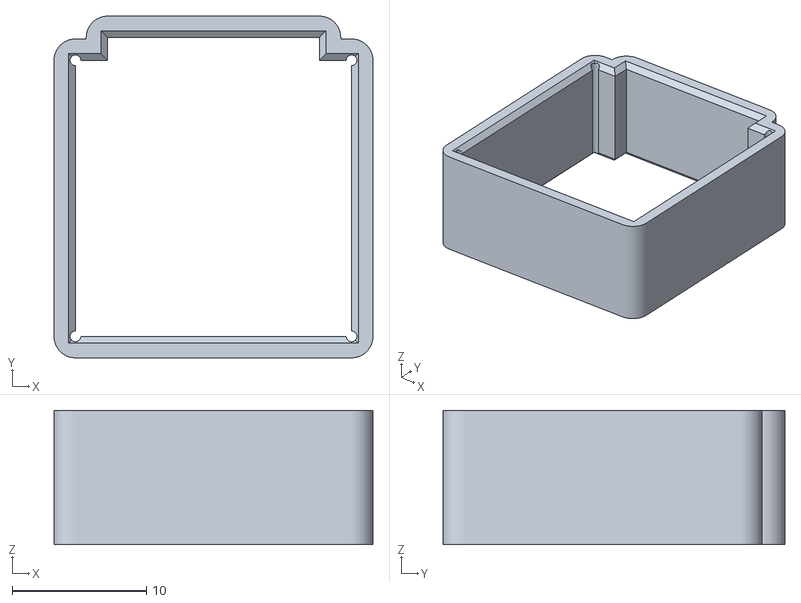
[picture p69: CAD file, 2026-10-26]
cad/parts/arm-strip-collar.stl
23.8 x 25.5 x 10.0
