mattjoyce/xyz-arm/cad/parts/z-base-fins.stl

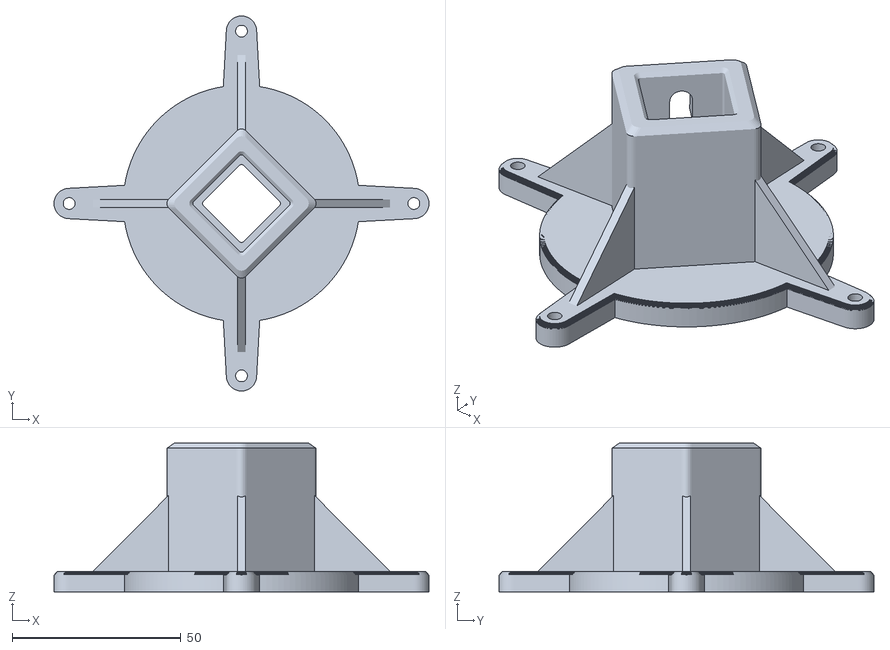
[picture p70: CAD file, 2026-10-26]
cad/parts/z-base-fins.stl
111.0 x 111.0 x 44.0
