mattjoyce/xyz-arm/cad/parts/load-stack-master.stl

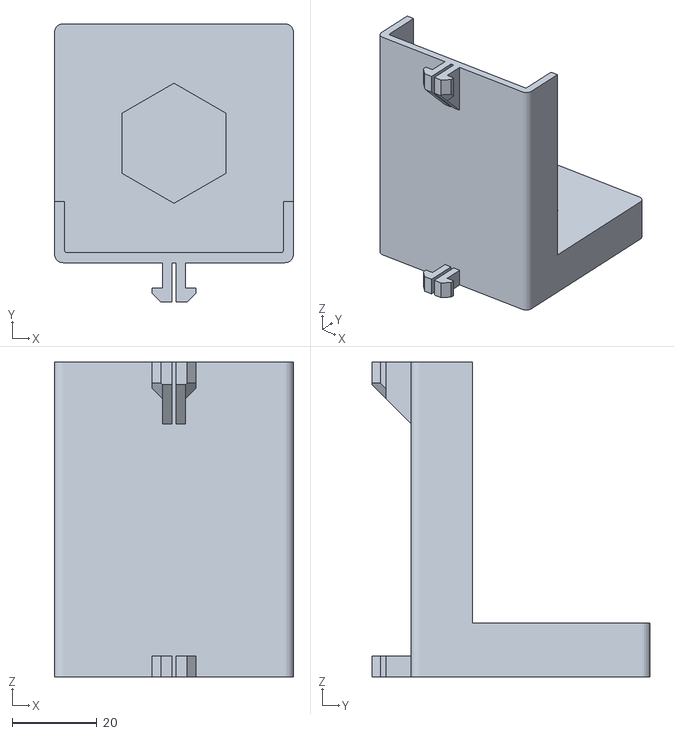
[picture p71: CAD file, 2026-09-26]
cad/parts/load-stack-master.stl
56.3 x 65.6 x 74.2
