mattjoyce/xyz-arm/cad/parts/gantry-carriage.stl

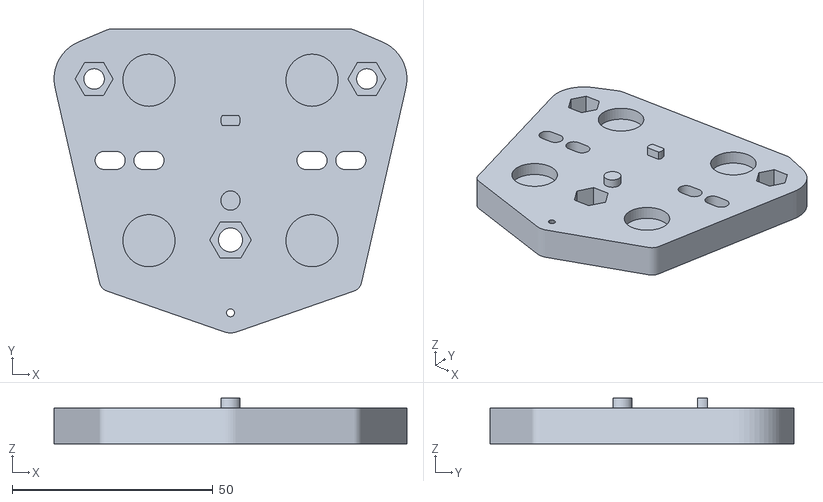
[picture p72: CAD file, 2026-09-24]
cad/parts/gantry-carriage.stl
88.0 x 75.8 x 11.4
