mattjoyce/xyz-arm/cad/parts/compact-carriage-solid.stl

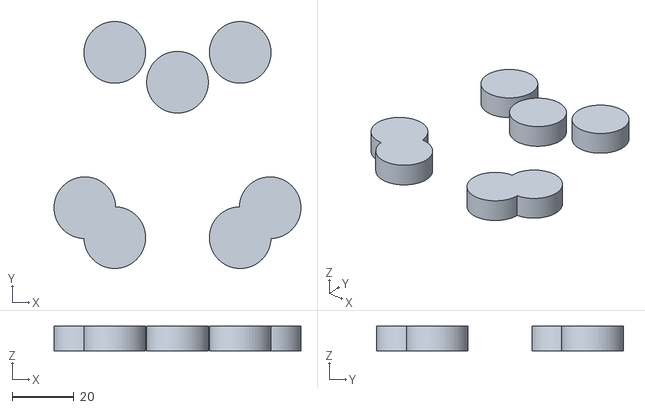
[picture p73: CAD file, 2026-09-24]
cad/parts/compact-carriage-solid.stl
80.0 x 80.0 x 8.00
