mattjoyce/xyz-arm/cad/parts/gantry-carriage-template.stl

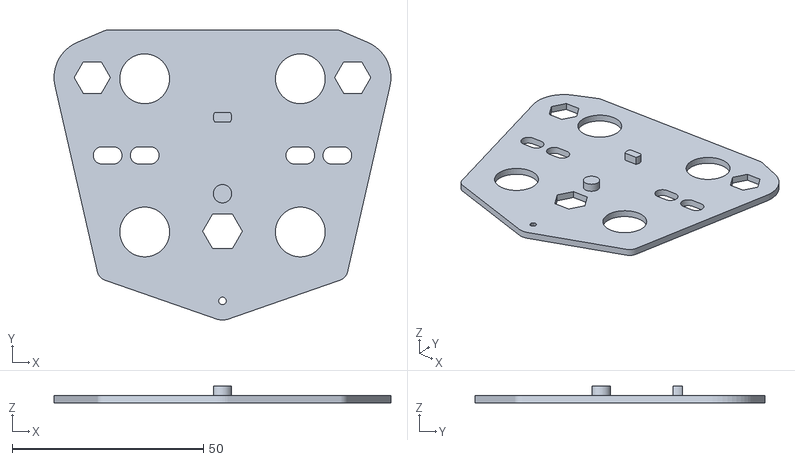
[picture p74: CAD file, 2026-09-24]
cad/parts/gantry-carriage-template.stl
88.0 x 75.8 x 4.40
