mattjoyce/xyz-arm/cad/parts/compact-carriage.stl

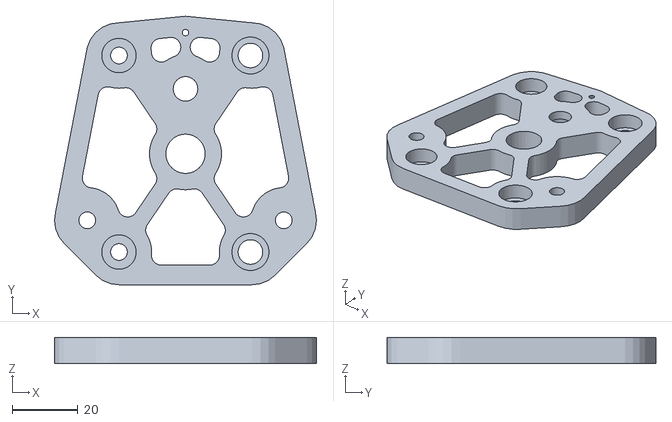
[picture p75: CAD file, 2026-09-24]
cad/parts/compact-carriage.stl
80.0 x 82.0 x 8.00
