mattjoyce/xyz-arm/cad/parts/spine-cap-block.stl

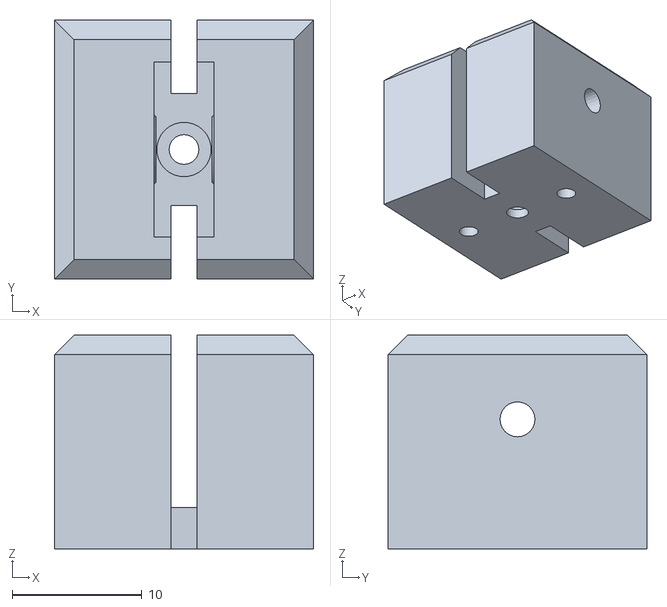
[picture p76: CAD file, 2026-09-24]
cad/parts/spine-cap-block.stl
20.0 x 20.0 x 16.5
