mattjoyce/xyz-arm/cad/parts/weight-base-under.stl

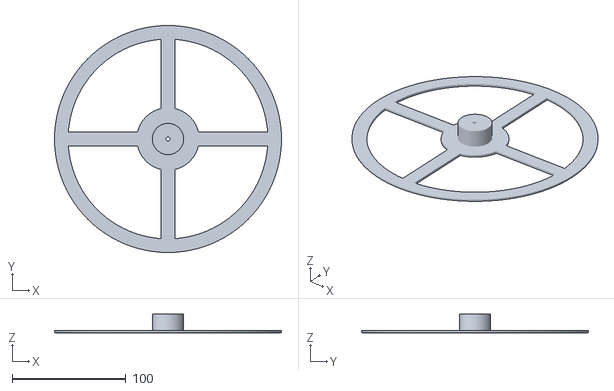
[picture p77: CAD file, 2026-09-24]
cad/parts/weight-base-under.stl
200.0 x 200.0 x 16.5
