mattjoyce/xyz-arm/cad/parts/load-stack.stl

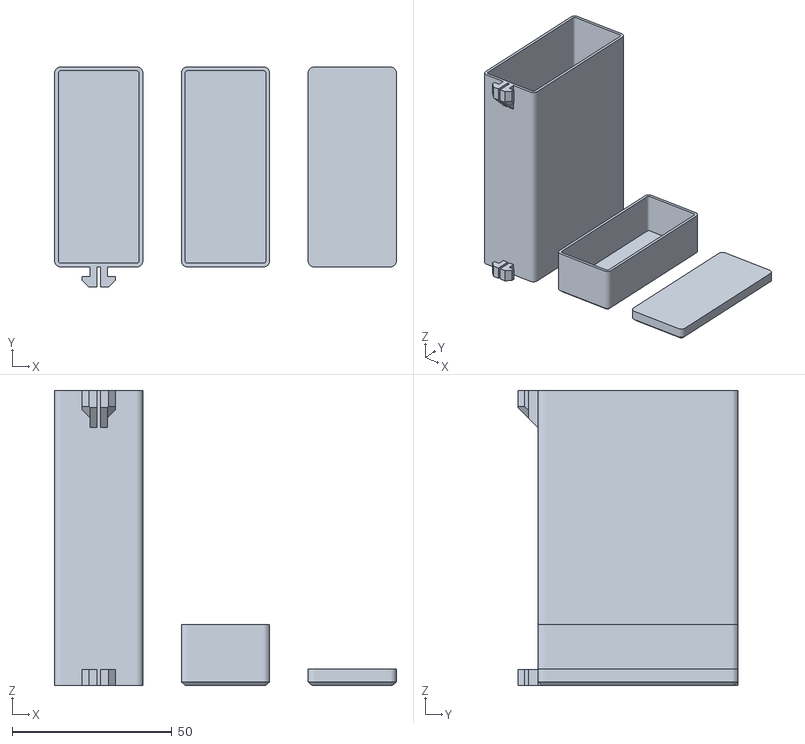
[picture p78: CAD file, 2026-09-24]
cad/parts/load-stack.stl
107.1 x 69.0 x 92.5
