mattjoyce/xyz-arm/cad/parts/spine-cap-plate.stl

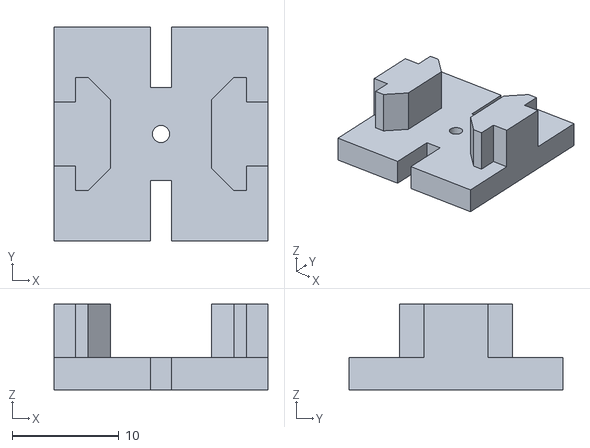
[picture p79: CAD file, 2026-09-24]
cad/parts/spine-cap-plate.stl
20.0 x 20.0 x 8.00
