mattjoyce/xyz-arm/cad/parts/load-stack-test.stl

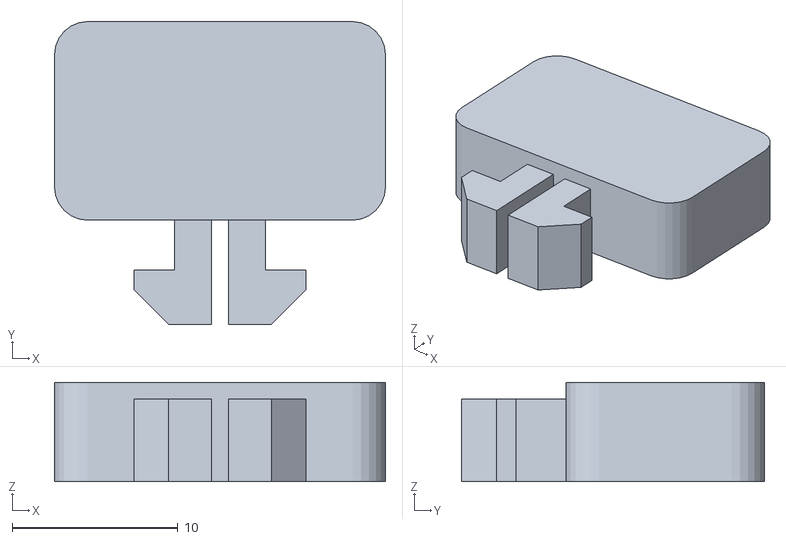
[picture p80: CAD file, 2026-09-24]
cad/parts/load-stack-test.stl
20.0 x 18.3 x 6.00
