mattjoyce/xyz-arm/cad/parts/camera-mount.stl

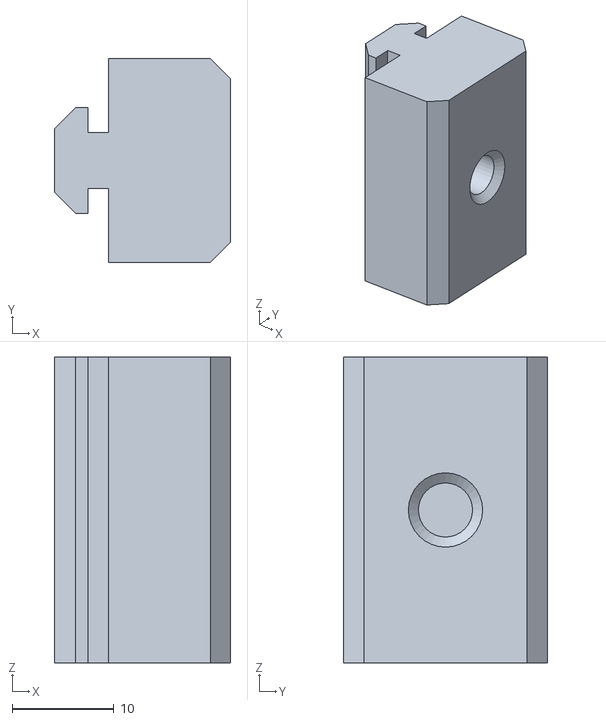
[picture p81: CAD file, 2026-09-24]
cad/parts/camera-mount.stl
17.3 x 20.0 x 30.0
