mattjoyce/xyz-arm/cad/parts/v-base-block.stl

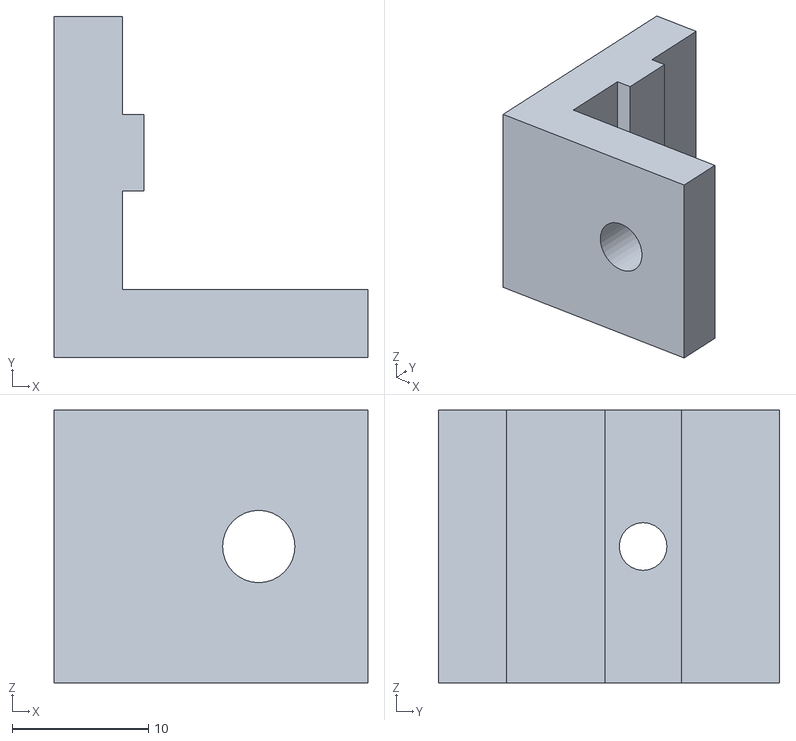
[picture p82: CAD file, 2026-09-24]
cad/parts/v-base-block.stl
23.0 x 25.0 x 20.0
