mattjoyce/xyz-arm/cad/parts/v-base-foot.stl

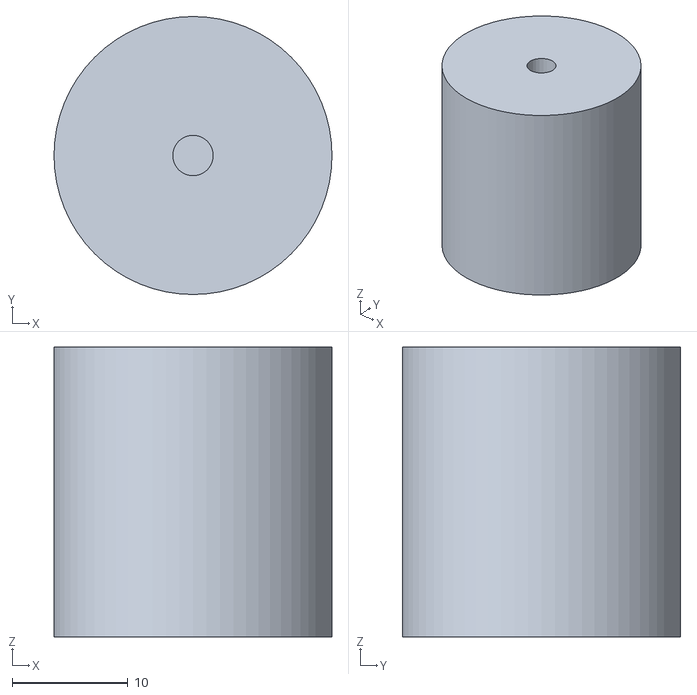
[picture p83: CAD file, 2026-09-24]
cad/parts/v-base-foot.stl
24.0 x 24.0 x 25.0
