mattjoyce/xyz-arm/cad/parts/spine-cap-onepiece.stl

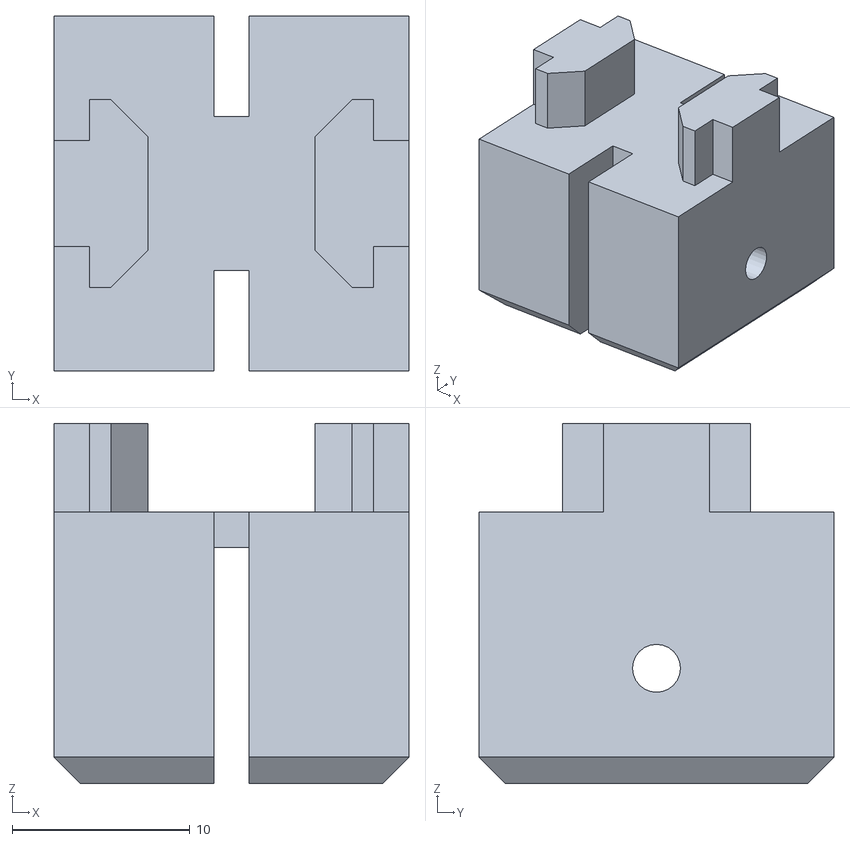
[picture p84: CAD file, 2026-09-24]
cad/parts/spine-cap-onepiece.stl
20.0 x 20.0 x 20.3
