mattjoyce/xyz-arm/cad/parts/weight-base-over.stl

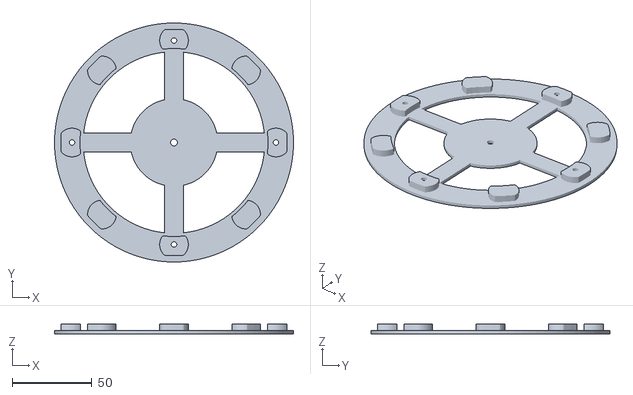
[picture p85: CAD file, 2026-09-24]
cad/parts/weight-base-over.stl
150.0 x 150.0 x 5.99
