mattjoyce/xyz-arm/cad/parts/base-fit-test.stl

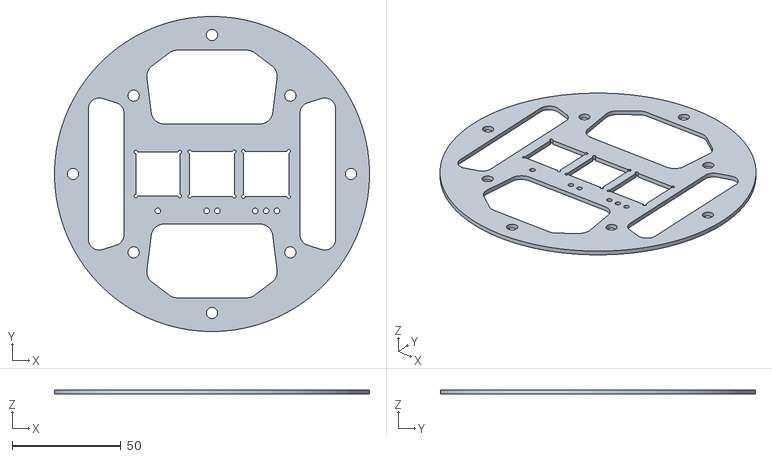
[picture p86: CAD file, 2026-09-19]
cad/parts/base-fit-test.stl
145.0 x 145.0 x 2.00
