mattjoyce/xyz-arm/cad/parts/z-base-fast.stl

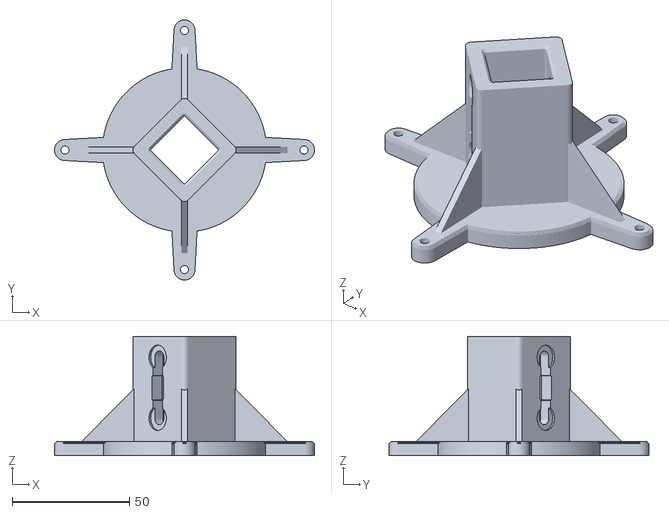
[picture p87: CAD file, 2026-09-19]
cad/parts/z-base-fast.stl
111.0 x 111.0 x 51.0
