mattjoyce/xyz-arm/cad/parts/belt-collar-test.stl

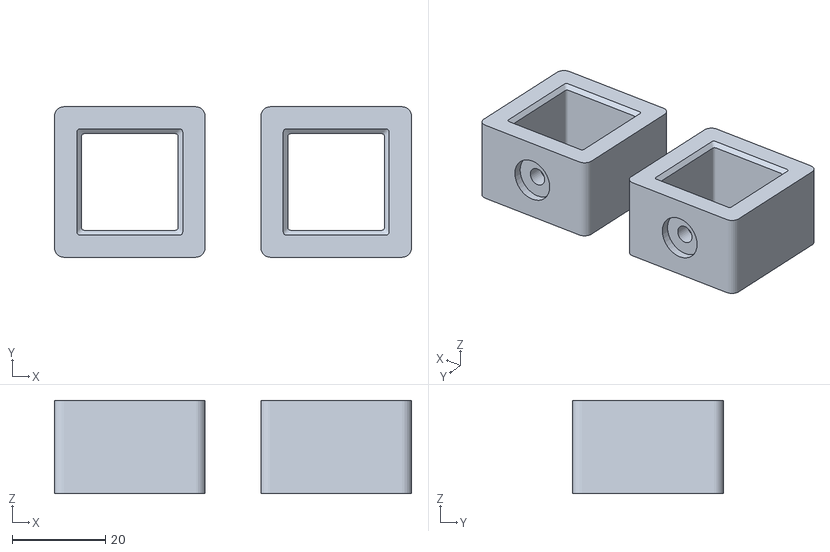
[picture p88: CAD file, 2026-09-19]
cad/parts/belt-collar-test.stl
76.7 x 32.4 x 20.0
