mattjoyce/xyz-arm/cad/parts/load-stack-slide.stl

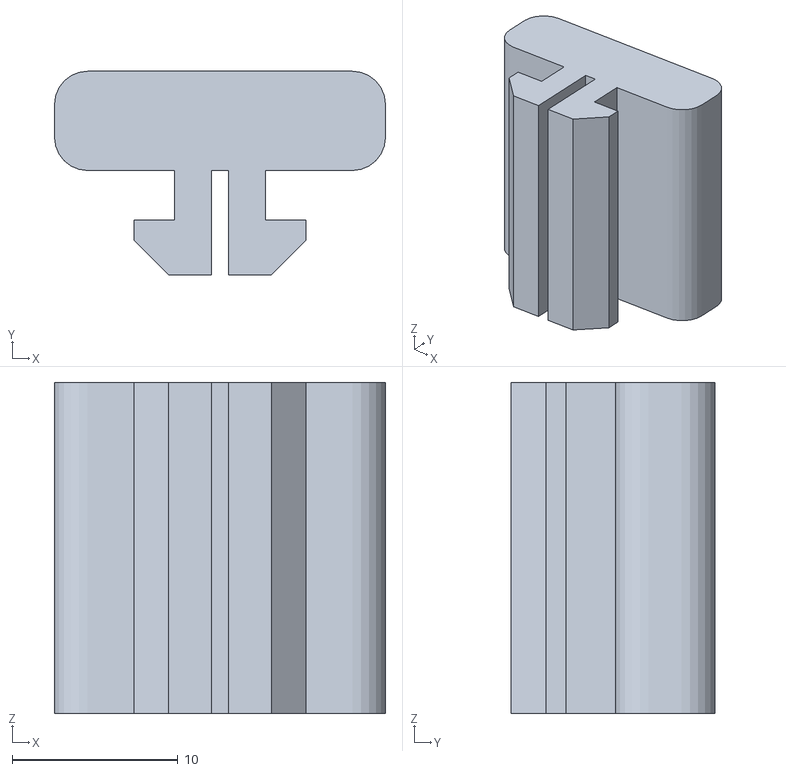
[picture p89: CAD file, 2026-09-19]
cad/parts/load-stack-slide.stl
20.0 x 12.3 x 20.0
