mattjoyce/xyz-arm/cad/parts/socket-test.stl

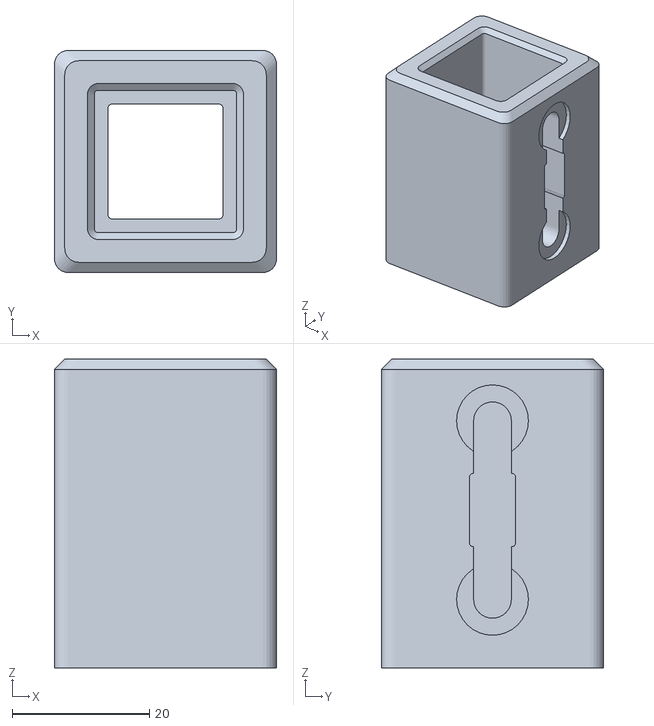
[picture p90: CAD file, 2026-09-19]
cad/parts/socket-test.stl
32.4 x 32.4 x 45.0
