mattjoyce/xyz-arm/cad/parts/slide-test.stl

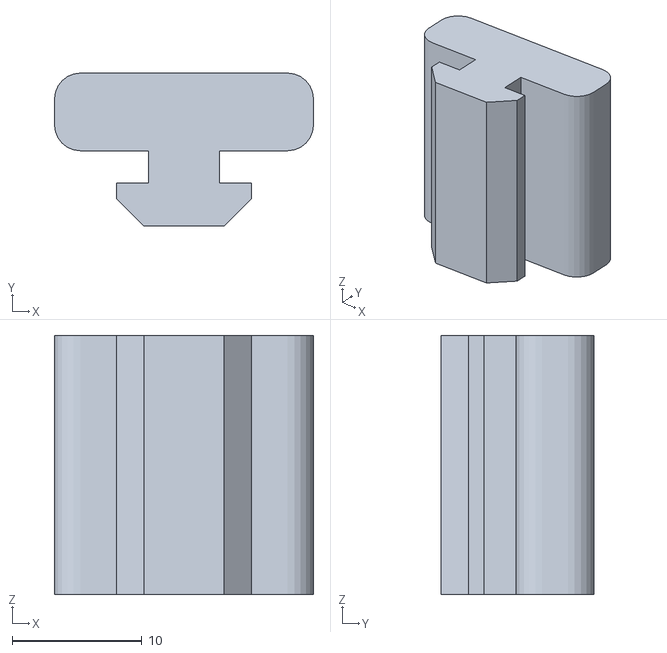
[picture p91: CAD file, 2026-09-19]
cad/parts/slide-test.stl
20.0 x 11.8 x 20.0
