mattjoyce/xyz-arm/cad/parts/z-base.stl

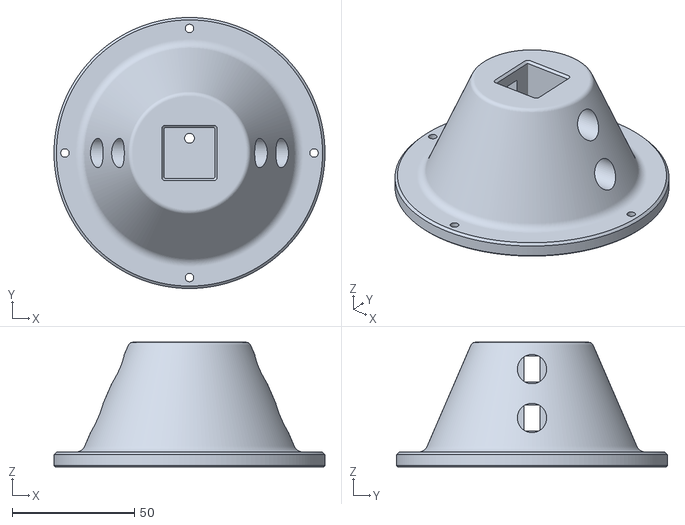
[picture p92: CAD file, 2026-09-19]
cad/parts/z-base.stl
111.0 x 111.0 x 51.0
