mattjoyce/xyz-arm/cad/parts/spine-cap.stl

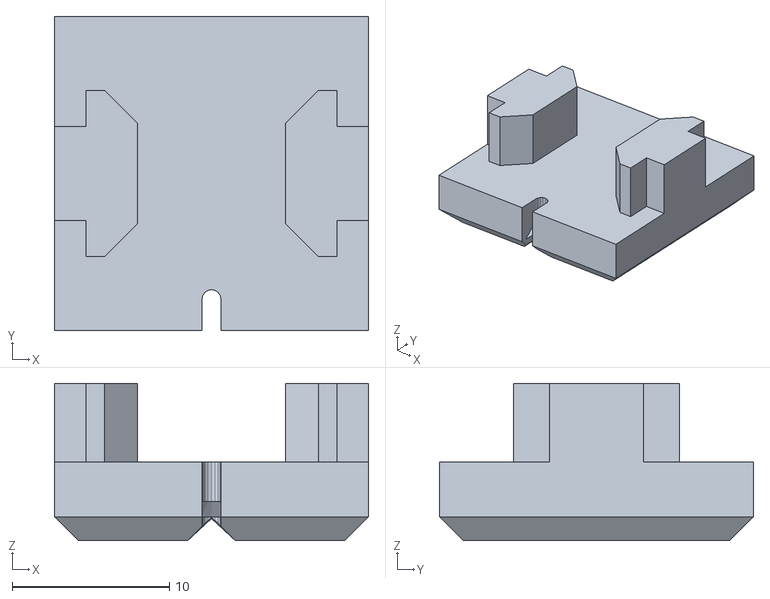
[picture p93: CAD file, 2026-09-19]
cad/parts/spine-cap.stl
20.0 x 20.0 x 10.0
