mattjoyce/xyz-arm/cad/parts/slide-test.scad

// Slide test: one T slider, 20 mm tall on a handle, for the sliding fit up
// and down the spine's rear T-slot. All numbers come from load-stack.scad
// (stem_w, head_w, head_clr, slide_h), so a fit found here is the master's.
// Prints standing, so the section is true.
use <load-stack.scad>
slide_test();
