mattjoyce/xyz-arm/cad/studies/carriage-study.scad

// Open Task Light carriage by Steven Bennett, MIT; see ../../references/open-task-light.
// Original mesh, original orientation and scale.
color([0.9,0.3,0.12]) import("../../references/open-task-light/carriage-body_v1.1.stl",convexity=10);
