mattjoyce/xyz-arm/(list of files, cad)

Other CAD files:
cad/backup/2026-09-23-compact-carriage-3wheel/compact-carriage.scad
cad/backup/2026-09-23-compact-carriage-3wheel/compact-carriage.stl
cad/backup/2026-09-24-load-stack-v7/load-stack-master.stl
cad/backup/2026-09-24-load-stack-v7/load-stack.scad
cad/parts/camera-mount-bolt.stl
cad/parts/washer-holder-bracket.stl
cad/parts/washer-holder-post.stl
cad/parts/washer-holder-whole.stl
