mattjoyce/xyz-arm/knowledge/parts/xyz-arm-assembly.md

---
type: Assembly
title: Concept assembly
description: "The whole arm in OpenSCAD with Customizer controls for gantry height and extension; a spatial blockout, not fabrication CAD."
timestamp: "2026-09-13T00:00:00Z"
status: "concept, partly stale"
resource: cad/xyz-arm.scad
tags: [assembly]
---

Open [`xyz-arm.scad`](../../cad/xyz-arm.scad) and press F5. Z datum is the desk surface.
It still shows the early pot counterweight below the desk and the round Z base on the
bearing; the printed parts have moved on since. Render: [`xyz-arm-preview.png`](../../cad/previews/xyz-arm-preview.png).
