mattjoyce/xyz-arm/knowledge/references/openbuilds-vslot-20x20.md

---
type: Reference
title: OpenBuilds V-slot 20x20 drawing
description: "The manufacturer's drawing and DXF of the 20x20 V-slot profile, source for the rail model and section properties."
timestamp: "2026-09-12T00:00:00Z"
tags: [rail, third-party]
---

Not included in this repository: copyright OpenBuilds. Download it from
<https://openbuilds.com/> and save it as `datasheets/openbuilds-vslot-20x20.pdf` and `.dxf`. Used by [V-slot 2020 profile](/parts/vslot-2020.md) and
[section properties](/references/section-properties.md).
