mattjoyce/xyz-arm/captures/2026-09-13-first-print/bearing-race-boundary.jpg

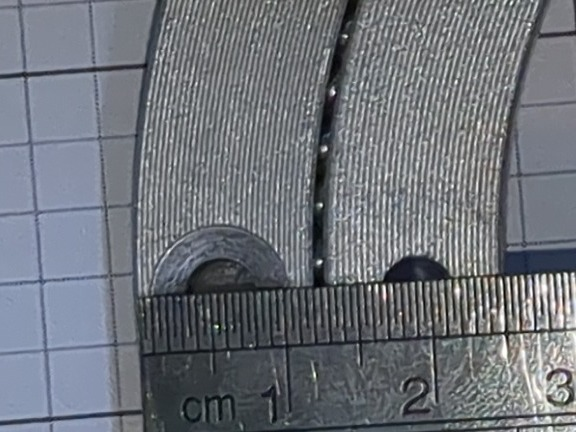
captures/2026-09-13-first-print/bearing-race-boundary.jpg
