mattjoyce/xyz-arm/captures/2026-09-13-first-print/bed-wide-paused.jpg

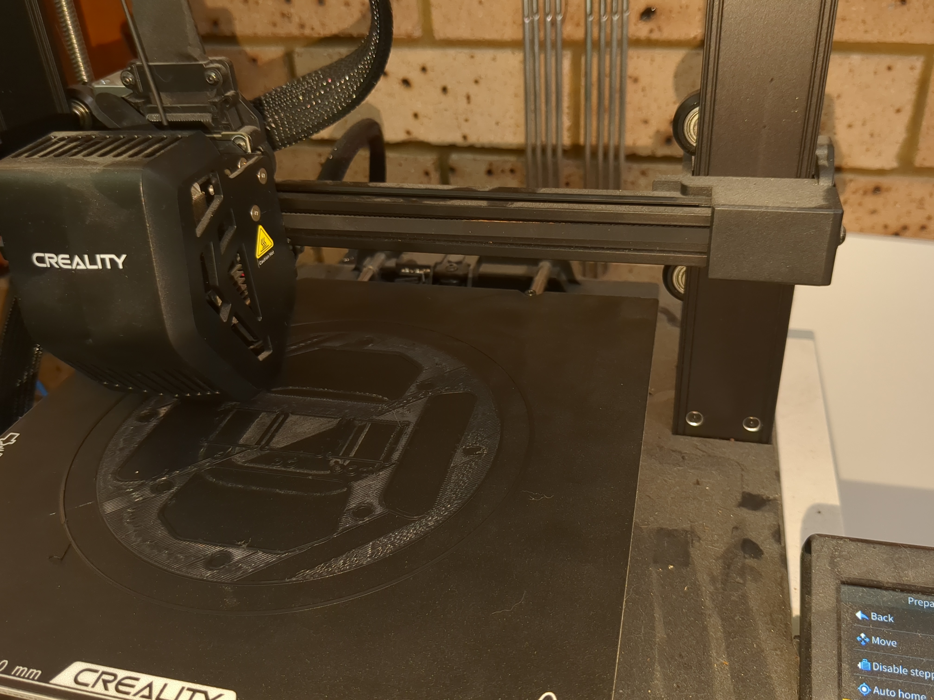
captures/2026-09-13-first-print/bed-wide-paused.jpg
