mattjoyce/xyz-arm/captures/2026-09-13-first-print/bed-wide-printing.jpg

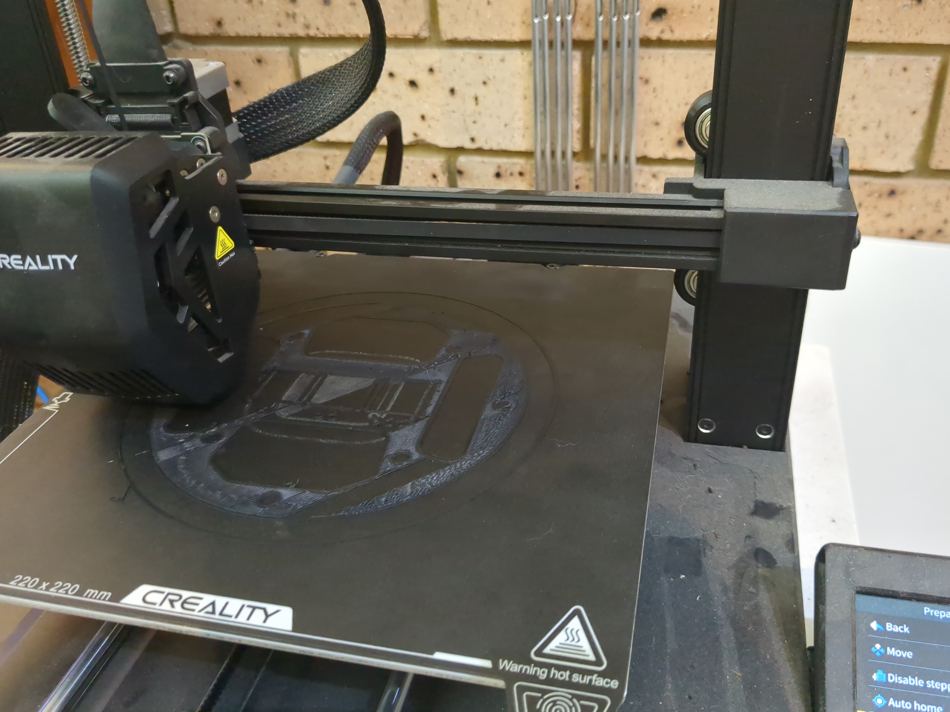
captures/2026-09-13-first-print/bed-wide-printing.jpg
