mattjoyce/xyz-arm/captures/2026-09-13-first-print/layer-torch-paused.jpg

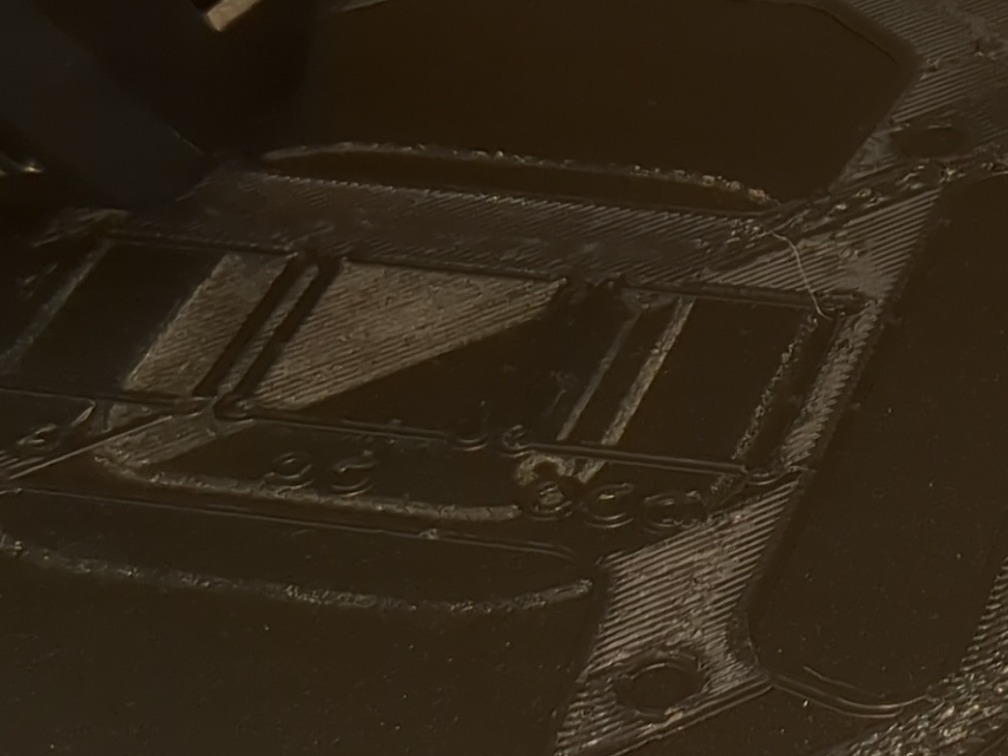
captures/2026-09-13-first-print/layer-torch-paused.jpg
