mattjoyce/xyz-arm/captures/2026-09-13-first-print/raking-apertures.jpg

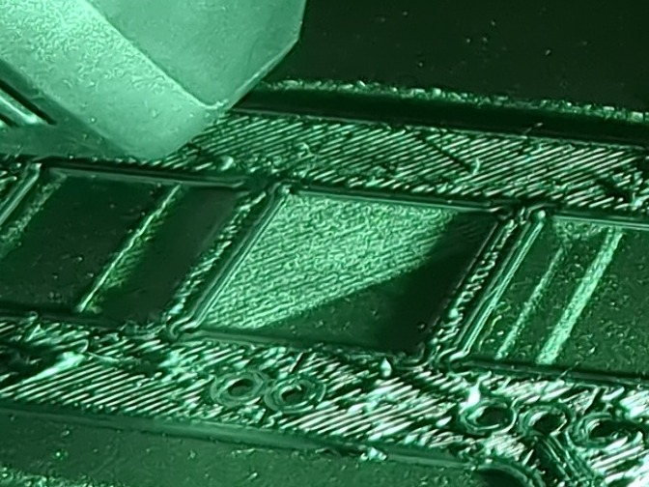
captures/2026-09-13-first-print/raking-apertures.jpg
