mattjoyce/xyz-arm/captures/2026-09-13-print-done/deskcam-20260913-100509.jpg

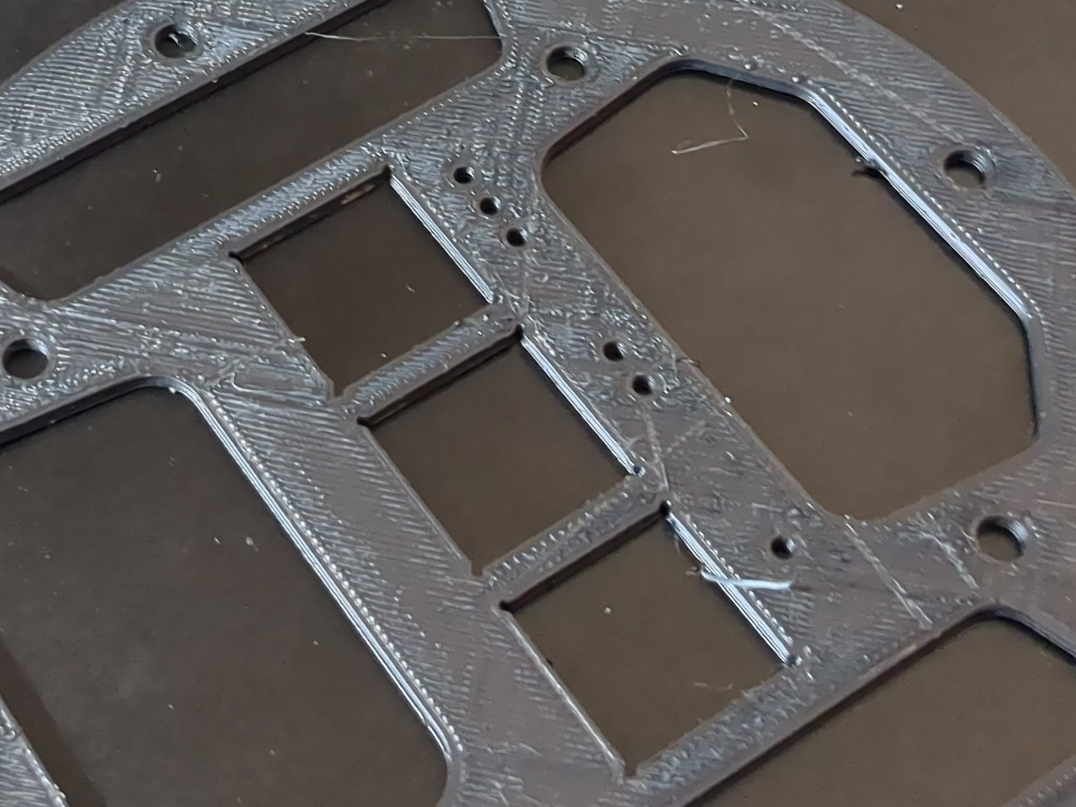
captures/2026-09-13-print-done/deskcam-20260913-100509.jpg
