mattjoyce/xyz-arm/knowledge/parts/belt-collar-test.md

---
type: Test Print
title: Belt collar test
description: "Two collars that anchor a GT2 belt in a spine slot, for the Z brake that was later set aside."
timestamp: "2026-09-19T00:00:00Z"
status: retired
resource: cad/parts/belt-collar-test.scad
tags: [test, retired]
---

Belonged to the belt-and-latch Z brake (iteration 24). Kept as a record; see
[balance not brake](/decisions/balance-not-brake.md).

# Files

* [`belt-collar-test.scad`](../../cad/parts/belt-collar-test.scad)
* [`belt-collar-test.stl`](../../cad/parts/belt-collar-test.stl)
