mattjoyce/xyz-arm/knowledge/parts/slide-test.md

---
type: Test Print
title: Slide test
description: "One T slider on a handle for the load stack's sliding fit in the spine's rear T-slot."
timestamp: "2026-09-19T00:00:00Z"
status: "printed, answered"
resource: cad/parts/slide-test.scad
tags: [test]
---

All numbers come from [load stack](/parts/load-stack.md), so a fit found here is the
master's. Prints standing so the section is true.

# Files

* [`slide-test.scad`](../../cad/parts/slide-test.scad)
* [`slide-test.stl`](../../cad/parts/slide-test.stl)
