mattjoyce/xyz-arm/knowledge/parts/socket-test.md

---
type: Test Print
title: Socket test
description: "Just the fins Z base's boss and bolt stations, built from z-base.scad's own modules so a pass here is a pass on the base."
timestamp: "2026-09-19T00:00:00Z"
status: "printed, answered"
resource: cad/parts/socket-test.scad
tags: [test]
---

Tests the rail fit, the keyhole tee-nut loading and the ledge without printing the whole
[Z base](/parts/z-base.md).

# Files

* [`socket-test.scad`](../../cad/parts/socket-test.scad)
* [`socket-test.stl`](../../cad/parts/socket-test.stl)
