mattjoyce/xyz-arm/cad/previews/belt-collar-test-context.png

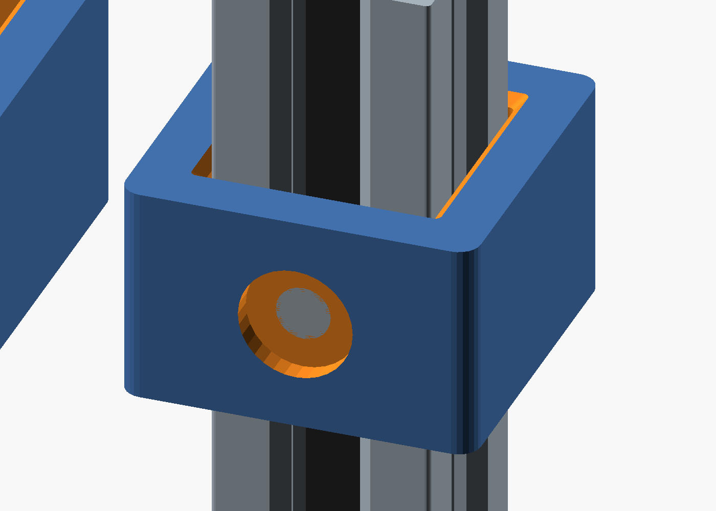
cad/previews/belt-collar-test-context.png
