mattjoyce/xyz-arm/cad/previews/belt-collar-test.png

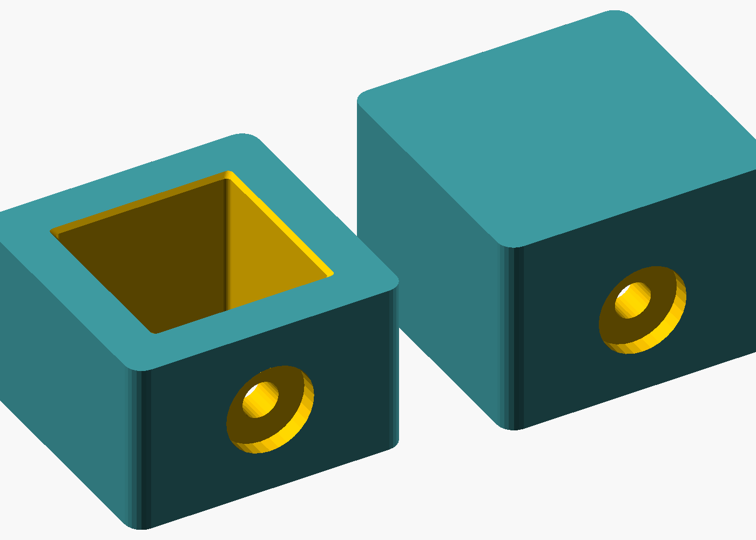
cad/previews/belt-collar-test.png
