mattjoyce/xyz-arm/cad/previews/load-stack-test.png

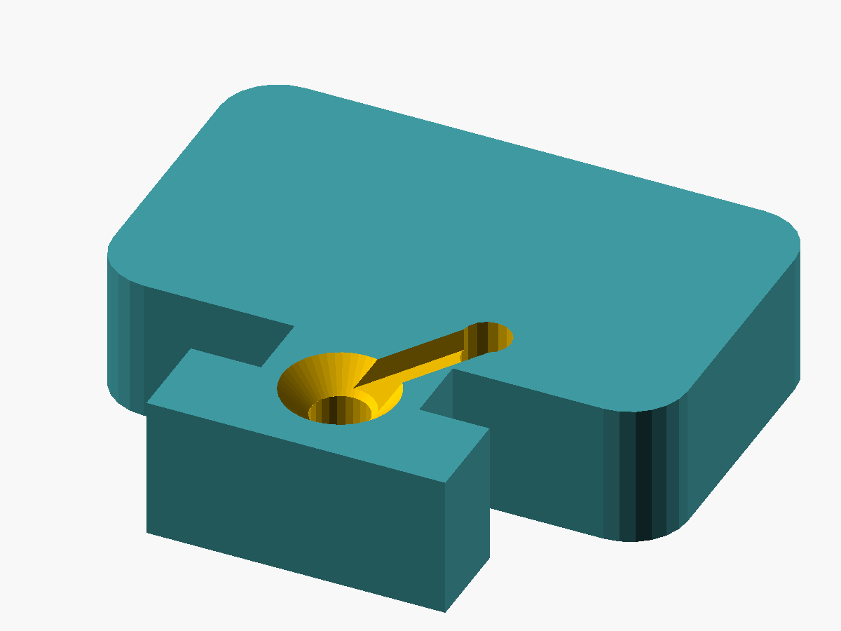
cad/previews/load-stack-test.png
