mattjoyce/xyz-arm/cad/previews/socket-test-under.png

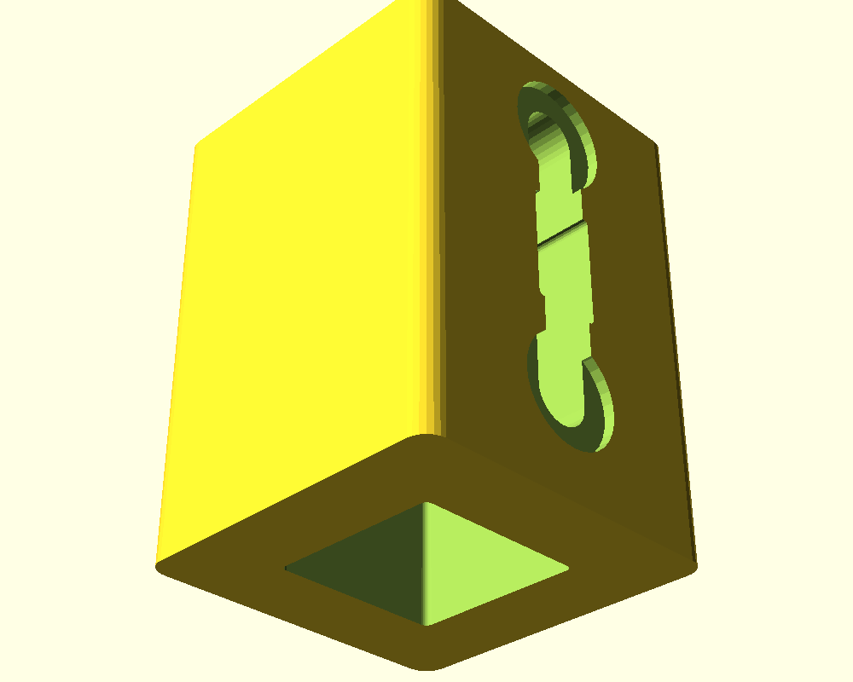
cad/previews/socket-test-under.png
