mattjoyce/xyz-arm/cad/previews/socket-test.png

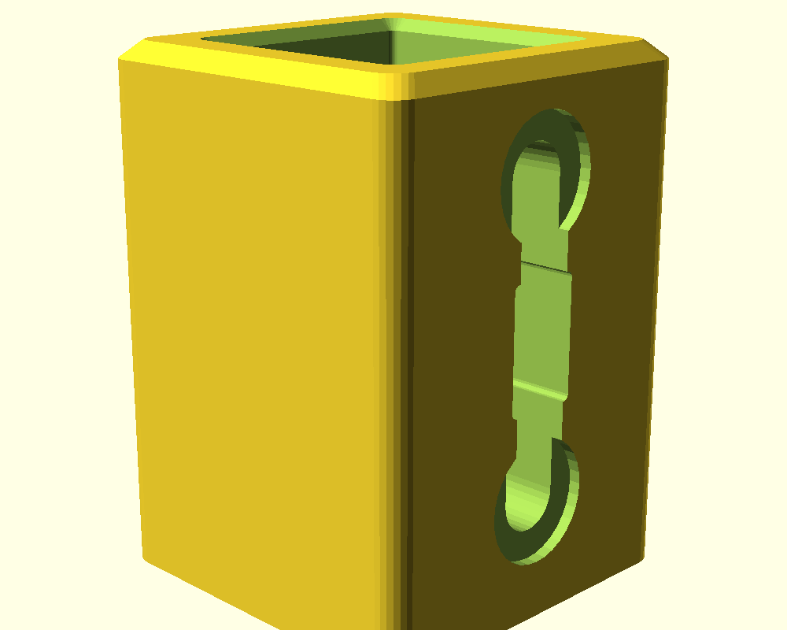
cad/previews/socket-test.png
