mattjoyce/xyz-arm/knowledge/references/design-log.md

---
type: Design Log
title: CAD design log
description: "cad/README.md: one numbered iteration paragraph per change to the CAD, 60 iterations from first blockout to the washer holder."
timestamp: "2026-09-27T00:00:00Z"
resource: cad/README.md
tags: [log]
---

[`cad/README.md`](../../cad/README.md) is the authoritative record of what each part is and why.
Every concept in this bundle cites iteration numbers from it. When the two disagree, the
log is newer.
