mattjoyce/xyz-arm/(commit log)

2026-09-19 XYZ arm: base, spine cap, load stack and belt collar test
    Design record to 2026-09-19: the fins base with its socket and keyhole tee
    bolts, the square spine cap with the V groove and drop slit, the load stack
    as a sleeve round the lead block on T sliders in the rear channel, the
    slide and fit test pieces, and the belt collar test. Notes and README
    carry the reasoning, including the guide lines that were tried and given up.
    Claude-Session: https://claude.ai/code/session_01RpXq4SMMgZJ2bGL8CrGeme
    [base-fit-test.scad, base-fit-test.stl, belt-collar-test.scad, belt-collar-test.stl, carriage-body_v1.1.stl, carriage-study.scad, compact-carriage.scad, load-stack-master.stl]
2026-09-19 Load stack: bottom slider 10 mm
    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
    [load-stack-master.stl, load-stack.scad, load-stack.stl]
2026-09-24 XYZ arm: V base, weight base, pulley spine cap, camera mount, carriage eccentrics
    Uncommitted work from the sessions up to 2026-09-21, as it stood before
    the carriage rework: design log iterations up to 48. Gantry plate with
    eccentric spacers (iterations 29, 30, 46), load stack slider taper, spine
    cap pulley version, weight base, V base with angle blocks, camera mount
    bolt style, and the arm first-look capture.
    [camera-mount-bolt.stl, camera-mount.scad, camera-mount.stl, compact-carriage.scad, compact-carriage.stl, load-stack-master.stl, load-stack-test.stl, load-stack.scad]
2026-09-24 Carriage: fourth spine wheel, 7.5 eccentric holes; load stack: washer frame
    Design log iterations 49 to 55.
    - Gantry plate: second eccentric on the spine side, so the arm's moment
    is a diagonal couple over 60 mm (50). Eccentric collar holes 7.31 to
    7.5, which printed very tight (51). Cura modifier cylinders for solid
    bolt surrounds, compact-carriage-solid.stl.
    - Metal-plate hybrid, gantry-carriage.scad, drawn and dropped (49).
    - Load stack v8: Bunnings 50 x 50 x 5 square washers, 79.68 g each,
    on an M16 stem, with only the front wall and its corner legs; 3.5 off
    the rail to clear the carriage nuts (52 to 55). use_washers = false
    gives v7.
    - Backups of the 3 + 3 carriage and load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
    [compact-carriage-solid.scad, compact-carriage-solid.stl, compact-carriage.scad, compact-carriage.stl, gantry-carriage-template.stl, gantry-carriage.scad, gantry-carriage.stl, load-stack-master.stl]
2026-09-26 Load stack: M16 bolt as the stem, 2 mm clear of the carriage nylocs
    Design log iterations 56 and 57. Twelve 86 g M16 square washers on an
    M16 x 65 hex bolt, head sunk in a hex pocket in a 12.7 floor: 1.161 kg.
    Front wall 4.0 off the rail's rear face, 2.0 behind the nylocs.
    [load-stack-master.stl, load-stack.scad]
2026-10-26 Arm end caps, strip collar, washer holder; fins base loses the guide-line groove
    Iterations 58-60 in cad/README.md.
    Claude-Session: https://claude.ai/code/session_01UzcwTn24MTPipqmjawojGS
    [arm-end-cap.scad, arm-end-cap.stl, arm-strip-collar.scad, arm-strip-collar.stl, washer-holder-bracket.stl, washer-holder-post.stl, washer-holder-whole.stl, washer-holder.scad]
